SaulOrtegaVaz/ROMEO/Memoria/Bibliografia.docx

# Bibliografía

[1] Juan González Gómez. Robótica modular y locomoción: Aplicación a robots ápodos, 2008.

[2] Juan González Gómez. Diseño de robots ápodos, 2003.

[3] Mark Yim, Paul White, Michael Park, Jimmy Sastra, School of Engineering and Applied Science University of Pennsylvania. Modular Self-Reconfigurable Robots.

[4] Robo-wunderkind. The Story of Robo-Wunderkind. Disponible en línea en: http://robowunderkind.com/

[5] MIT Media Lab y Stanford University. LineFORM: Actuated Curve Interfaces for Display, Interaction, and Constraint, 2015. Disponible en línea en: http://tangible.media.mit.edu/papers/

[6] MIT Media Lab y Stanford University. ChainFORM: A Linear Integrated Modular Hardware System for Shape Changing Interfaces, 2015. Disponible en línea en: http://tangible.media.mit.edu/papers/

[7] Ivan Grokhotkov. ESP8266 Arduino Core Documentation, 2017. Disponible en línea en: https://arduino-esp8266.readthedocs.io/en/latest/index.html

[8] Espressif Systems. ESP8266EX datasheet, versión 5.8, 2018. Disponible en línea en: https://www.espressif.com/en

[9] Espressif Systems. ESP8266 Technical Reference, versión 1.3, 2017. Disponible en línea en: https://www.espressif.com/en

[10] Alberto Brunete, Avinash Ranganath, Sergio Segovia, Javier Perez de Frutos, Miguel Hernando and Ernesto Gambao, International Journal of Advanced Robotic Sistems. Current trends in reconfigurable modular robots design, 2017.

[11] Castano A, Shen WM and Will P. CONRO: towards deployable robots with inter-robots metamorphic capabilities. Auton Robot 2000; 8(3): 309–324.

[12] Castano A, Behar A and Will P. The Conro modules for reconfigurable robots. IEEE/ASME Trans Mech 2002; 7(4): 403–409.

[13] Yim M, Duff D and Roufas K. Polybot: a modular reconfigurable robot. In: Proceedings of the 2000 IEEE international conference on robotics and automation, 2000, pp. 514–520.

[14] Salemi B, Moll M and Shen WM. Superbot: a deployable, multi-functional, and modular self-reconfigurable robotic system. In: 2006 IEEE/RSJ international conference on intelligent robots and systems, 2006, pp. 3636–3641.

[15] Murata S, Yoshida E, Kamimura A, et al. M-tran: selfreconfigurable modular robotic system. IEEE/ASME Trans Mech 2002; 7(4): 431–441.

[16] Kurokawa H, Kamimura A, Yoshida E, et al. M-tran ii: metamorphosis from a four-legged walker to a caterpillar. In: Proceedings of the 2003 IEEE/RSJ international conference on intelligent robots and systems, Vol. 3, 2003, pp. 2454–2459.

[17] M. Yim. Locomotion with a unit-modular reconfigurable robot. PhD thesis, Stanfofd University, December 1995. Disponible en línea en:

http://www-db.stanford.edu/TR/CS-TR-95-1536.html

[18] Jørgensen M, Østergaard E, Lund H. Modular ATRON: modules for a self-reconfigurable robot. In: Proceedings of the 2004 IEEE/RSJ International Conference on Intelligent Robots and Systems (IROS), October 2004, pp 2068–2073.
