SaulOrtegaVaz/ROMEO/Alimentacion.FCStd

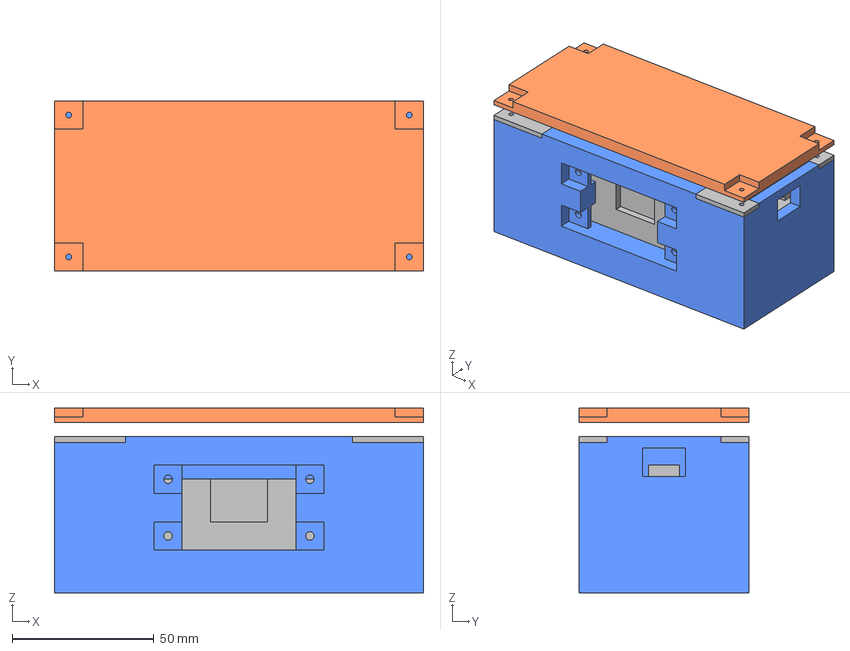
[picture p60: CAD file, 2018-03-30]
Alimentacion.FCStd
130.0 x 60.0 x 65.0 mm
Tapa
Carcasa_Alimentacion_final
Soporte
