SaulOrtegaVaz/ROMEO/Memoria/Planos/Alimentacion/Alimentacion_SeccionXZ.FCStd

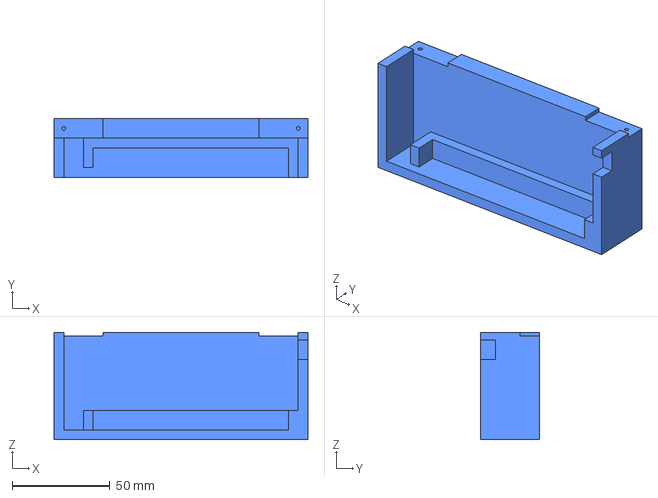
[picture p61: CAD file, 2019-01-21]
Memoria/Planos/Alimentacion/Alimentacion_SeccionXZ.FCStd
130.0 x 30.0 x 55.0 mm
