SaulOrtegaVaz/ROMEO/stl/ConectorMSup.stl

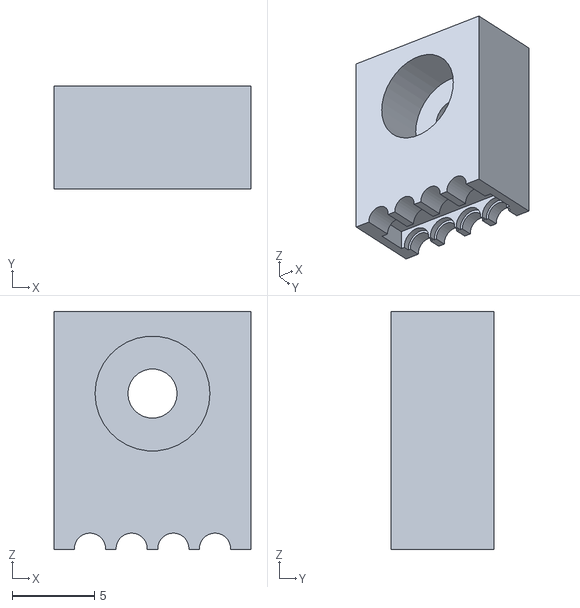
[picture p62: CAD file, 2018-06-27]
stl/ConectorMSup.stl
12.0 x 6.25 x 14.5
