SaulOrtegaVaz/ROMEO/Control.FCStd

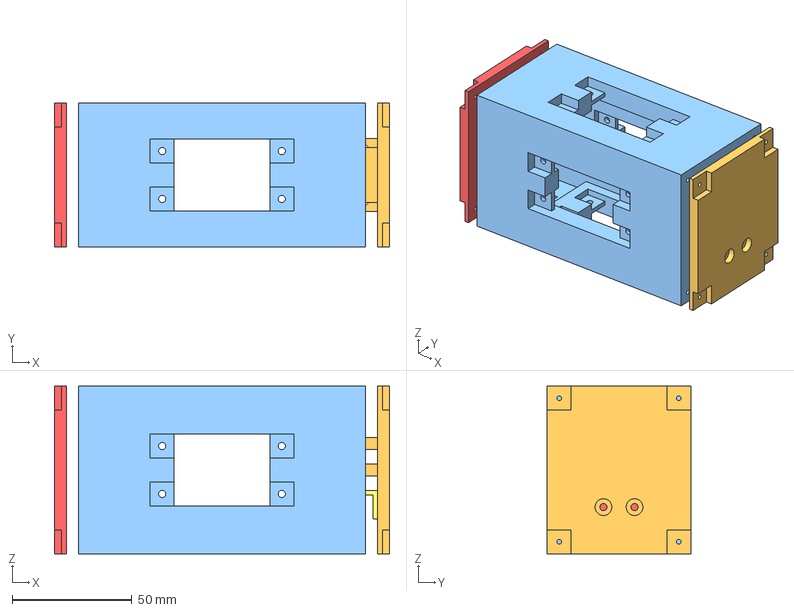
[picture p63: CAD file, 2018-03-30]
Control.FCStd
140.0 x 60.0 x 70.0 mm
TapaA
Carcasa_Control
SoporteMovil
TapaB
