SaulOrtegaVaz/ROMEO/Memoria/Planos/Alimentacion/Alimentacion_SeccionYZ.FCStd

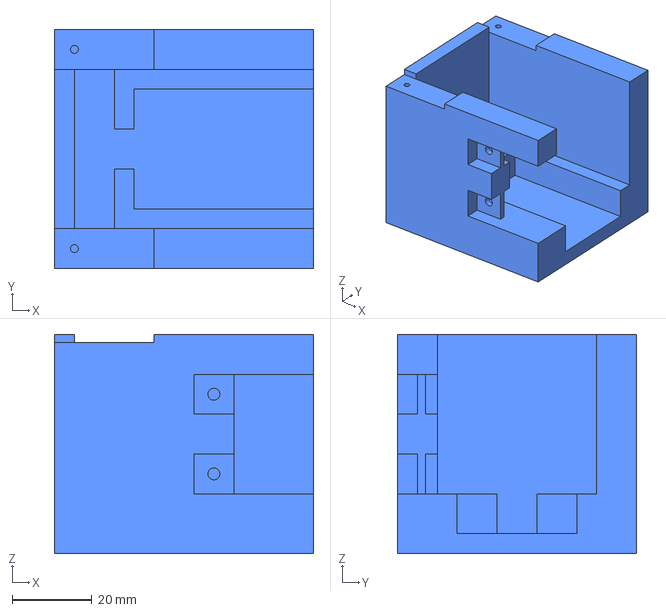
[picture p64: CAD file, 2019-01-21]
Memoria/Planos/Alimentacion/Alimentacion_SeccionYZ.FCStd
65.0 x 60.0 x 55.0 mm
