SaulOrtegaVaz/ROMEO/stl/ConectorSUP.stl

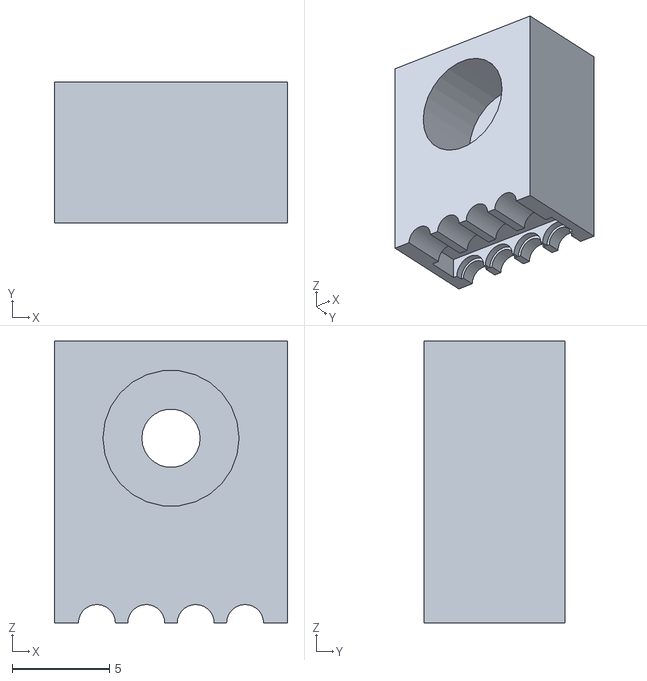
[picture p65: CAD file, 2018-06-27]
stl/ConectorSUP.stl
12.0 x 7.25 x 14.5
