SaulOrtegaVaz/ROMEO/Conector.FCStd

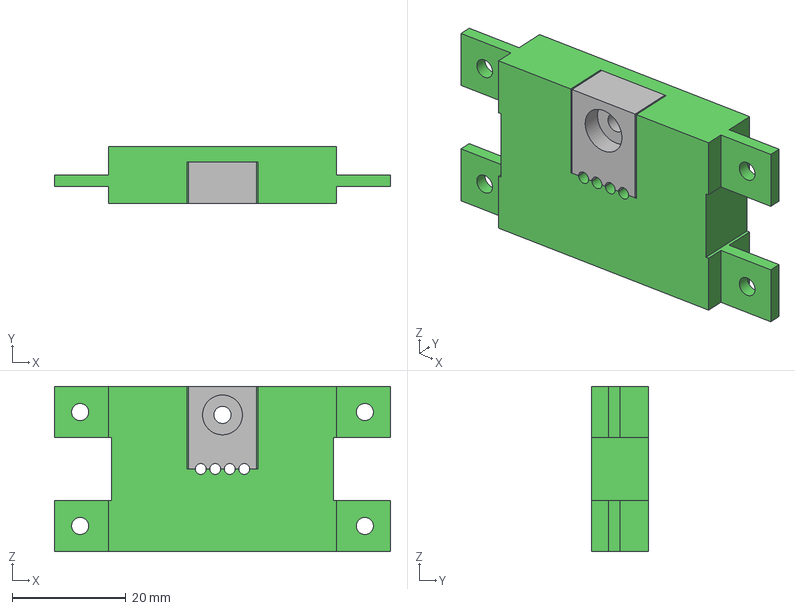
[picture p66: CAD file, 2018-03-09]
Conector.FCStd
59.0 x 10.0 x 29.0 mm
Imanes20x10x3
Conector_ParteSUP
Conector_ParteINF
