SaulOrtegaVaz/ROMEO/stl/ConectorMInf.stl

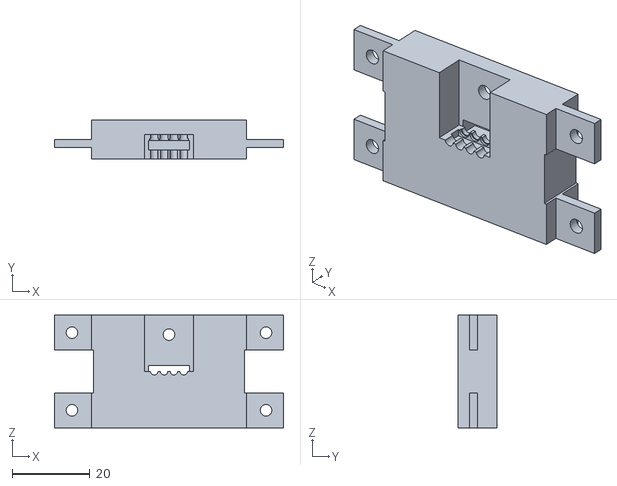
[picture p67: CAD file, 2018-06-04]
stl/ConectorMInf.stl
59.0 x 10.0 x 29.0
