SaulOrtegaVaz/ROMEO/Comunicacion.FCStd

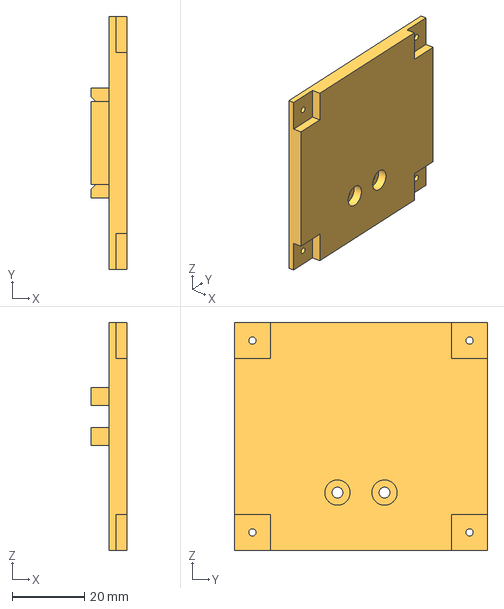
[picture p68: CAD file, 2018-03-09]
Comunicacion.FCStd
10.0 x 70.0 x 63.0 mm
