SaulOrtegaVaz/ROMEO/Locomocion.FCStd

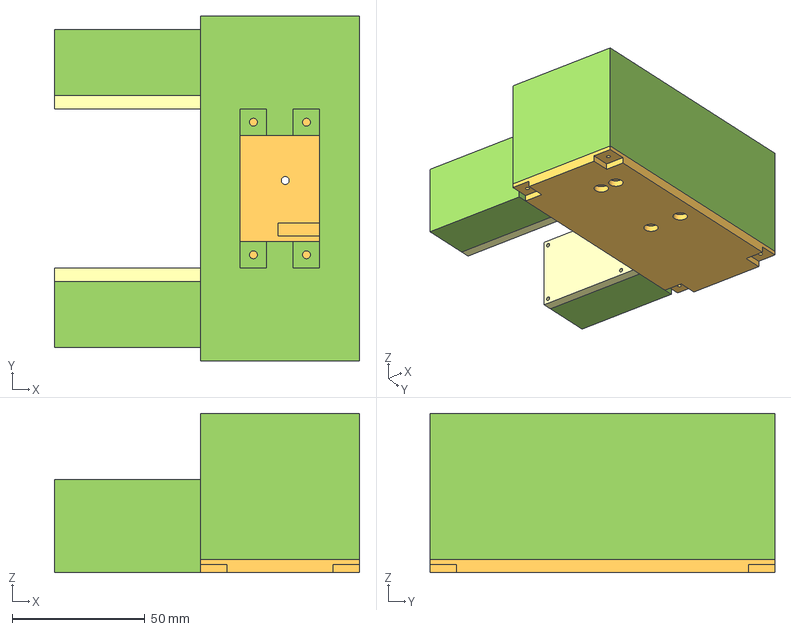
[picture p69: CAD file, 2018-03-09]
Locomocion.FCStd
115.0 x 130.0 x 60.0 mm
Carcasa_Locomocion
TapasMotor
Soporte5v_base_3
Tapa
