SaulOrtegaVaz/ROMEO/stl/Locomocion_TapaMotor.stl

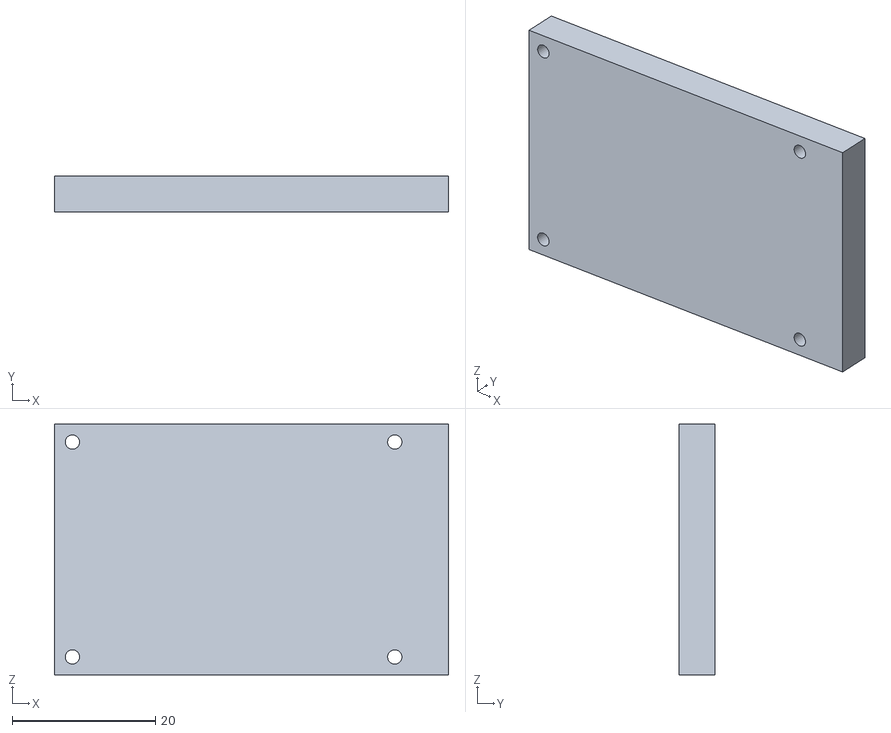
[picture p70: CAD file, 2018-04-26]
stl/Locomocion_TapaMotor.stl
55.0 x 5.00 x 35.0
