SaulOrtegaVaz/ROMEO/General.FCStd

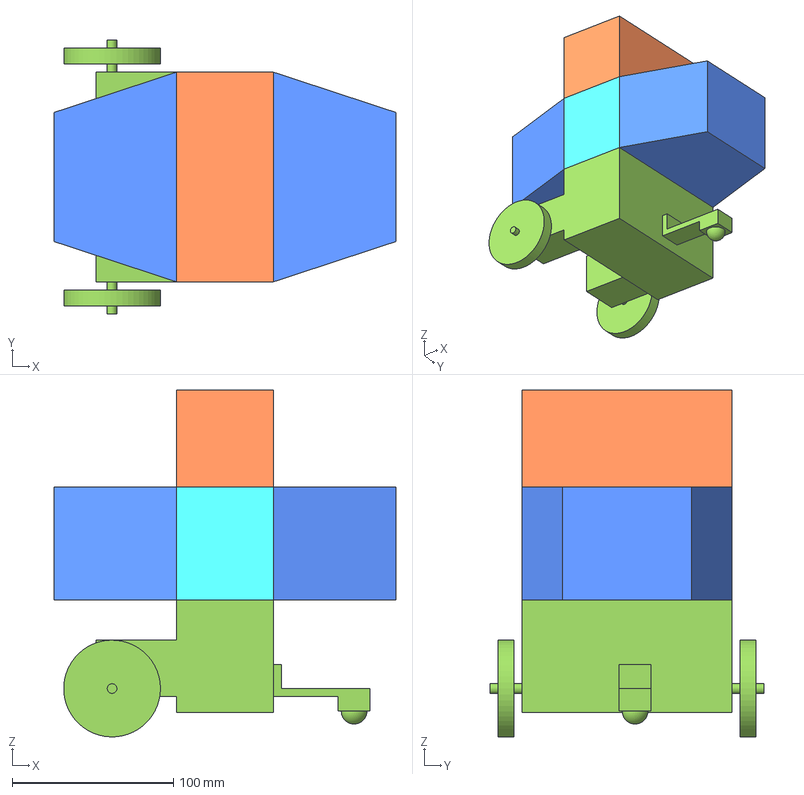
[picture p71: CAD file, 2018-01-18]
General.FCStd
212.0 x 170.0 x 215.0 mm
Control
Alimentacion
Comunicacion
Locomocion
