SaulOrtegaVaz/ROMEO/stl/Locomocion_Tapa.stl

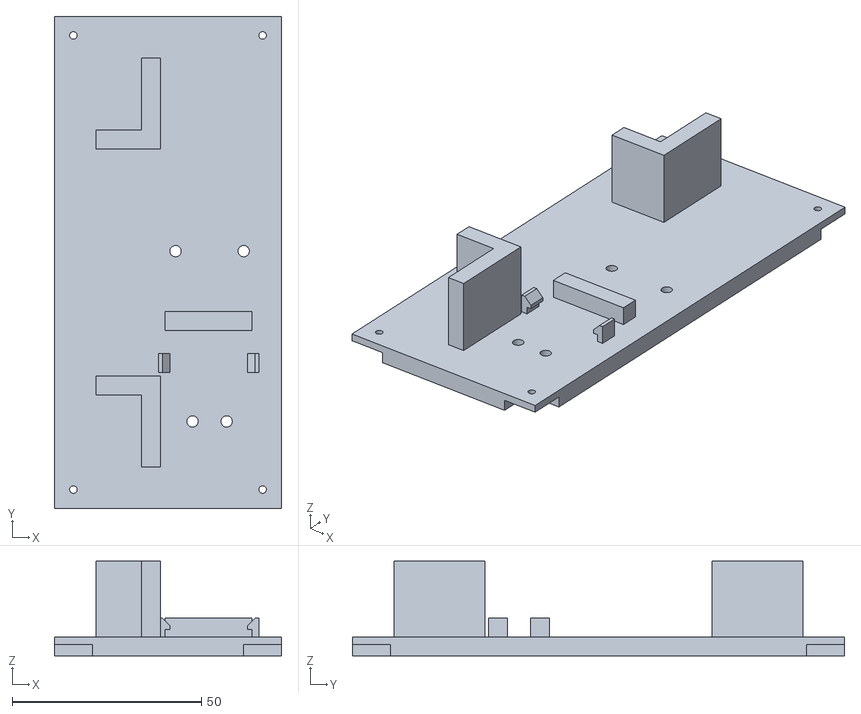
[picture p72: CAD file, 2018-04-26]
stl/Locomocion_Tapa.stl
60.0 x 130.0 x 25.0
