SaulOrtegaVaz/ROMEO/stl/Alimentacion_Tapa.stl

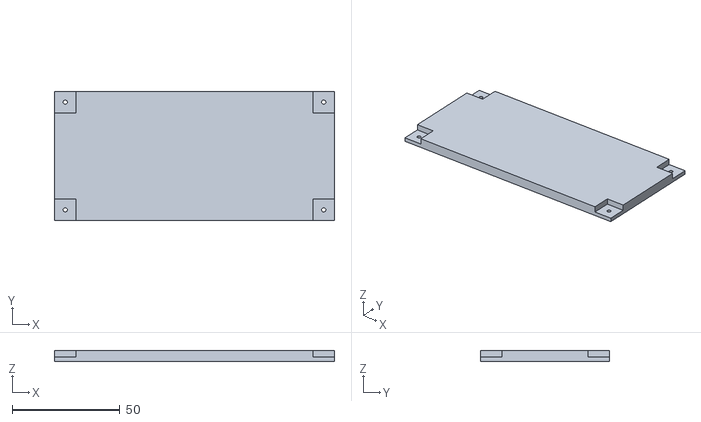
[picture p73: CAD file, 2018-04-25]
stl/Alimentacion_Tapa.stl
130.0 x 60.0 x 5.00
