SaulOrtegaVaz/ROMEO/stl/Alimentacion_Soporte.stl

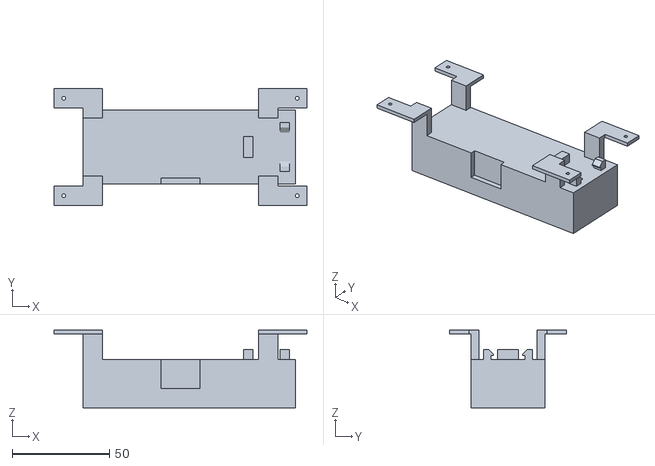
[picture p74: CAD file, 2018-04-25]
stl/Alimentacion_Soporte.stl
130.0 x 60.0 x 40.0
