SaulOrtegaVaz/ROMEO/stl/Control_TapaA.stl

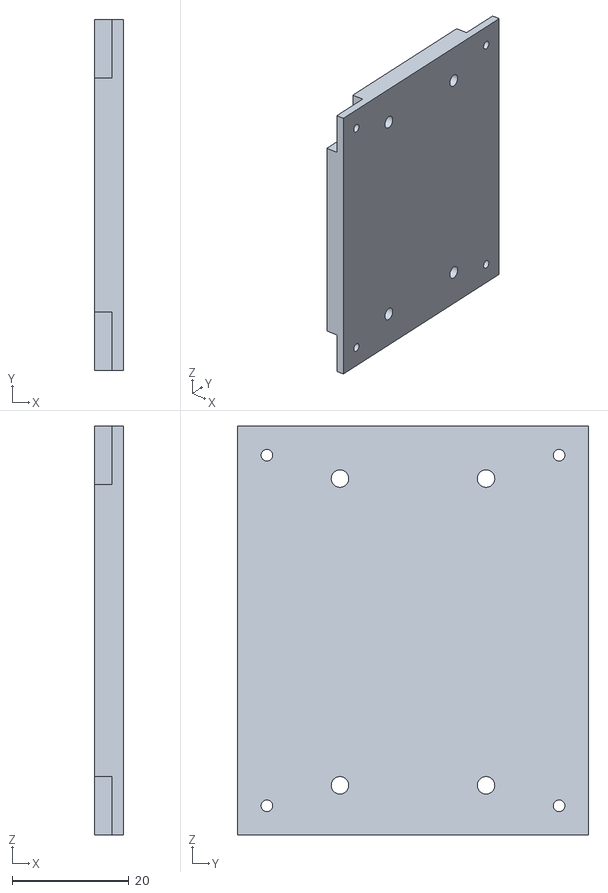
[picture p75: CAD file, 2018-04-25]
stl/Control_TapaA.stl
5.00 x 60.0 x 70.0
