SaulOrtegaVaz/ROMEO/stl/Comunicacion_Carcasa.stl

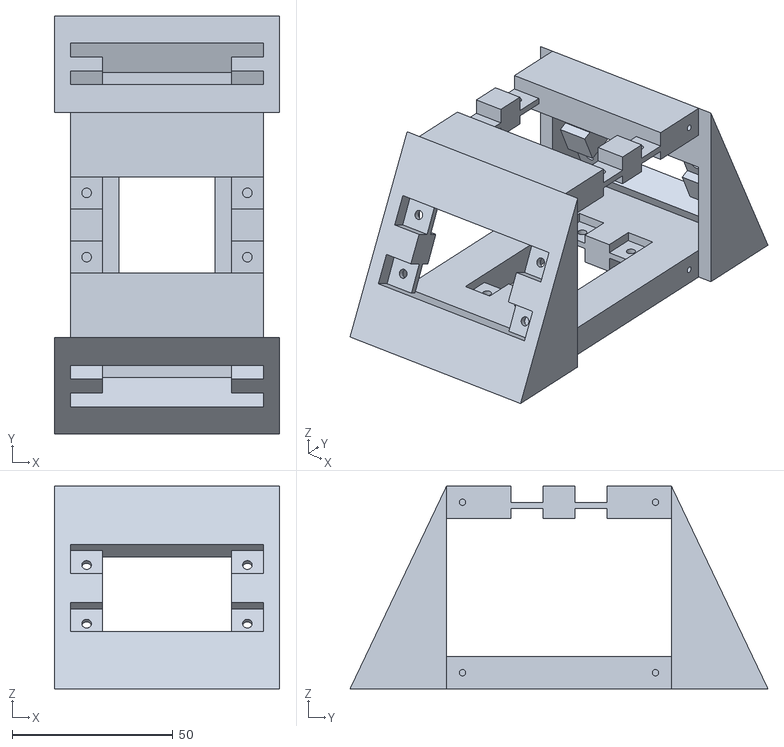
[picture p76: CAD file, 2018-04-25]
stl/Comunicacion_Carcasa.stl
70.0 x 130.0 x 63.0
