SaulOrtegaVaz/ROMEO/stl/Control_SoporteMovil.stl

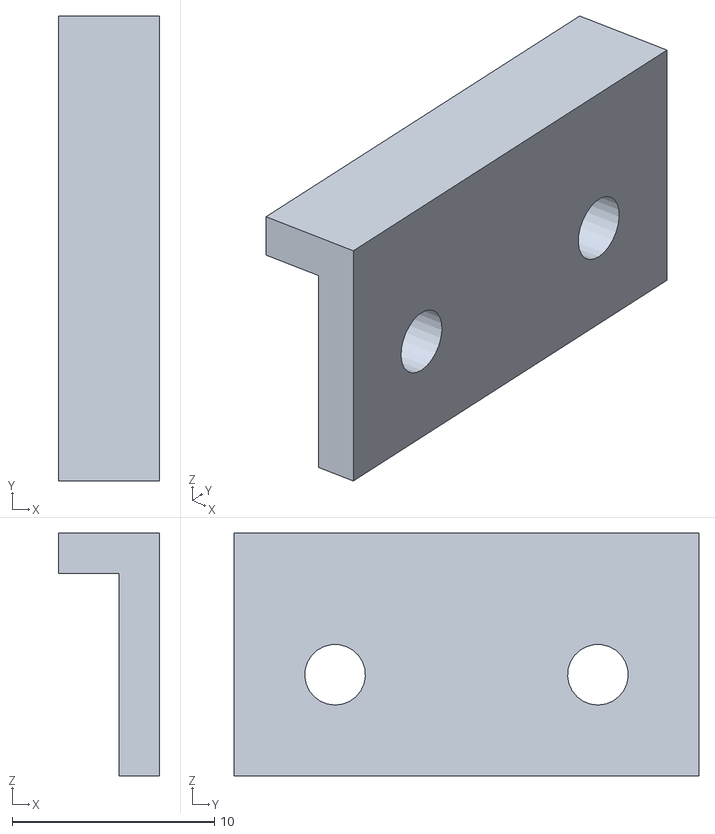
[picture p77: CAD file, 2018-04-25]
stl/Control_SoporteMovil.stl
5.00 x 23.0 x 12.0
