SaulOrtegaVaz/ROMEO/stl/Control_TapaB.stl

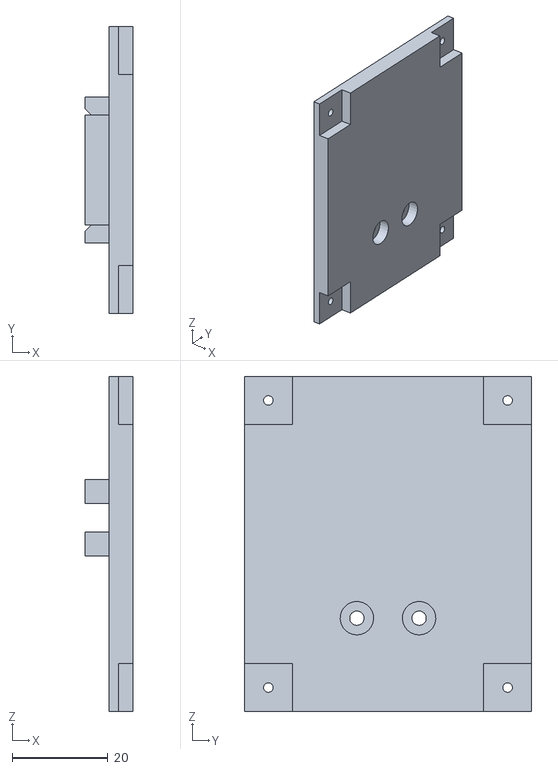
[picture p78: CAD file, 2018-04-25]
stl/Control_TapaB.stl
10.0 x 60.0 x 70.0
