SaulOrtegaVaz/ROMEO/stl/Locomocion_Soporte.stl

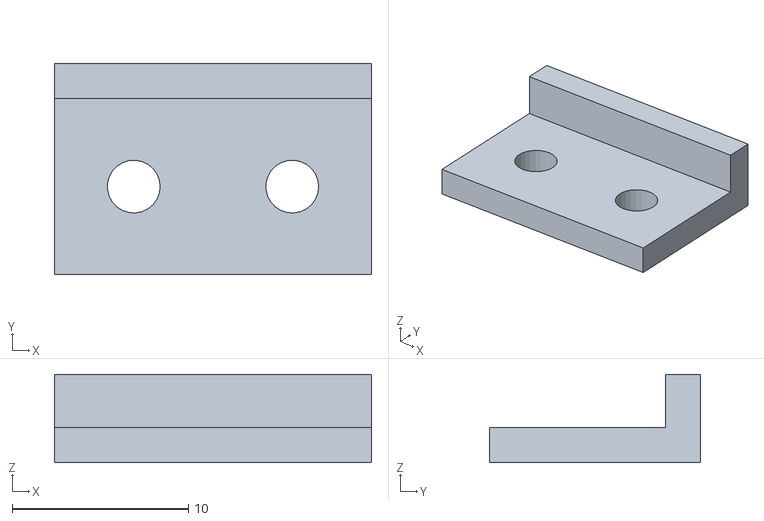
[picture p79: CAD file, 2018-04-25]
stl/Locomocion_Soporte.stl
18.0 x 12.0 x 5.00
