SaulOrtegaVaz/ROMEO/stl/Control_Carcasa.stl

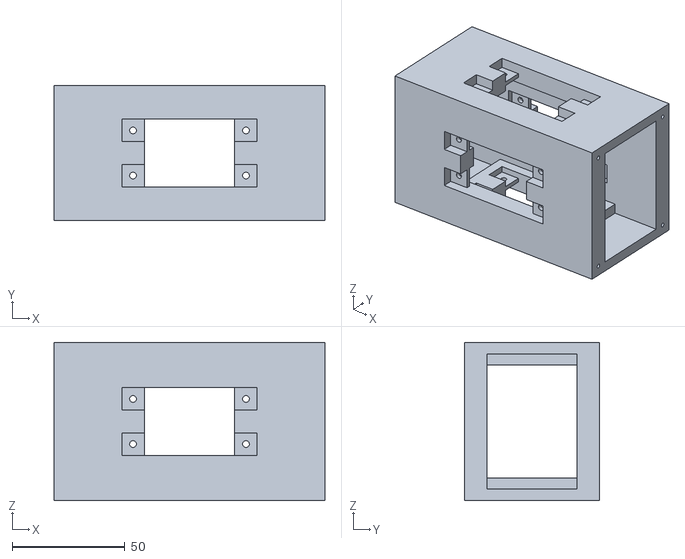
[picture p80: CAD file, 2018-04-25]
stl/Control_Carcasa.stl
120.0 x 60.0 x 70.0
