SaulOrtegaVaz/ROMEO/stl/Alimentacion_Carcasa.stl

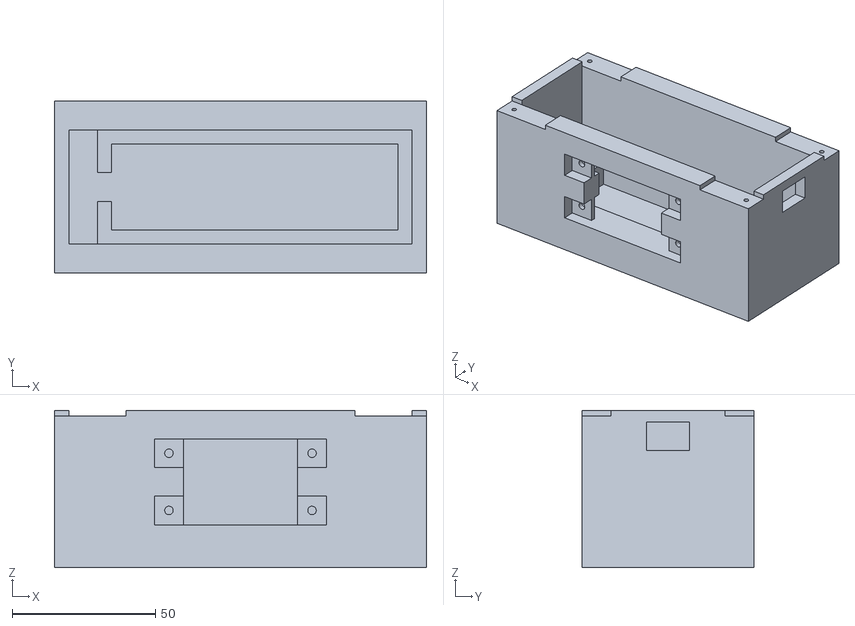
[picture p81: CAD file, 2018-04-25]
stl/Alimentacion_Carcasa.stl
130.0 x 60.0 x 55.0
