SaulOrtegaVaz/ROMEO/stl/Comunicacion_TapaA.stl

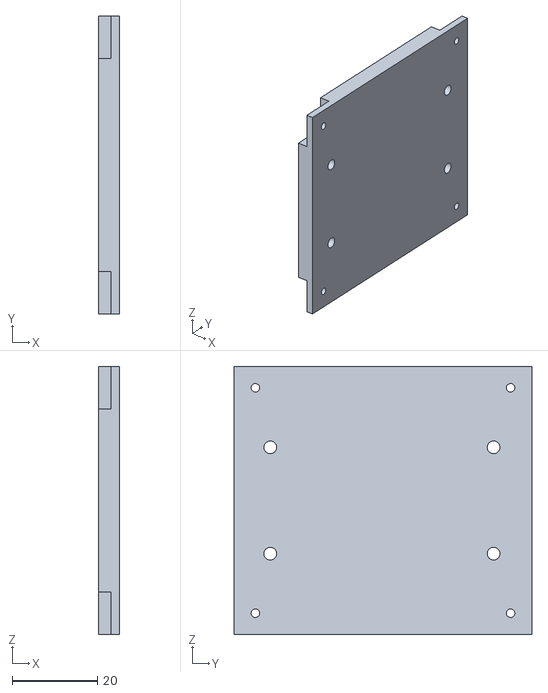
[picture p82: CAD file, 2018-04-25]
stl/Comunicacion_TapaA.stl
5.00 x 70.0 x 63.0
