SaulOrtegaVaz/ROMEO/stl/Locomocion_Carcasa.stl

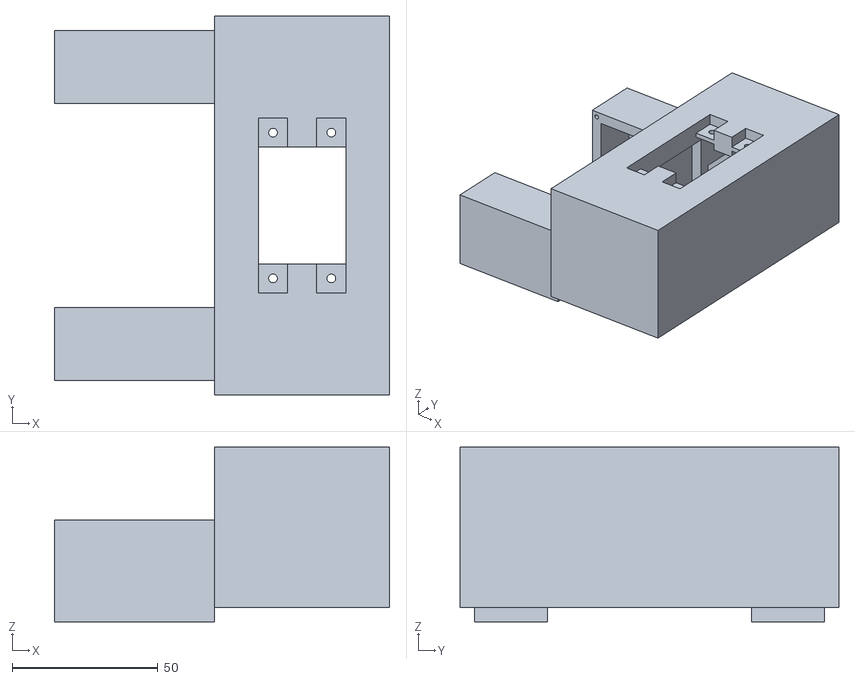
[picture p83: CAD file, 2018-04-25]
stl/Locomocion_Carcasa.stl
115.0 x 130.0 x 60.0
