SaulOrtegaVaz/ROMEO/(list of files, cad)

Other CAD files:
stl/ConectorINF.stl
stl/Comunicacion_TapaB.stl
stl/Comunicacion_SoporteB_Movil.stl
