SaulOrtegaVaz/ROMEO/Memoria/Planos/Alimentacion/AlimentacionSoporte_Alzado.pdf

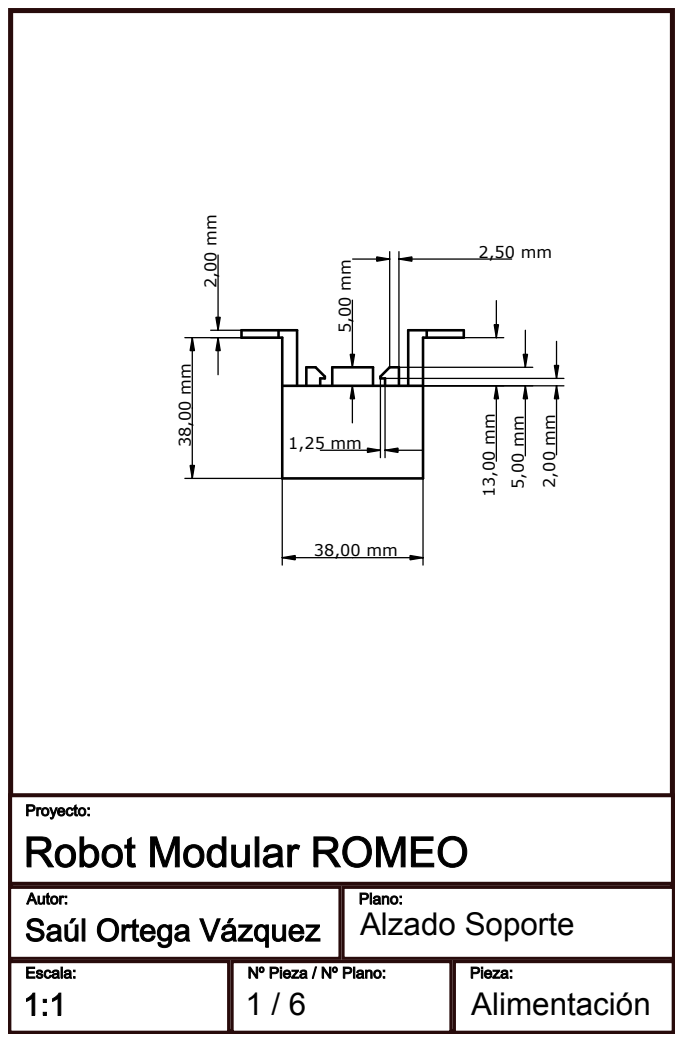
[picture p84: page 1]
1,25 mm⁵,00 mm; Alimentación; Alzado Soporte
