SaulOrtegaVaz/ROMEO/Memoria/Planos/Alimentacion/AlimentacionSoporte_Planta.pdf

# 5,00 mm11,00 mm 3,00 mm

# 15,00 mm ⁵,00 mm 10,00 mm

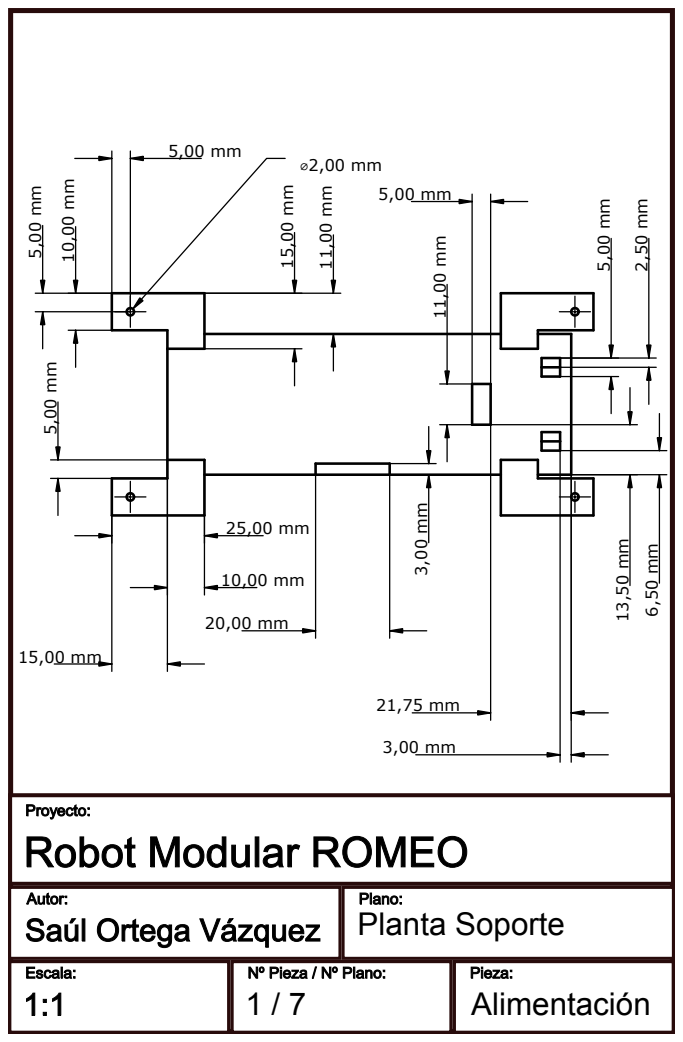
[picture p85: page 1]
Alimentación; Planta Soporte
