SaulOrtegaVaz/ROMEO/Memoria/Planos/Comunicacion/Comunicacion_AlzadoPostTapaB.pdf

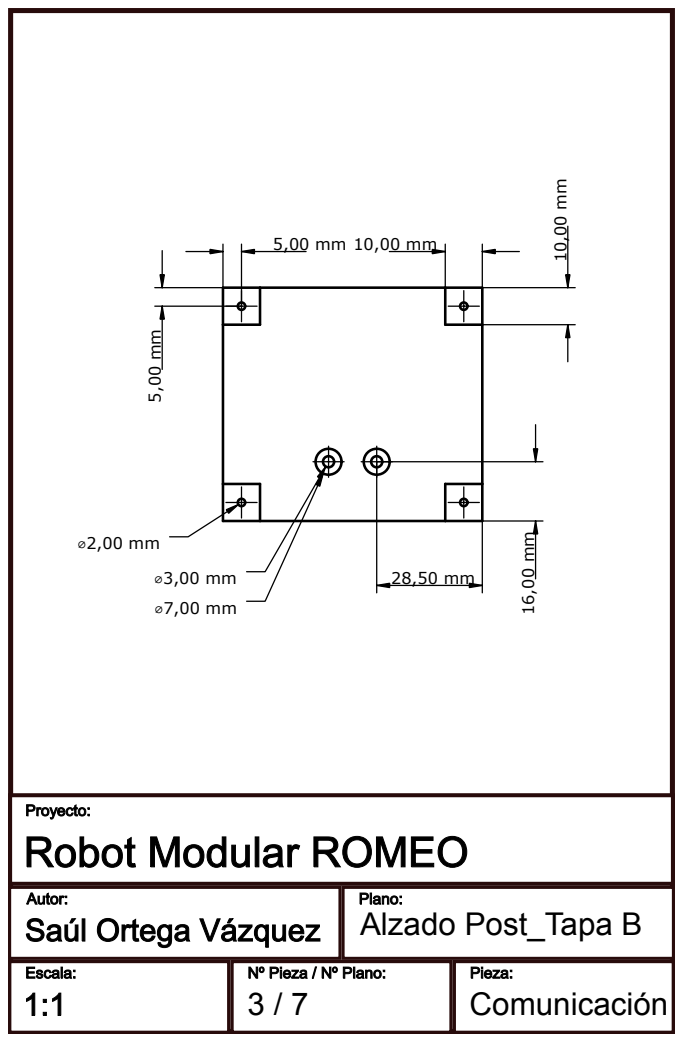
[picture p86: page 1]
⌀2,00 mm⁵,00 mm; Comunicación; Alzado Post_Tapa B
