SaulOrtegaVaz/ROMEO/Memoria/Planos/ConectorM/M_PerfilIzq_inf.pdf

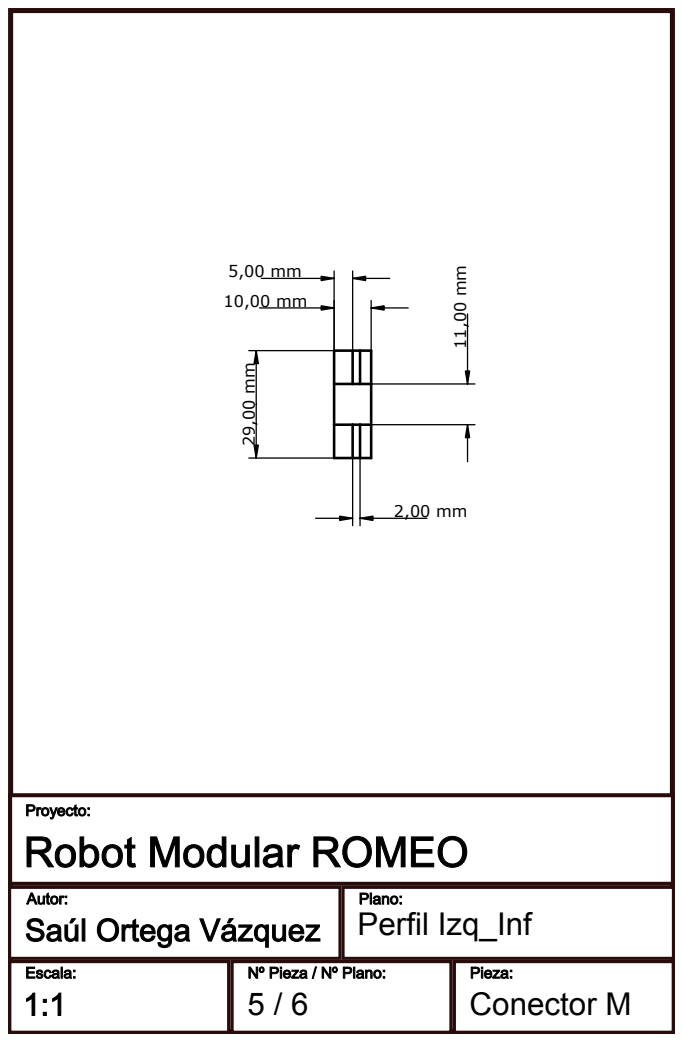
[picture p87: page 1]
2,00 mm¹¹,00 mm; Conector M; Perfil Izq_Inf
