SaulOrtegaVaz/ROMEO/Memoria/Planos/Control/Control_AlzadoTapaA.pdf

# ⌀2,00 mm¹⁰,00 mm

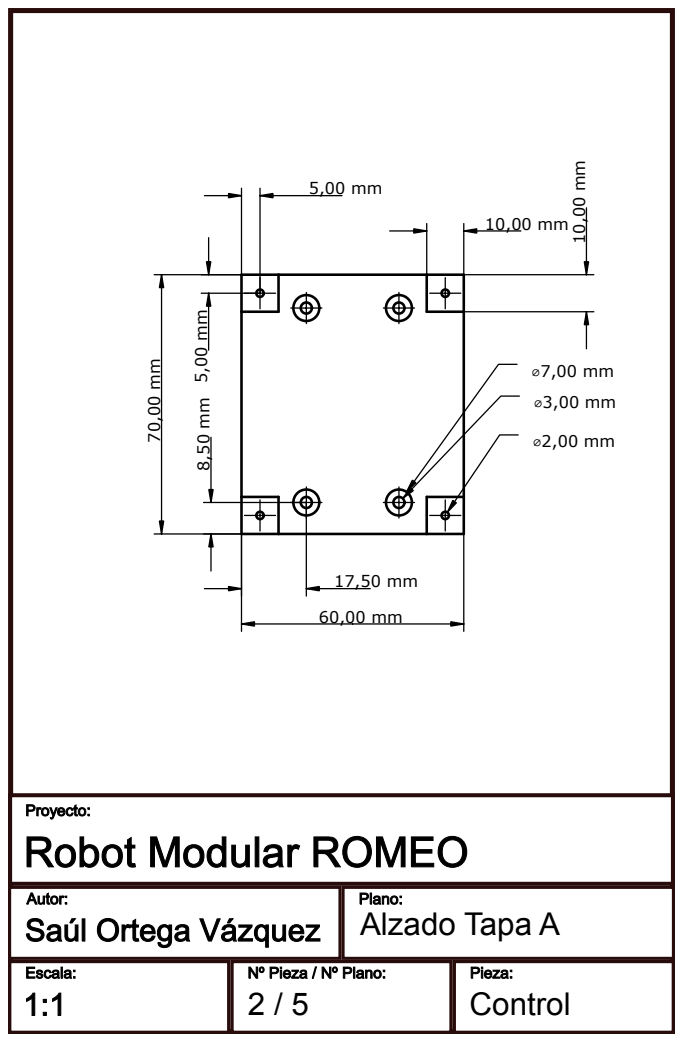
[picture p88: page 1]
Control; Alzado Tapa A
