SaulOrtegaVaz/ROMEO/Memoria/Planos/Locomocion/Axonometrico_TapaMotor.pdf

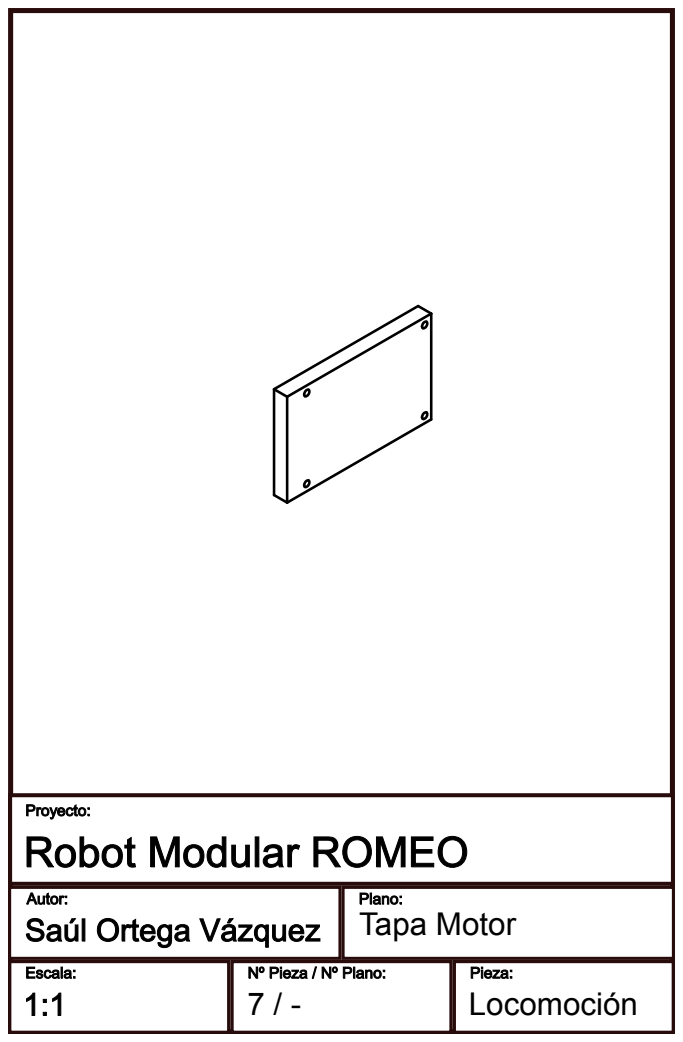
[picture p89: page 1]
Tapa Motor; Locomoción
