SaulOrtegaVaz/ROMEO/Memoria/Planos/Locomocion/Locomocion_Planta.pdf

# 15,00 mm35,00 mm 60,00 mm

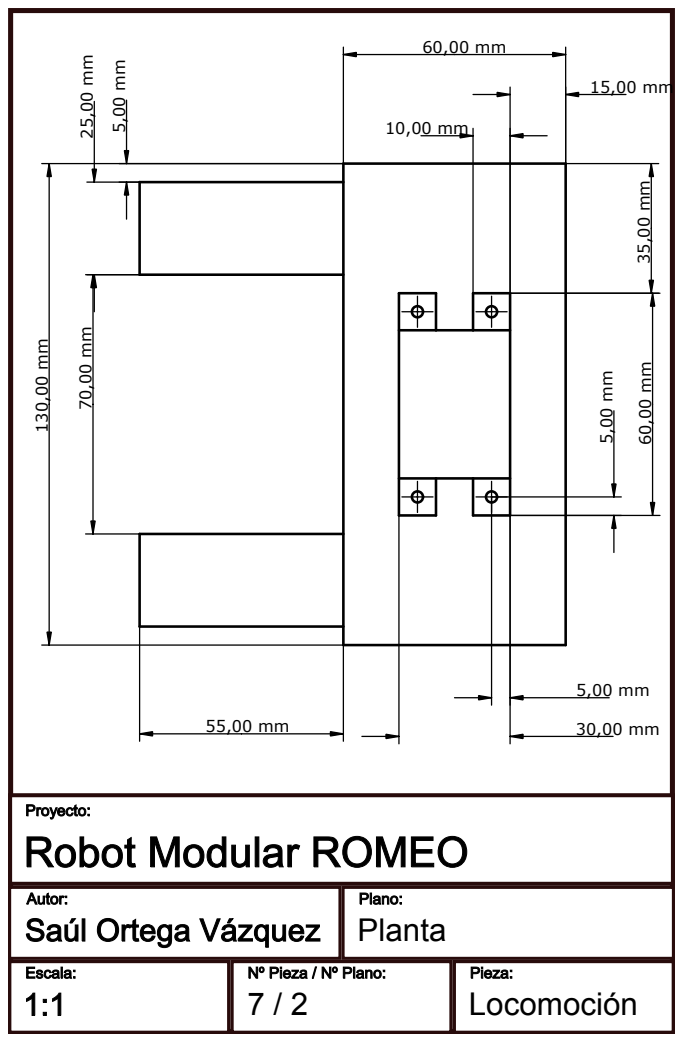
[picture p90: page 1]
Planta; Locomoción
