SaulOrtegaVaz/ROMEO/Memoria/Planos/Locomocion/Locomocion_Soporte.pdf

# 4,50 mm 7,00 mm

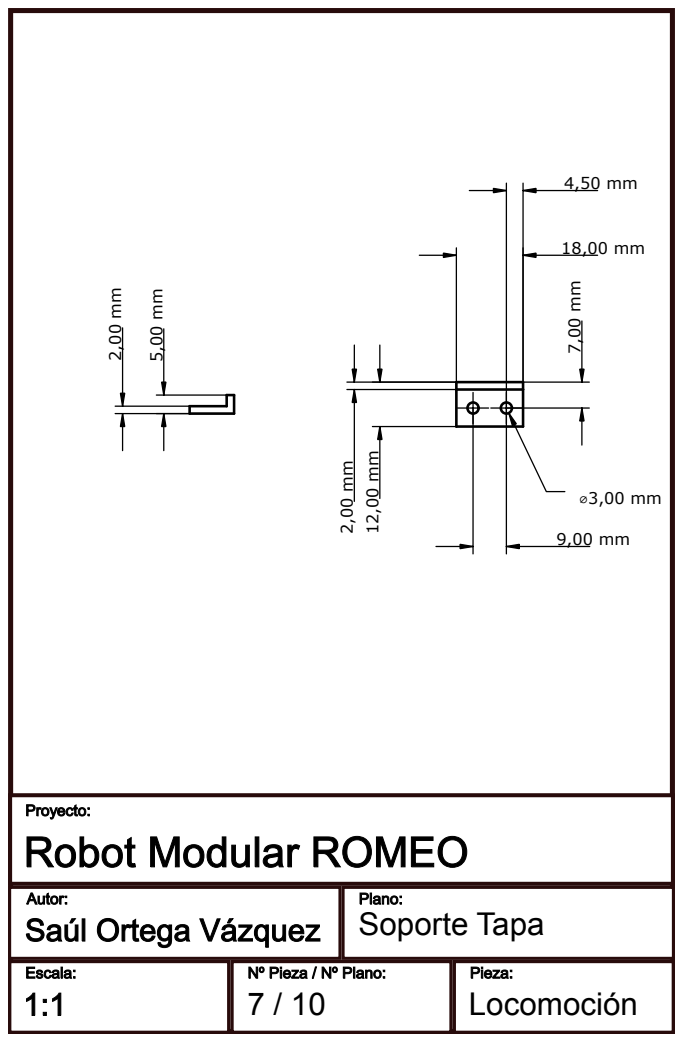
[picture p91: page 1]
Locomoción; Soporte Tapa
