SaulOrtegaVaz/ROMEO/Memoria/Planos/Sensor/Sensor_Axonometrico.pdf

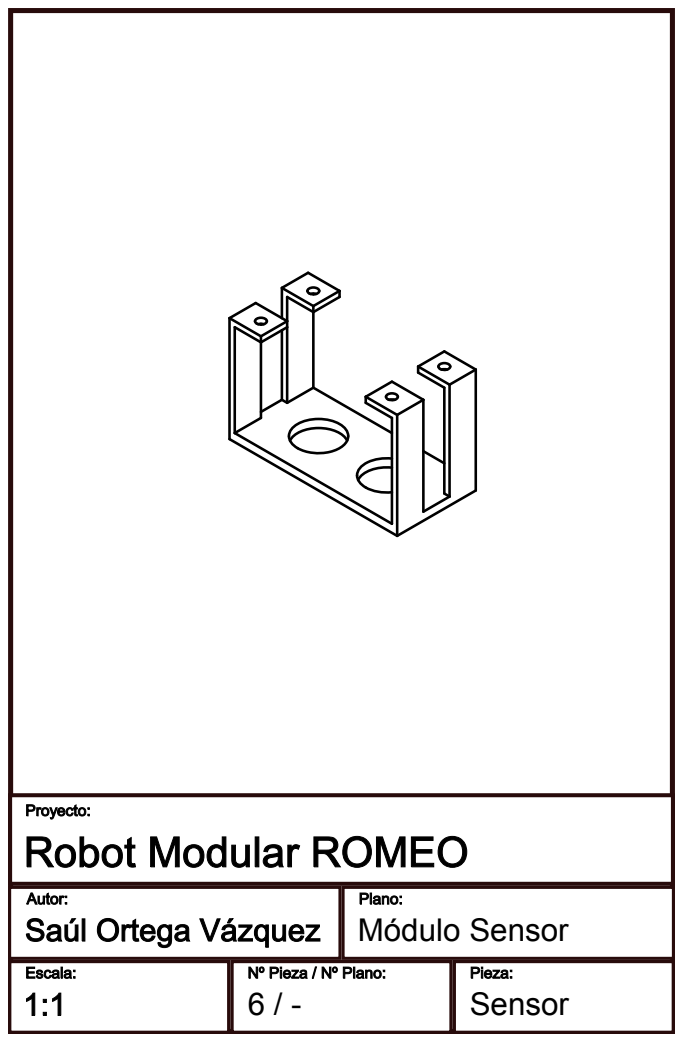
[picture p92: page 1]
Sensor; Módulo Sensor
