SaulOrtegaVaz/ROMEO/Memoria/Planos/Sensor/Sensor_PerfilIzq.pdf

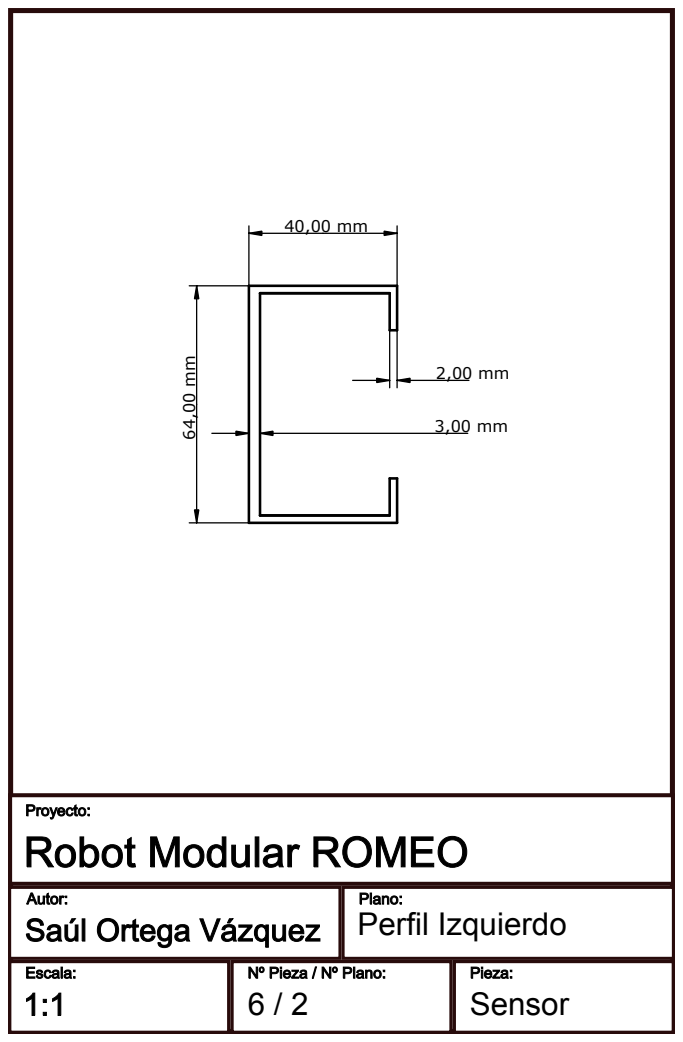
[picture p93: page 1]
Perfil Izquierdo; Sensor
