SaulOrtegaVaz/ROMEO/Memoria/Planos/Sensor/Sensor_Planta.pdf

# 10,00 mm 12,00 mm

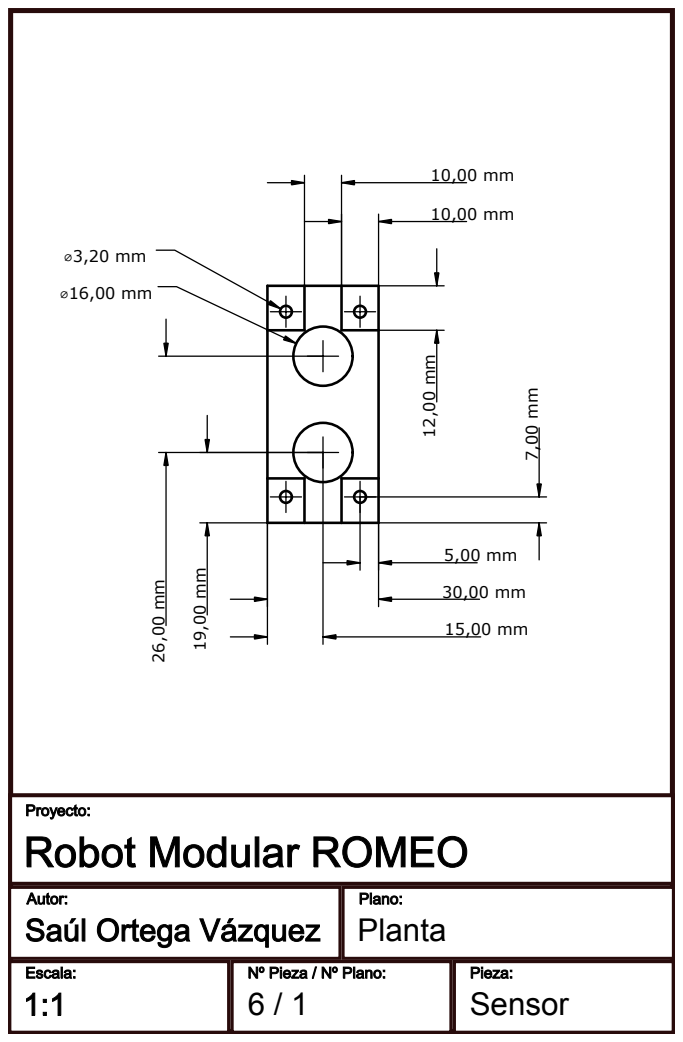
[picture p94: page 1]
Sensor; Planta
