SaulOrtegaVaz/ROMEO/Memoria/Planos/Alimentacion/Alimentacion_Alzado.pdf

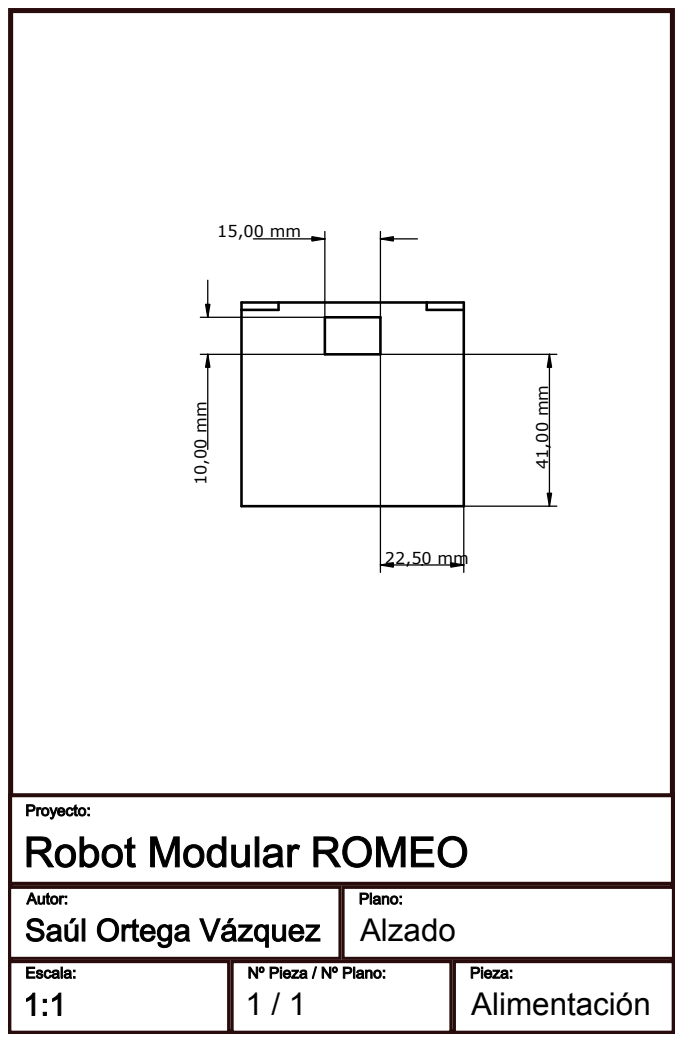
[picture p95: page 1]
Alzado; Alimentación
