SaulOrtegaVaz/ROMEO/Memoria/Planos/Alimentacion/Alimentacion_PerfilIzq.pdf

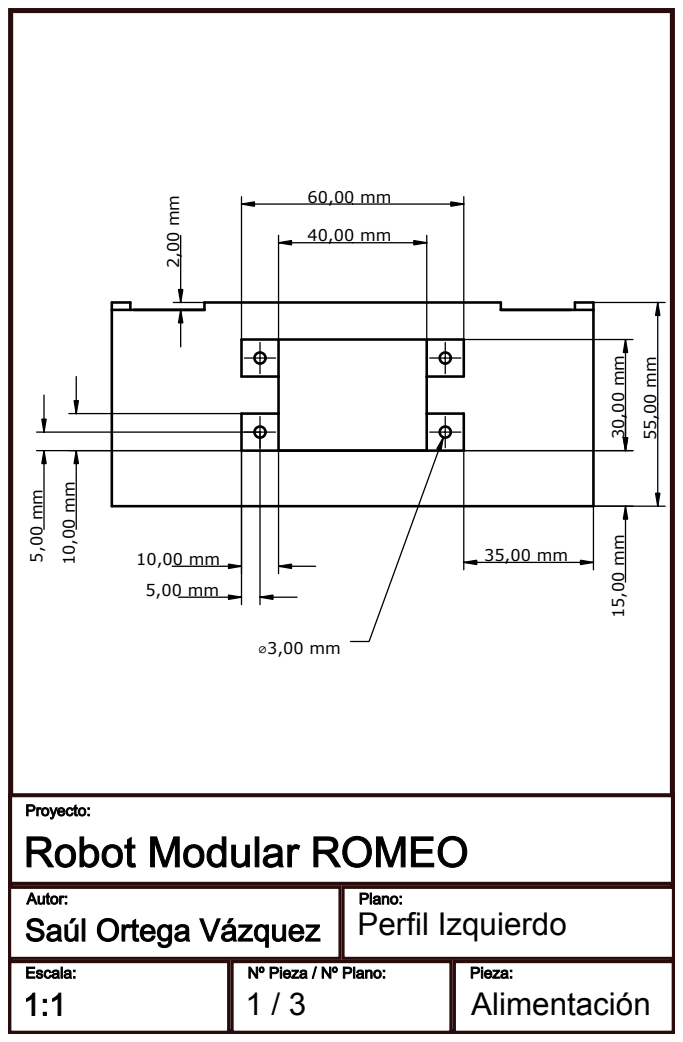
[picture p96: page 1]
Alimentación; Perfil Izquierdo
