SaulOrtegaVaz/ROMEO/Memoria/Planos/Alimentacion/Alimentacion_Planta.pdf

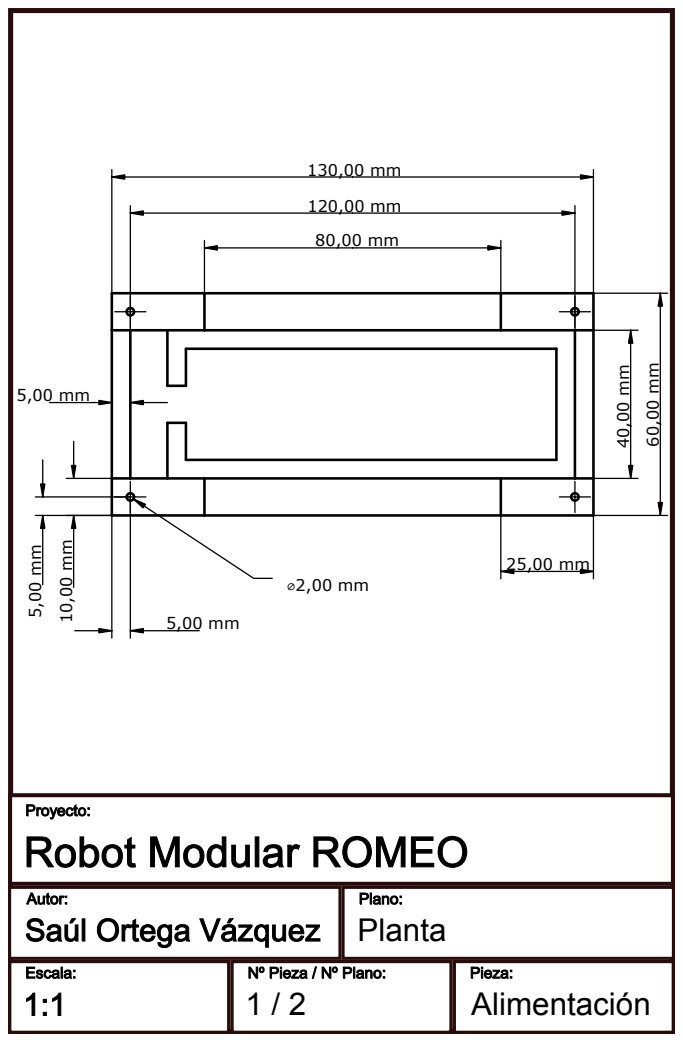
[picture p97: page 1]
Alimentación; Planta
