SaulOrtegaVaz/ROMEO/Memoria/Planos/Alimentacion/Alimentacion_SeccionXZ.pdf

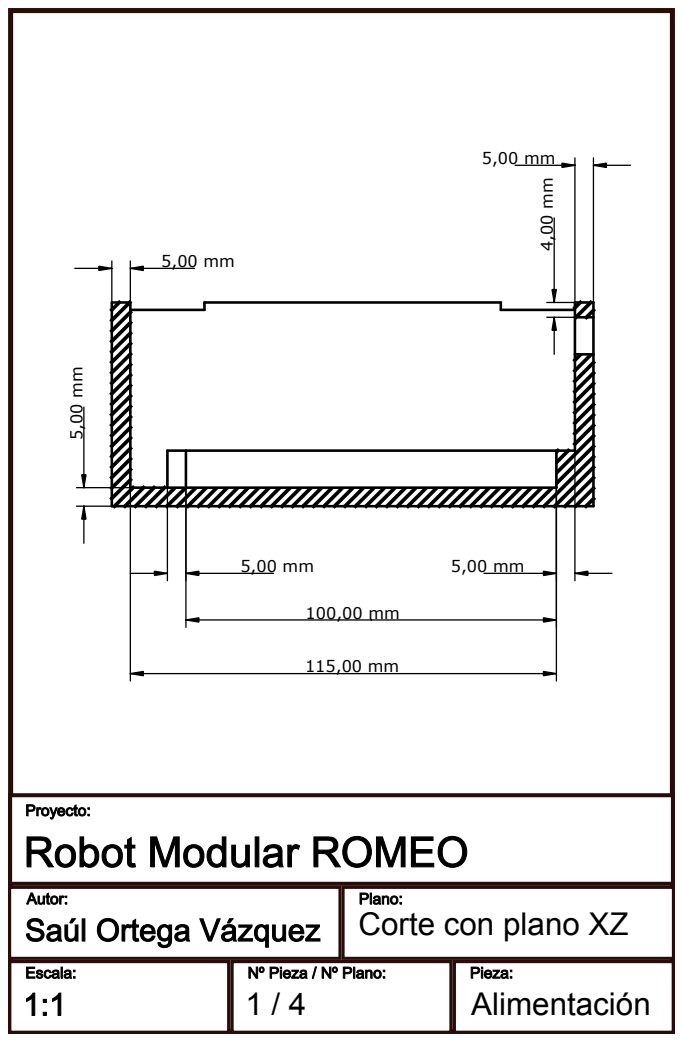
[picture p98: page 1]
Alimentación

Corte con plano XZ
