SaulOrtegaVaz/ROMEO/Memoria/Planos/Alimentacion/Alimentacion_SeccionYZ.pdf

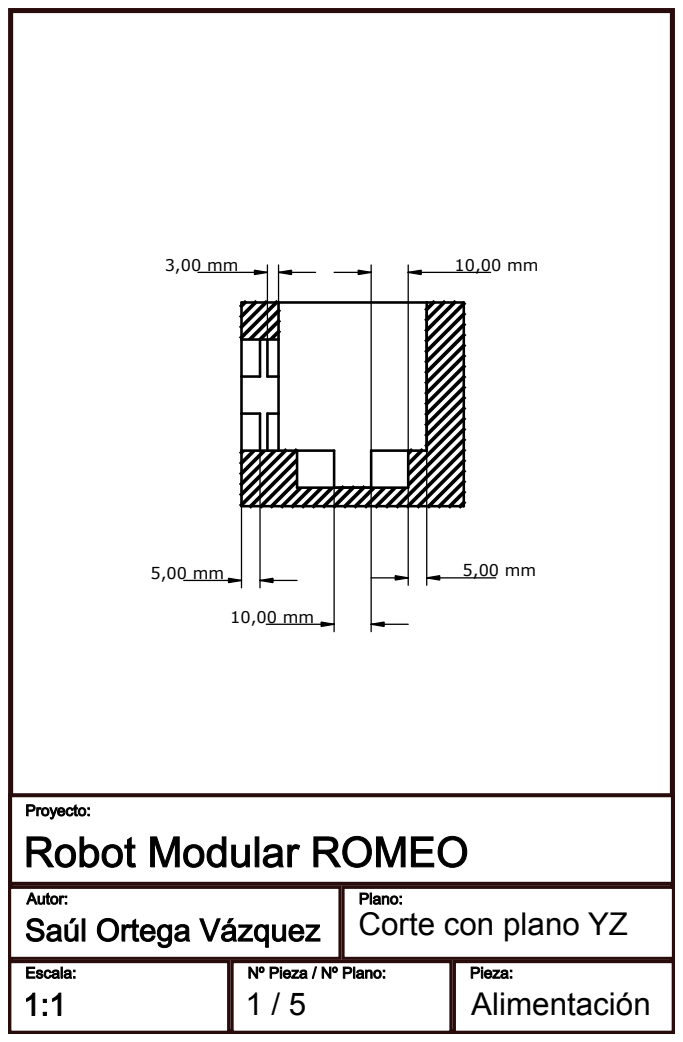
[picture p99: page 1]
Alimentación

Corte con plano YZ
