SaulOrtegaVaz/ROMEO/Memoria/Planos/Alimentacion/AlimentacionSoporte_PerfilIzq.pdf

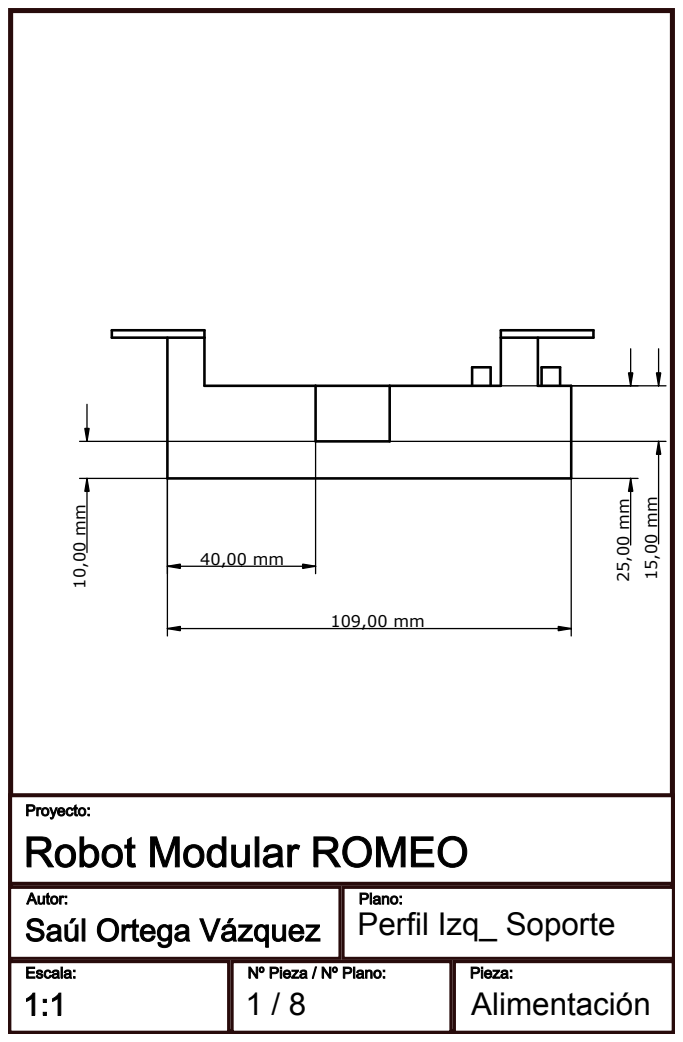
[picture p100: page 1]
Perfil Izq_ Soporte; Alimentación
