SaulOrtegaVaz/ROMEO/Memoria/Planos/Alimentacion/AlimentacionSoporte_SeccionXZ.pdf

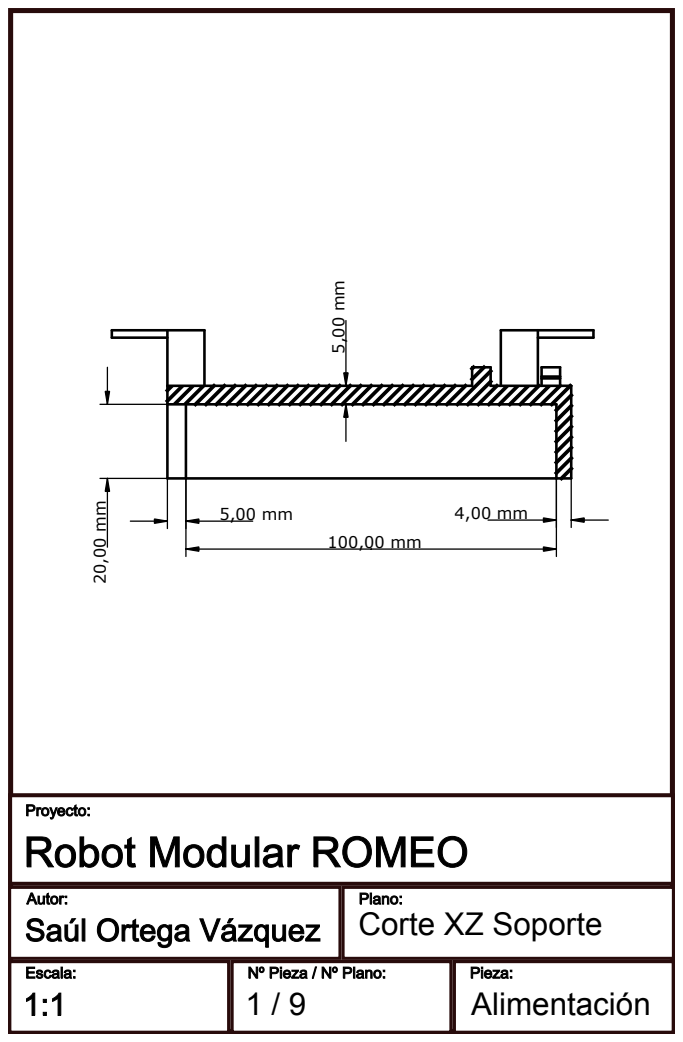
[picture p101: page 1]
Alimentación

Corte XZ Soporte
