SaulOrtegaVaz/ROMEO/Memoria/Planos/Alimentacion/AlimentacionTapa_Alzado.pdf

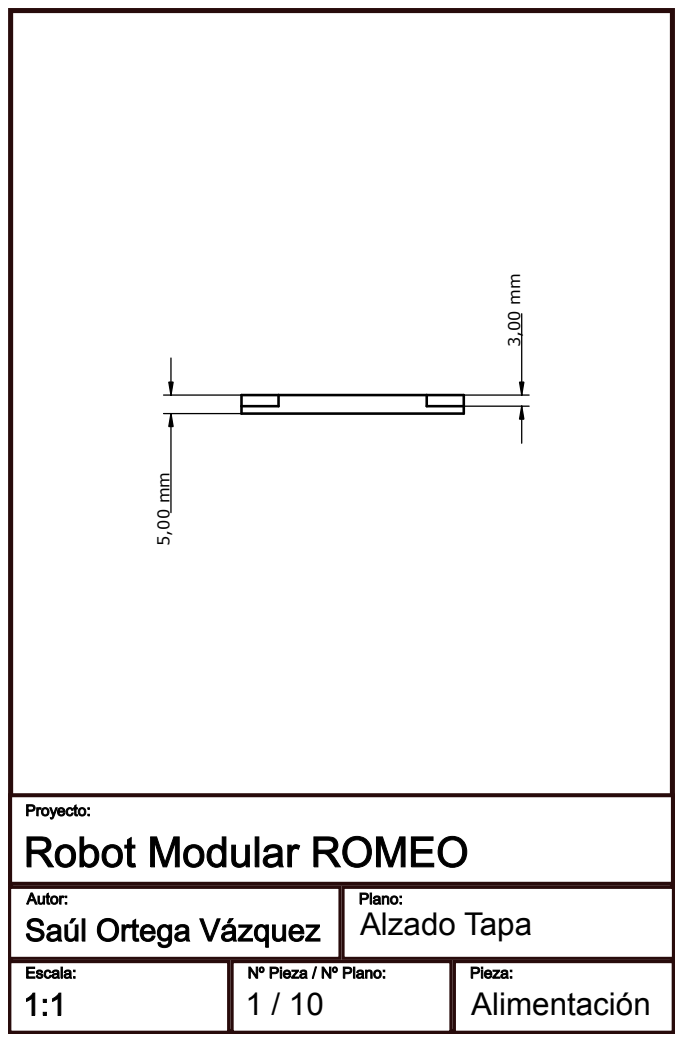
[picture p102: page 1]
Alimentación; Alzado Tapa
