SaulOrtegaVaz/ROMEO/Memoria/Planos/Alimentacion/AlimentacionTapa_Planta.pdf

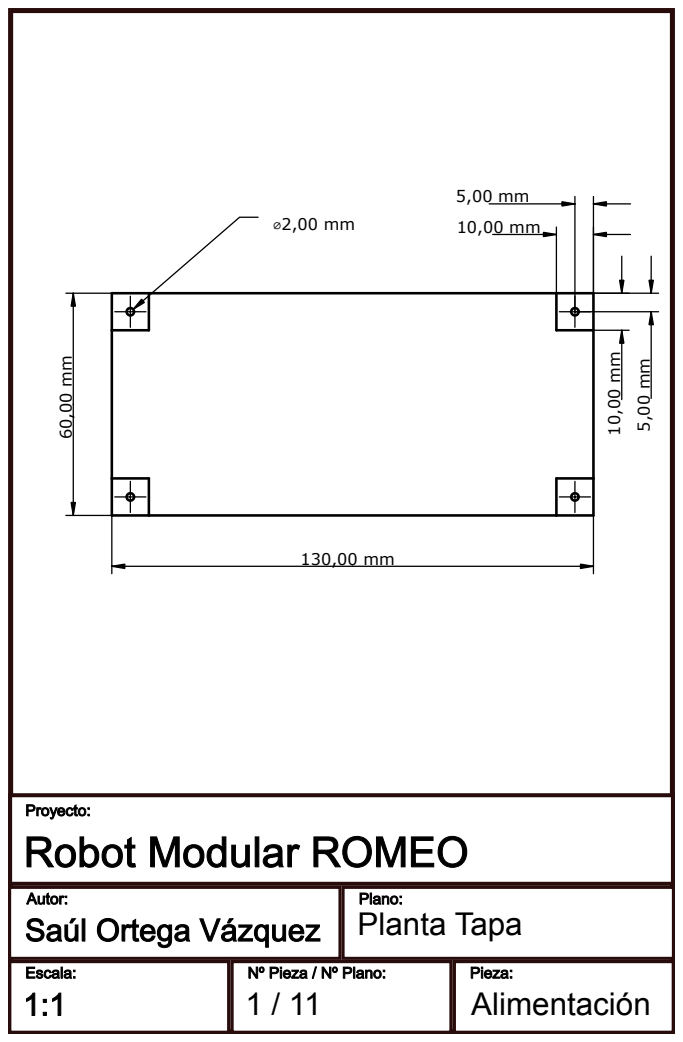
[picture p103: page 1]
Alimentación; Planta Tapa
