SaulOrtegaVaz/ROMEO/Memoria/Planos/Alimentacion/Axonometrico_Carcasa.pdf

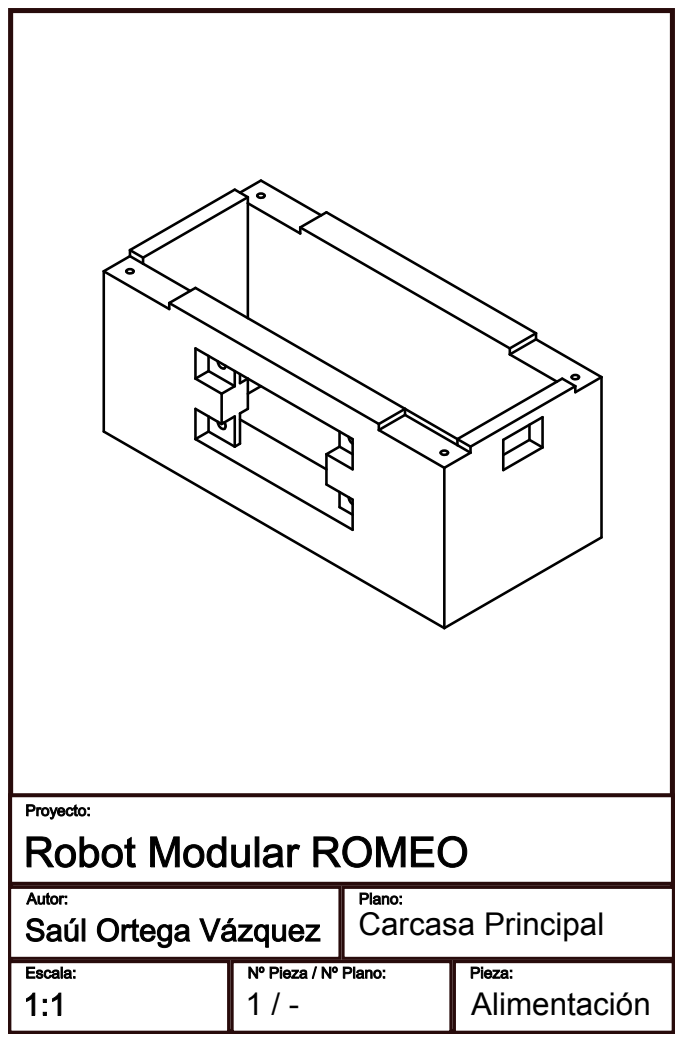
[picture p104: page 1]
Alimentación; Carcasa Principal
