SaulOrtegaVaz/ROMEO/Memoria/Planos/Alimentacion/Axonometrico_Soporte.pdf

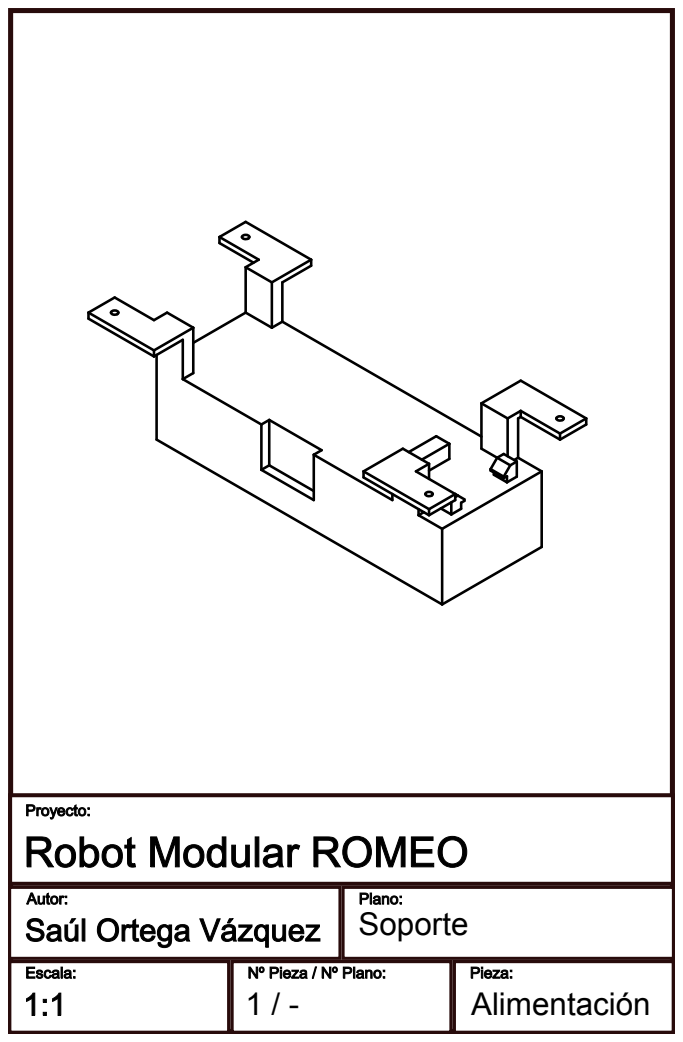
[picture p105: page 1]
Alimentación; Soporte
