SaulOrtegaVaz/ROMEO/Memoria/Planos/Alimentacion/Axonometrico_Tapa.pdf

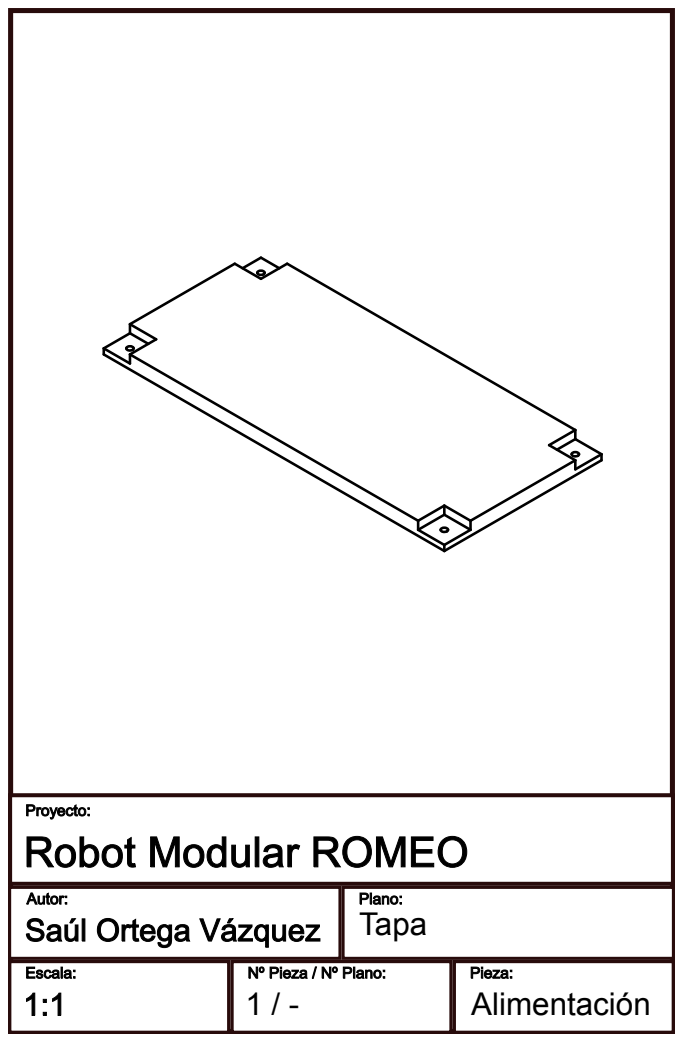
[picture p106: page 1]
Alimentación; Tapa
