SaulOrtegaVaz/ROMEO/Memoria/Planos/Comunicacion/Axonometrico_Carcasa.pdf

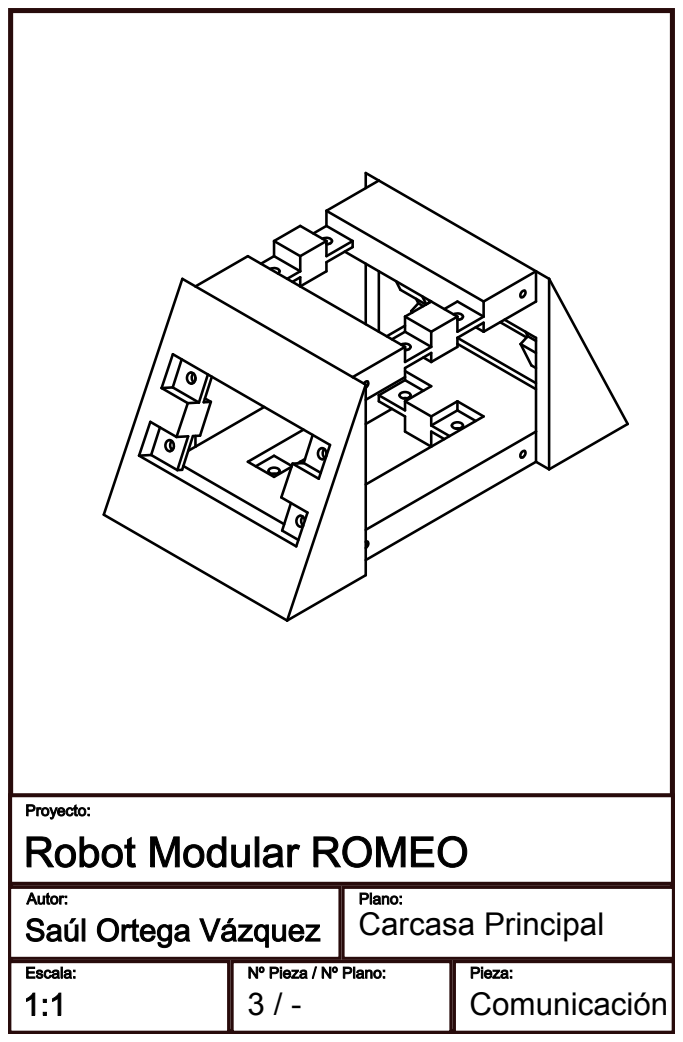
[picture p107: page 1]
Comunicación; Carcasa Principal
