SaulOrtegaVaz/ROMEO/Memoria/Planos/Comunicacion/Axonometrico_Soporte.pdf

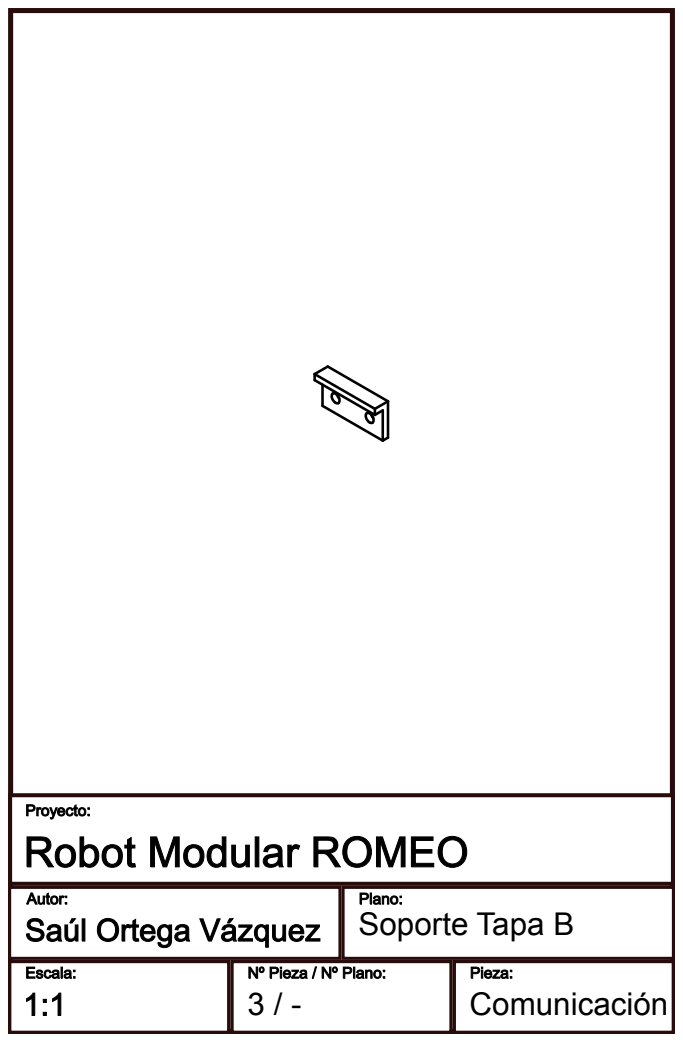
[picture p108: page 1]
Comunicación; Soporte Tapa B
