SaulOrtegaVaz/ROMEO/Memoria/Planos/Comunicacion/Axonometrico_TapaA.pdf

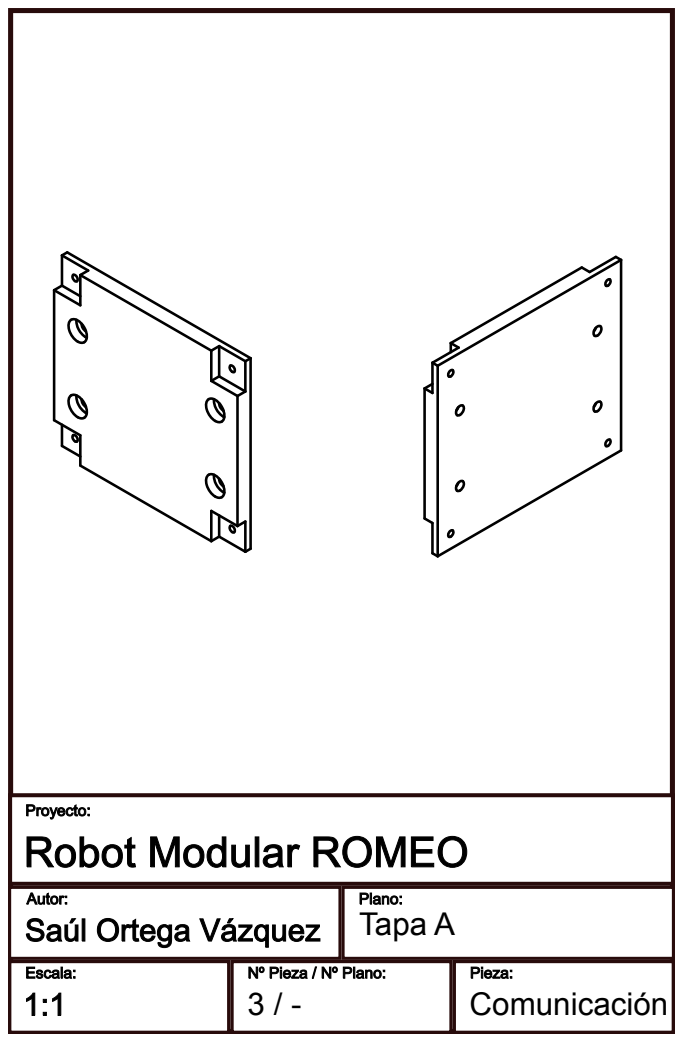
[picture p109: page 1]
Comunicación; Tapa A
