SaulOrtegaVaz/ROMEO/Memoria/Planos/Comunicacion/Axonometrico_TapaB.pdf

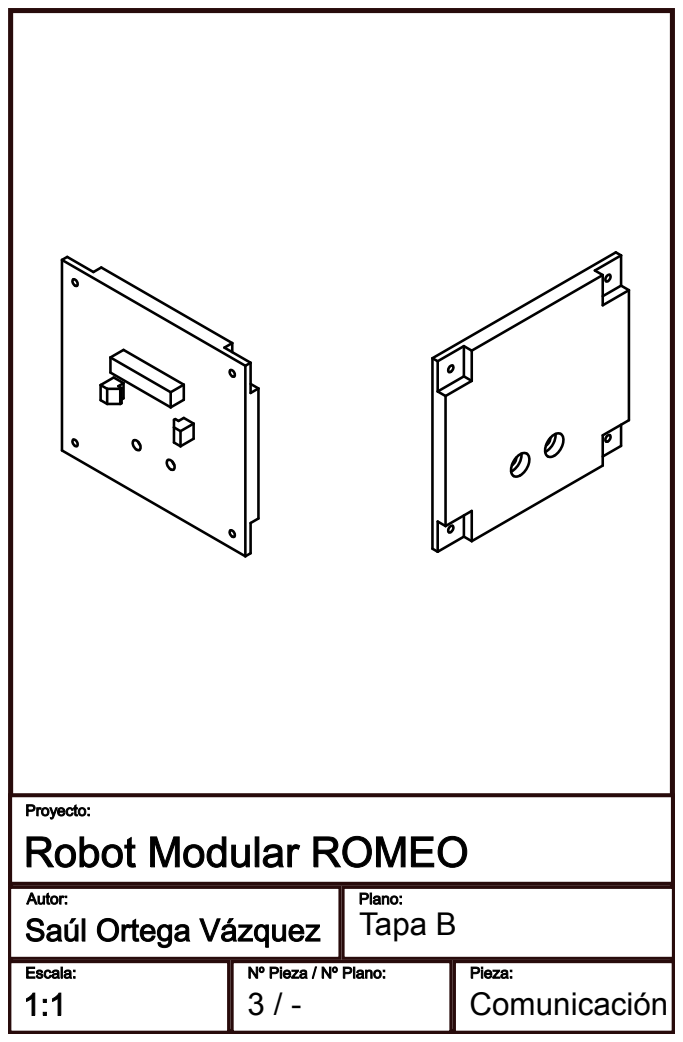
[picture p110: page 1]
Comunicación; Tapa B
