SaulOrtegaVaz/ROMEO/Memoria/Planos/Comunicacion/Comunicacion_Alzado.pdf

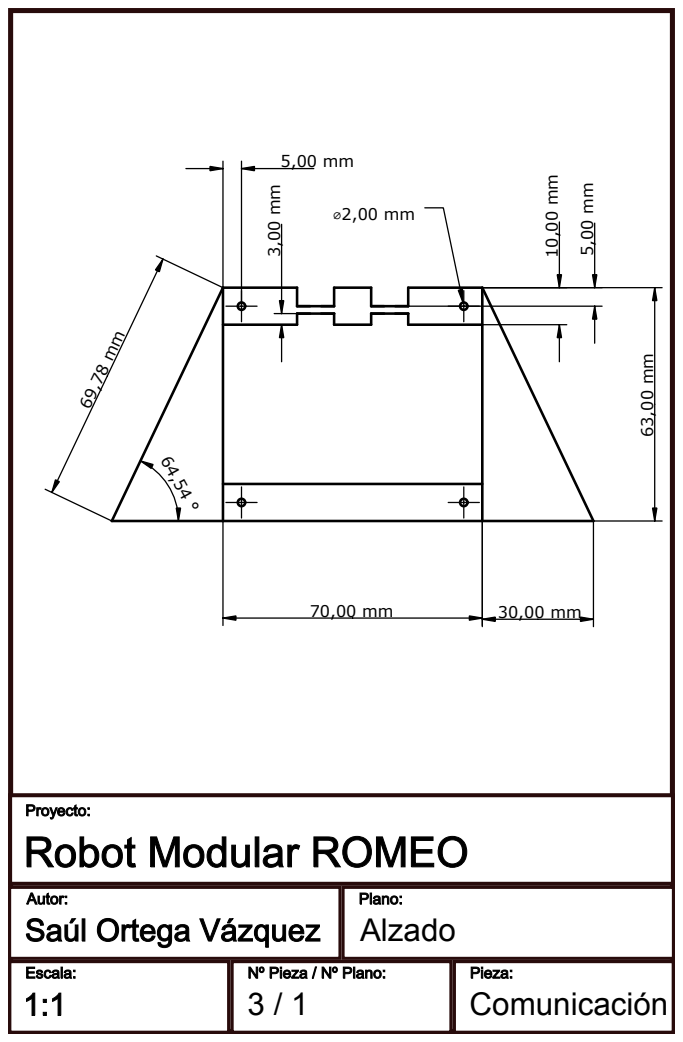
[picture p111: page 1]
Comunicación; Alzado
