SaulOrtegaVaz/ROMEO/Memoria/Planos/Comunicacion/Comunicacion_AlzadoTapaA.pdf

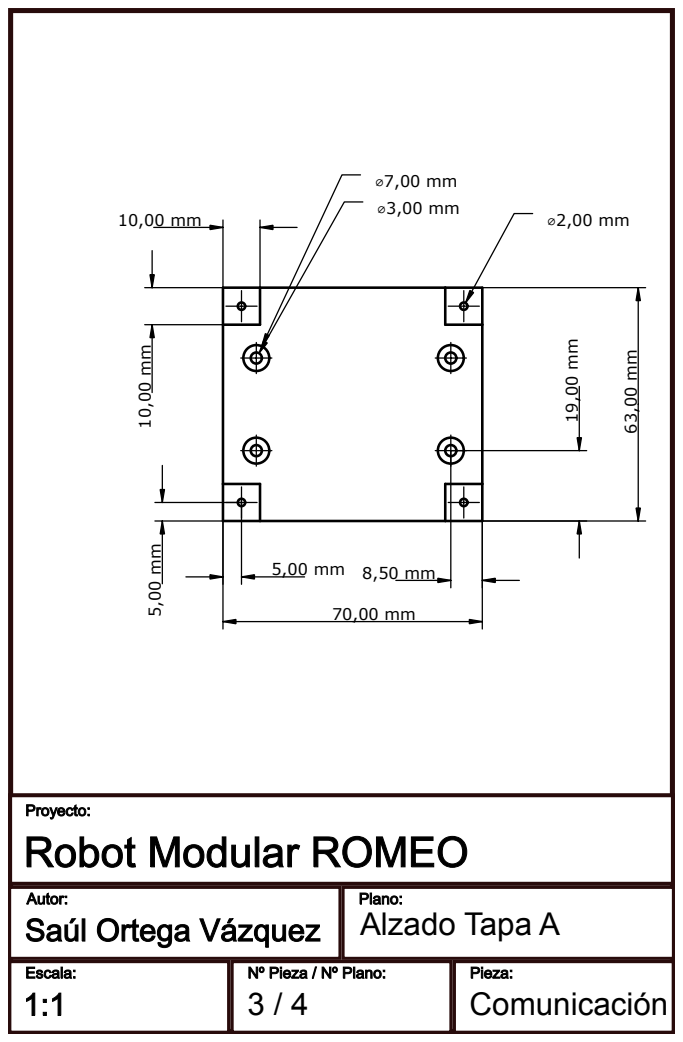
[picture p112: page 1]
Comunicación; Alzado Tapa A
