SaulOrtegaVaz/ROMEO/Memoria/Planos/Comunicacion/Comunicacion_AlzadoTapaB.pdf

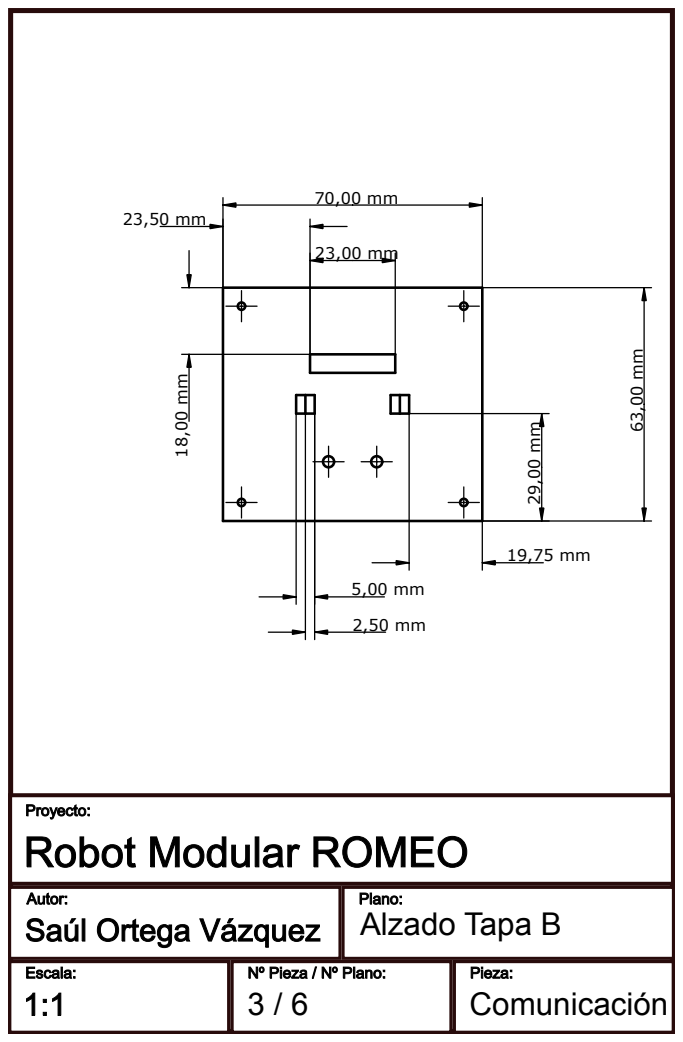
[picture p113: page 1]
Comunicación; Alzado Tapa B
