SaulOrtegaVaz/ROMEO/Memoria/Planos/Comunicacion/Comunicacion_PerfilIzqTapaA.pdf

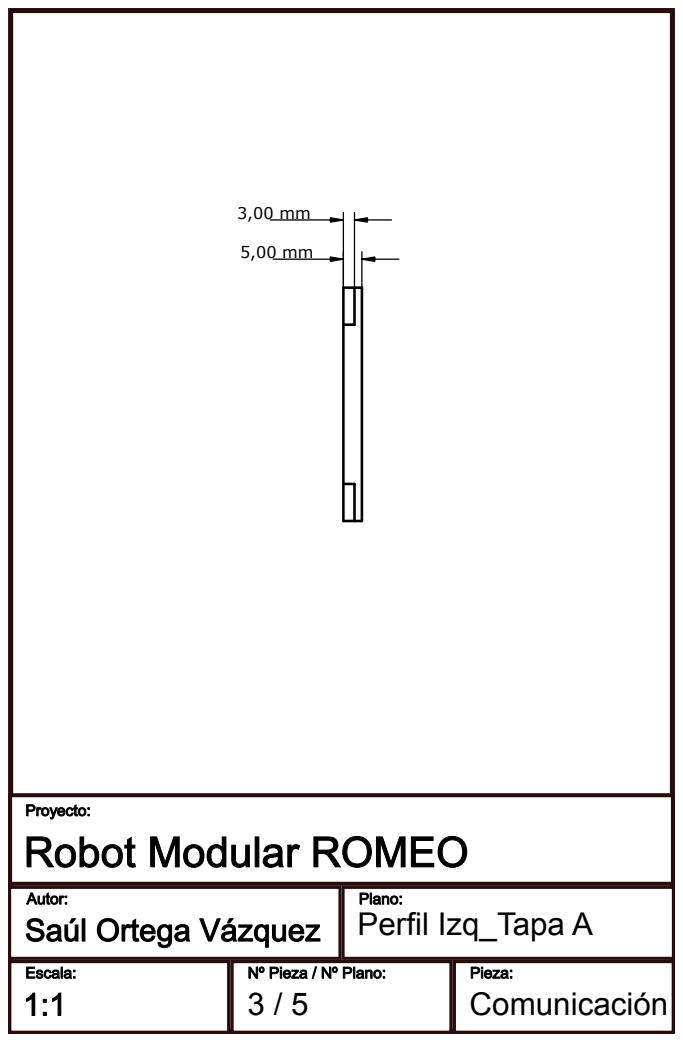
[picture p114: page 1]
Comunicación; Perfil Izq_Tapa A
