SaulOrtegaVaz/ROMEO/Memoria/Planos/Comunicacion/Comunicacion_PerfilIzqTapaB.pdf

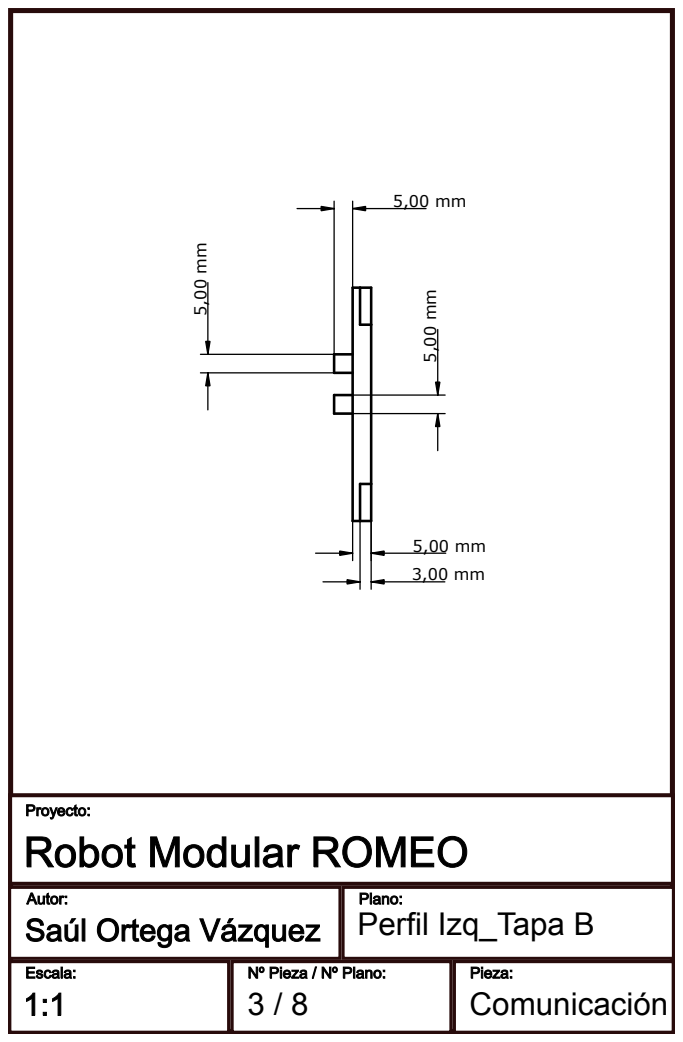
[picture p115: page 1]
Comunicación; Perfil Izq_Tapa B
