SaulOrtegaVaz/ROMEO/Memoria/Planos/Comunicacion/Comunicacion_Planta.pdf

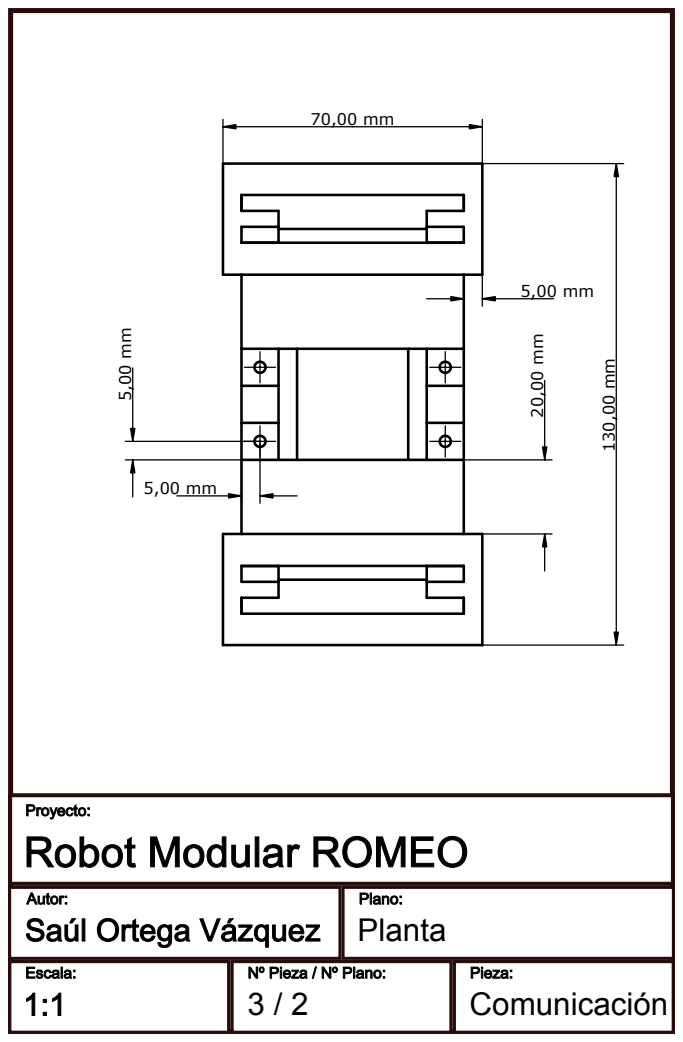
[picture p116: page 1]
Comunicación; Planta
