SaulOrtegaVaz/ROMEO/Memoria/Planos/Comunicacion/Comunicacion_PlantaPost.pdf

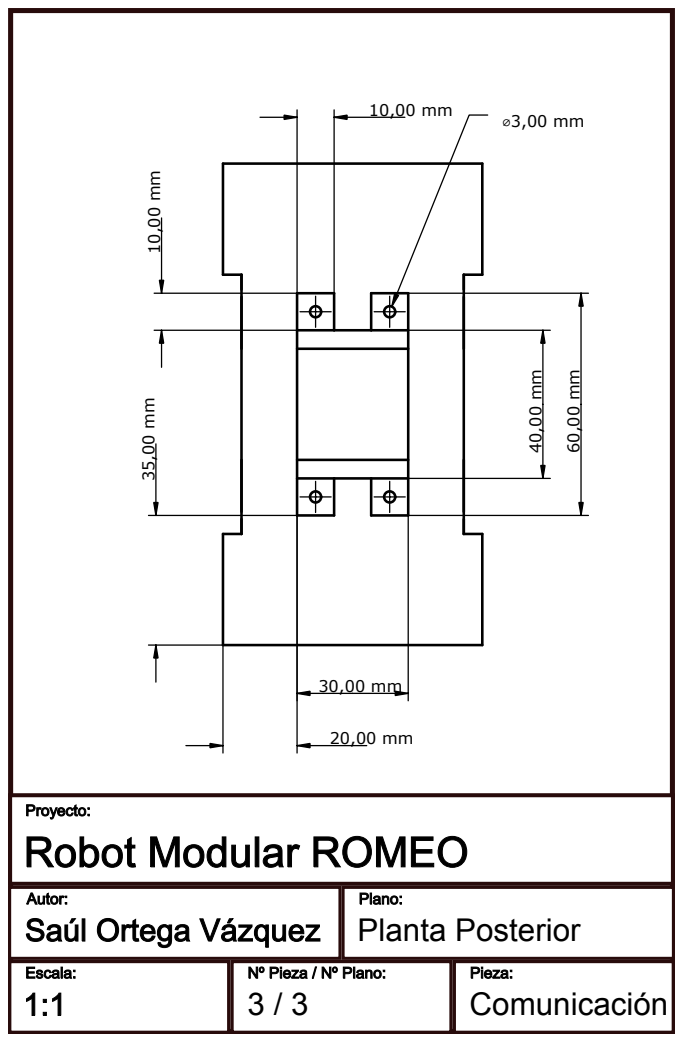
[picture p117: page 1]
Comunicación; Planta Posterior
