SaulOrtegaVaz/ROMEO/Memoria/Planos/Comunicacion/Comunicacion_Soporte.pdf

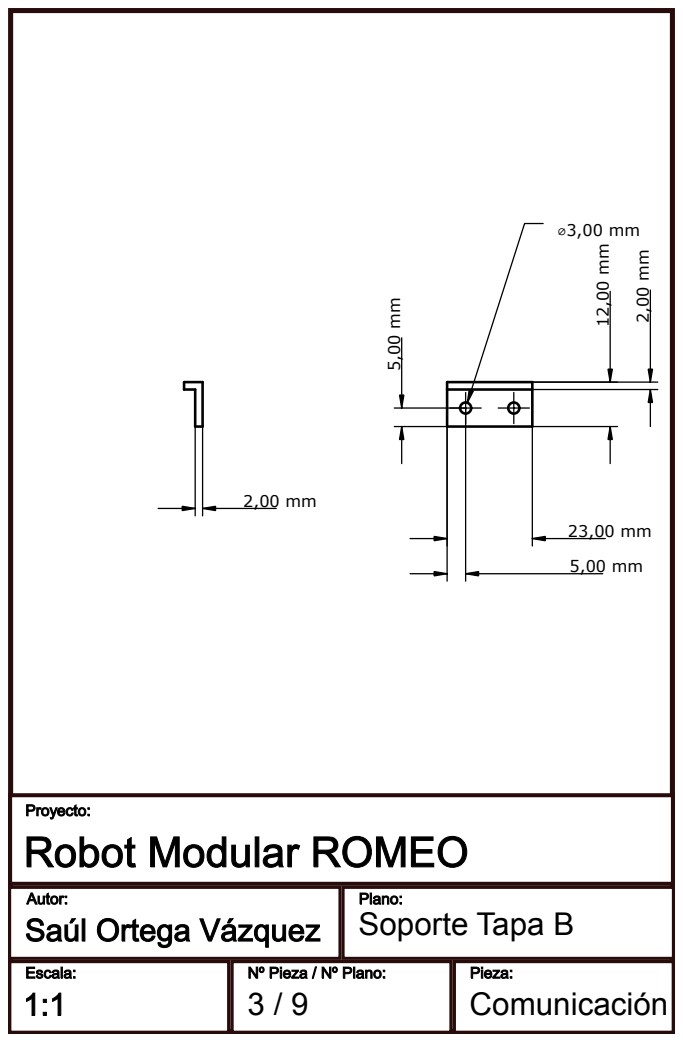
[picture p118: page 1]
Comunicación; Soporte Tapa B
