SaulOrtegaVaz/ROMEO/Memoria/Planos/ConectorH/H_Alzado_inf.pdf

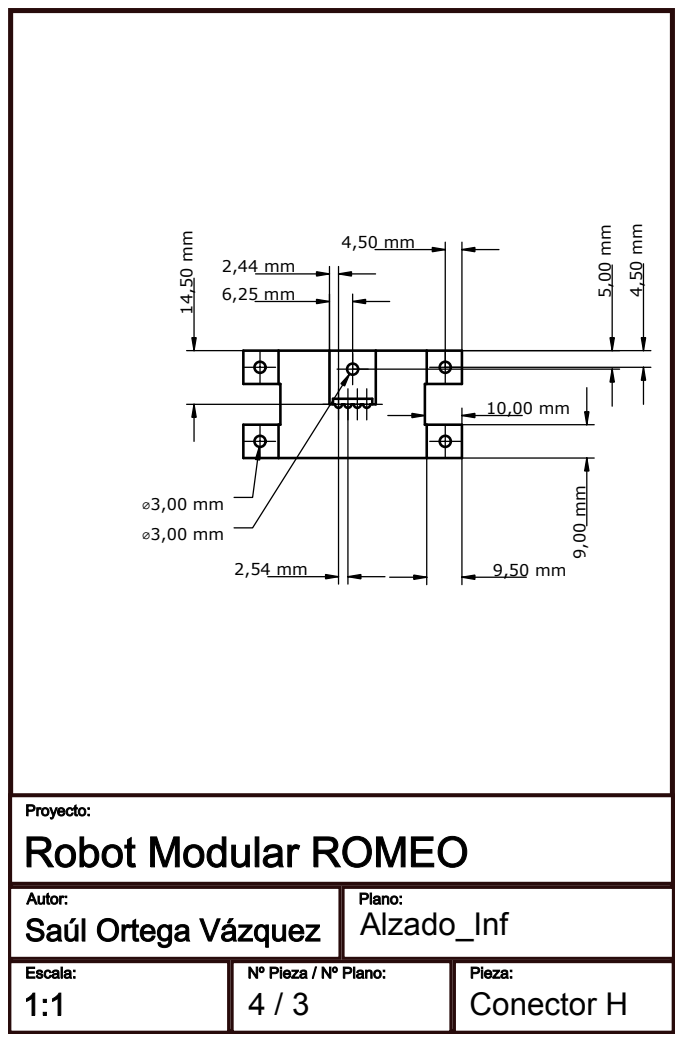
[picture p119: page 1]
Alzado_Inf; Conector H
