SaulOrtegaVaz/ROMEO/Memoria/Planos/ConectorH/H_Alzado_sup.pdf

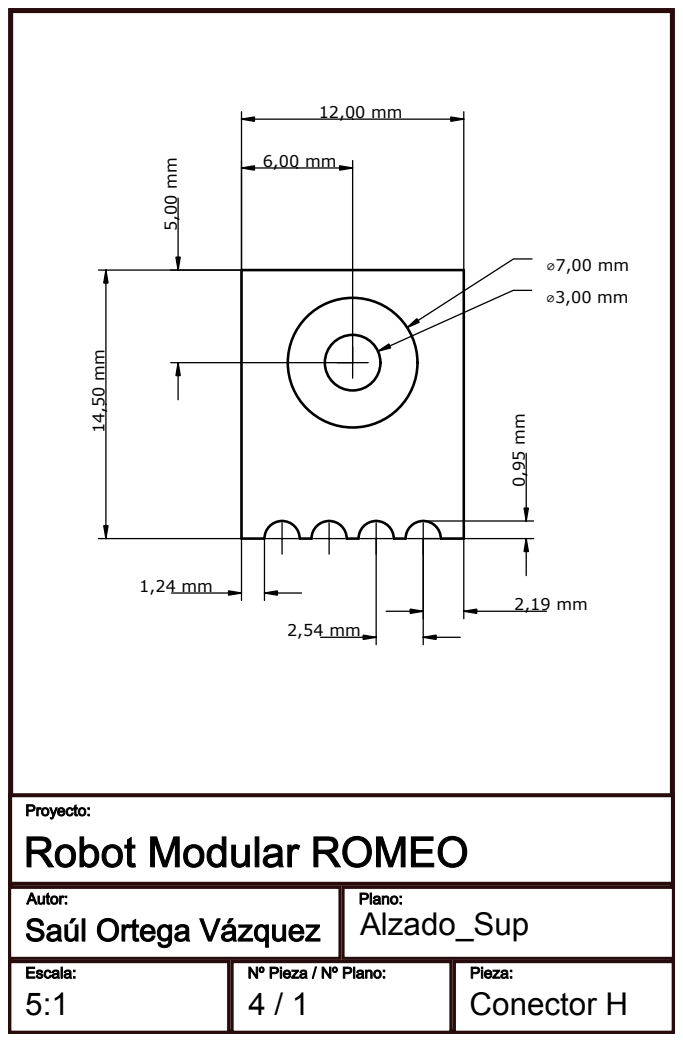
[picture p120: page 1]
Conector H; Alzado_Sup
