SaulOrtegaVaz/ROMEO/Memoria/Planos/ConectorH/H_AlzadoPost_inf.pdf

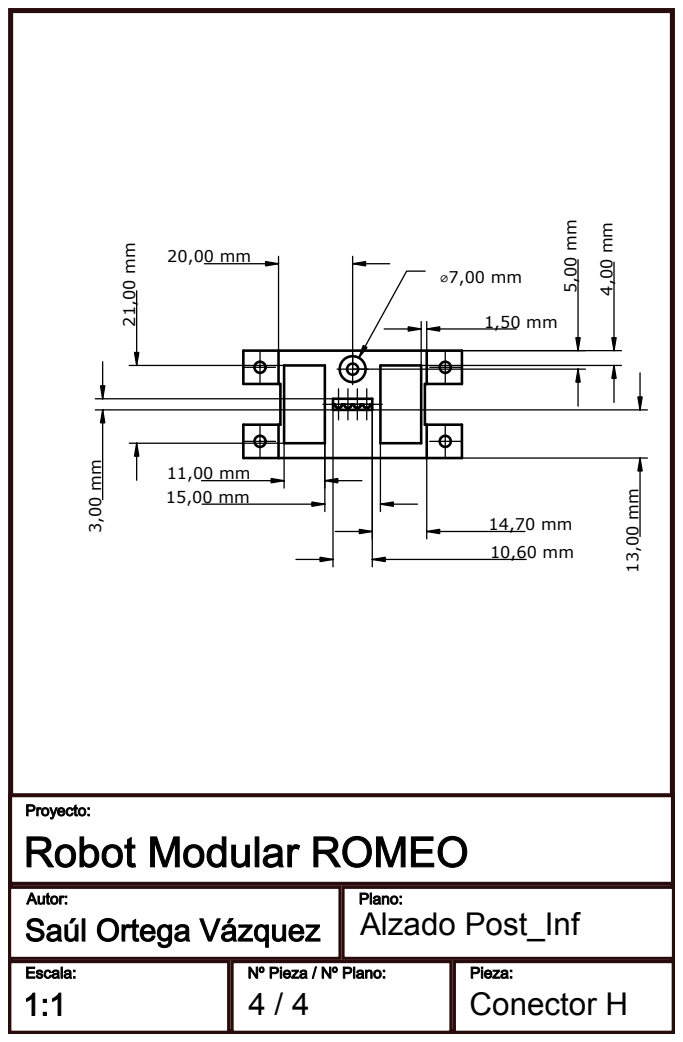
[picture p121: page 1]
Alzado Post_Inf; Conector H
