SaulOrtegaVaz/ROMEO/Memoria/Planos/ConectorH/H_Axonometrico_inf.pdf

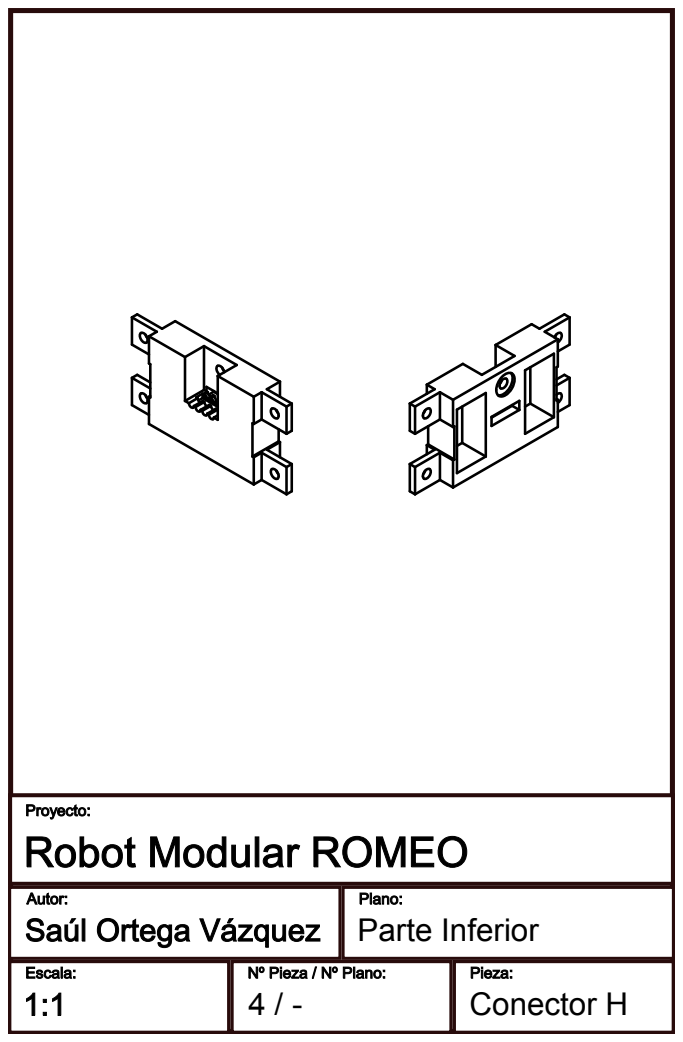
[picture p122: page 1]
Parte Inferior; Conector H
