SaulOrtegaVaz/ROMEO/Memoria/Planos/ConectorH/H_Axonometrico_sup.pdf

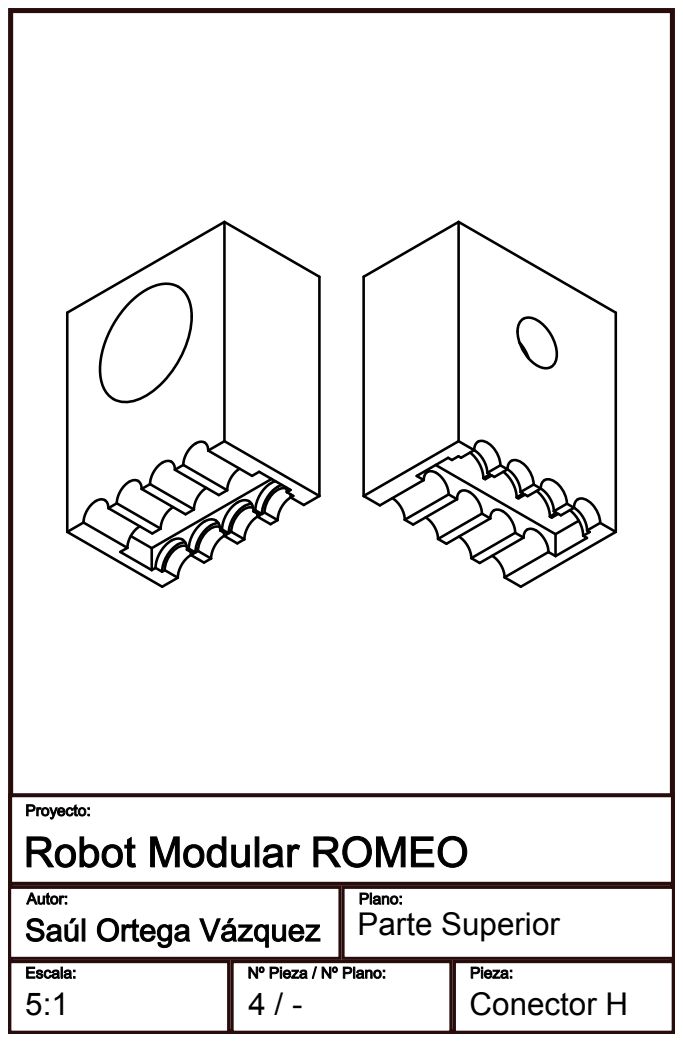
[picture p123: page 1]
Conector H; Parte Superior
