SaulOrtegaVaz/ROMEO/Memoria/Planos/ConectorH/H_PerfilIzq_inf.pdf

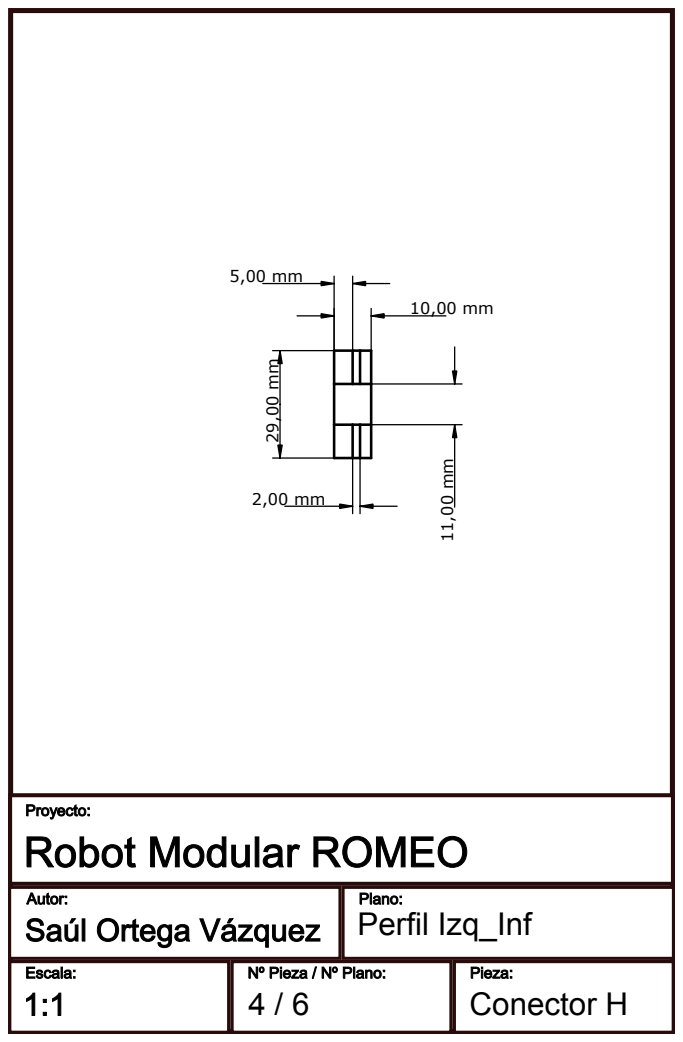
[picture p124: page 1]
Conector H; Perfil Izq_Inf
