SaulOrtegaVaz/ROMEO/Memoria/Planos/ConectorH/H_Planta_inf.pdf

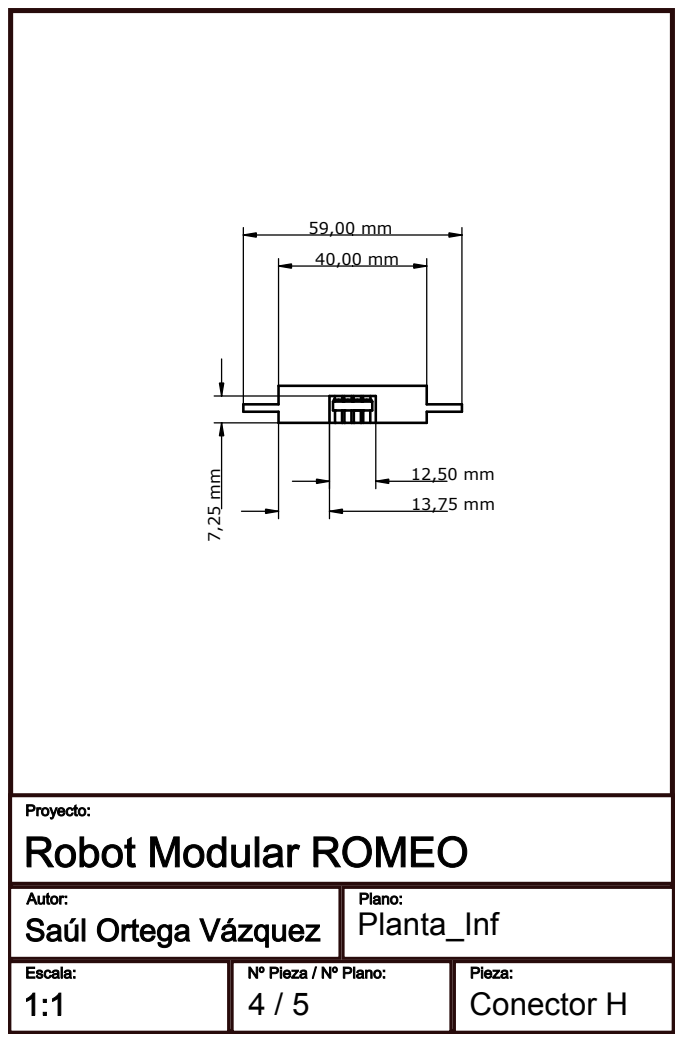
[picture p125: page 1]
Conector H; Planta_Inf
