SaulOrtegaVaz/ROMEO/Memoria/Planos/ConectorH/H_PlantaPost_sup.pdf

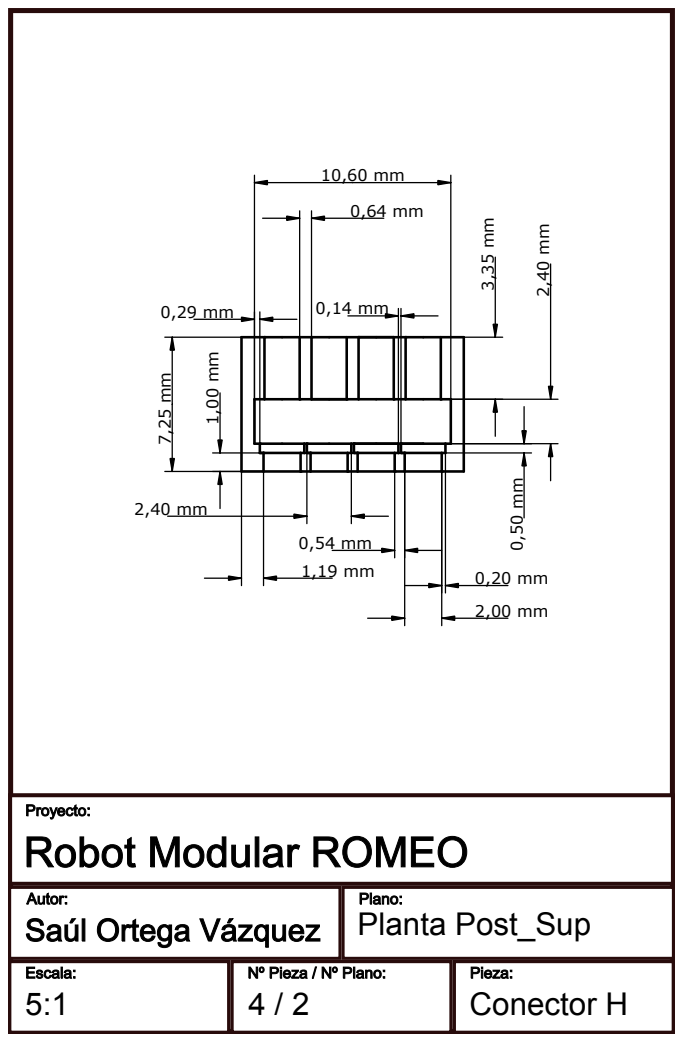
[picture p126: page 1]
Planta Post_Sup; Conector H
