SaulOrtegaVaz/ROMEO/Memoria/Planos/ConectorM/M_Alzado_inf.pdf

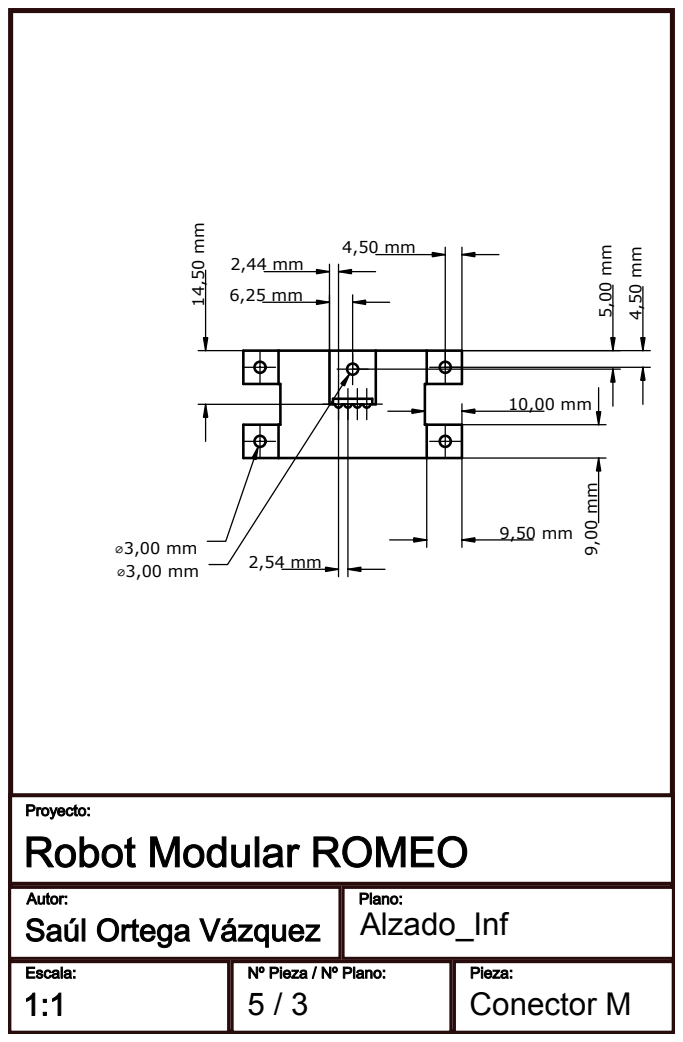
[picture p127: page 1]
Conector M; Alzado_Inf
