SaulOrtegaVaz/ROMEO/Memoria/Planos/ConectorM/M_Alzado_sup.pdf

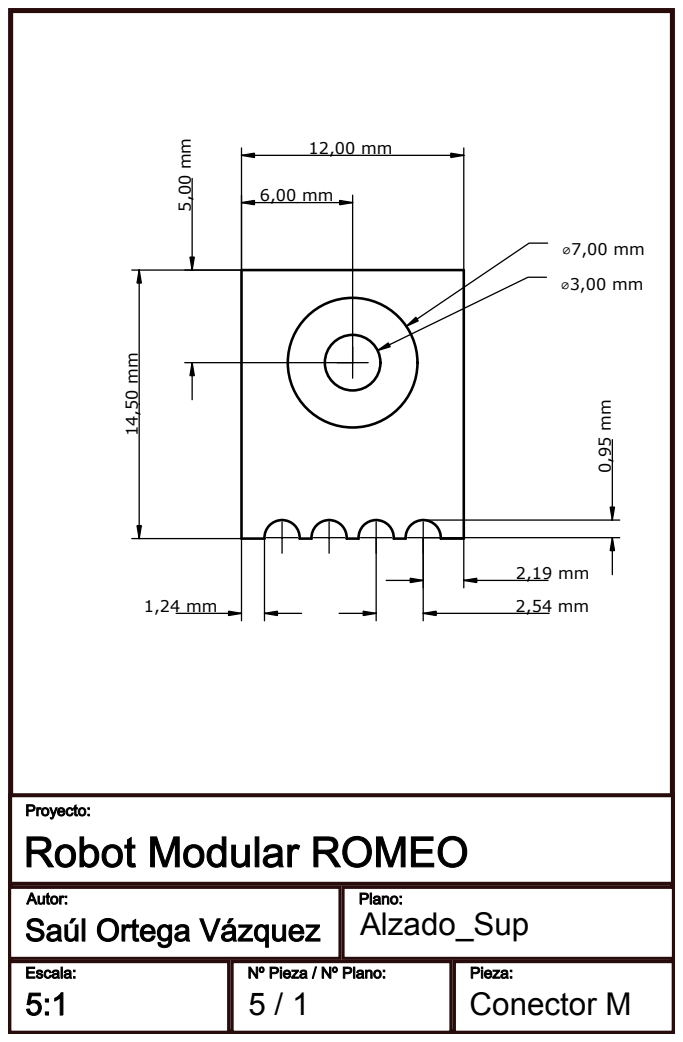
[picture p128: page 1]
Conector M; Alzado_Sup
