SaulOrtegaVaz/ROMEO/Memoria/Planos/ConectorM/M_AlzadoPost_inf.pdf

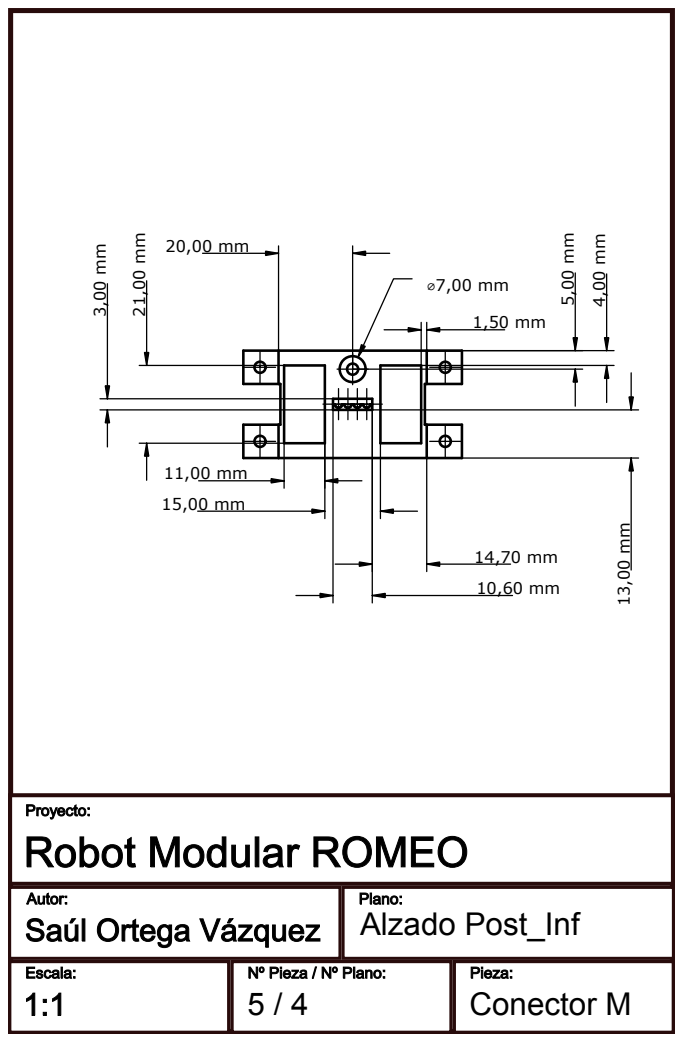
[picture p129: page 1]
Conector M; Alzado Post_Inf
