SaulOrtegaVaz/ROMEO/Memoria/Planos/ConectorM/M_Axonometrico_inf.pdf

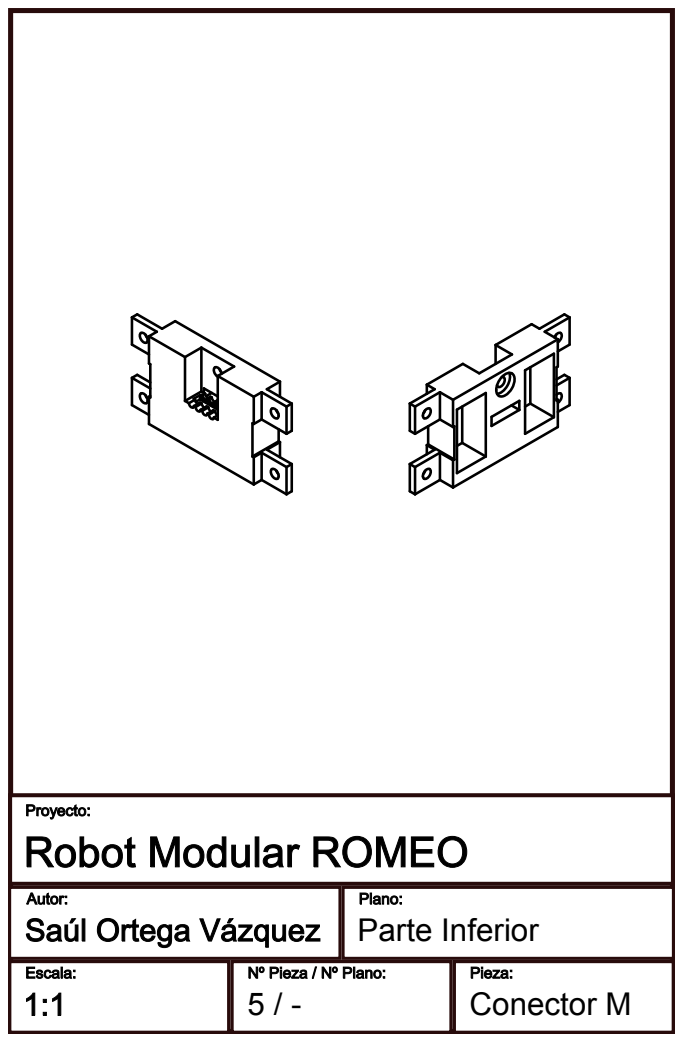
[picture p130: page 1]
Conector M; Parte Inferior
