SaulOrtegaVaz/ROMEO/Memoria/Planos/ConectorM/M_Axonometrico_sup.pdf

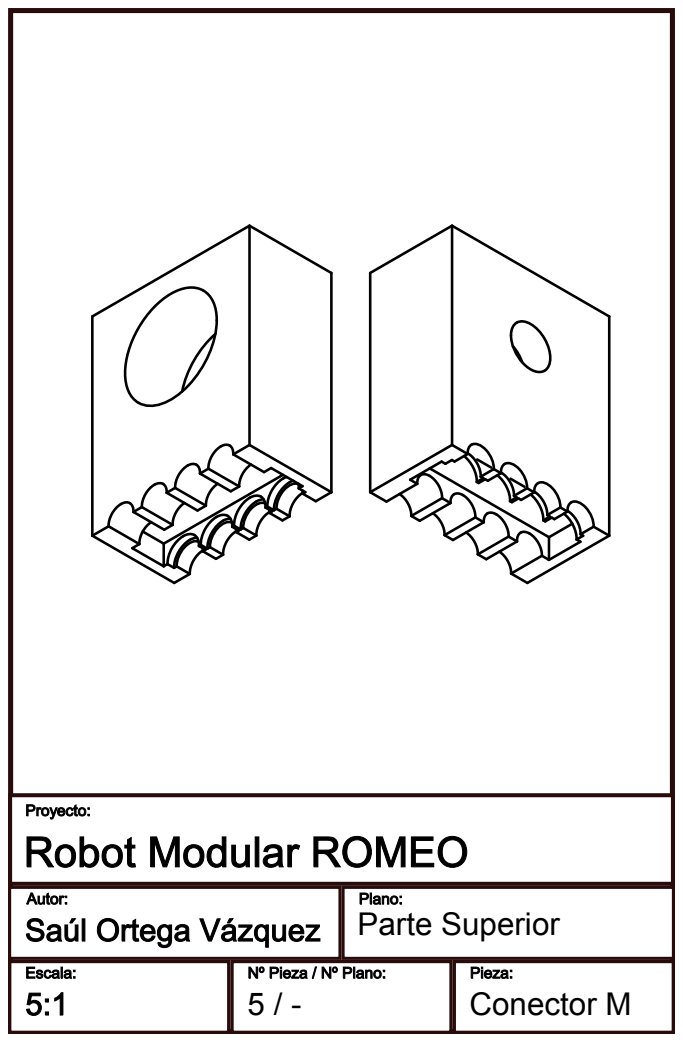
[picture p131: page 1]
Conector M; Parte Superior
