SaulOrtegaVaz/ROMEO/Memoria/Planos/ConectorM/M_Planta_inf.pdf

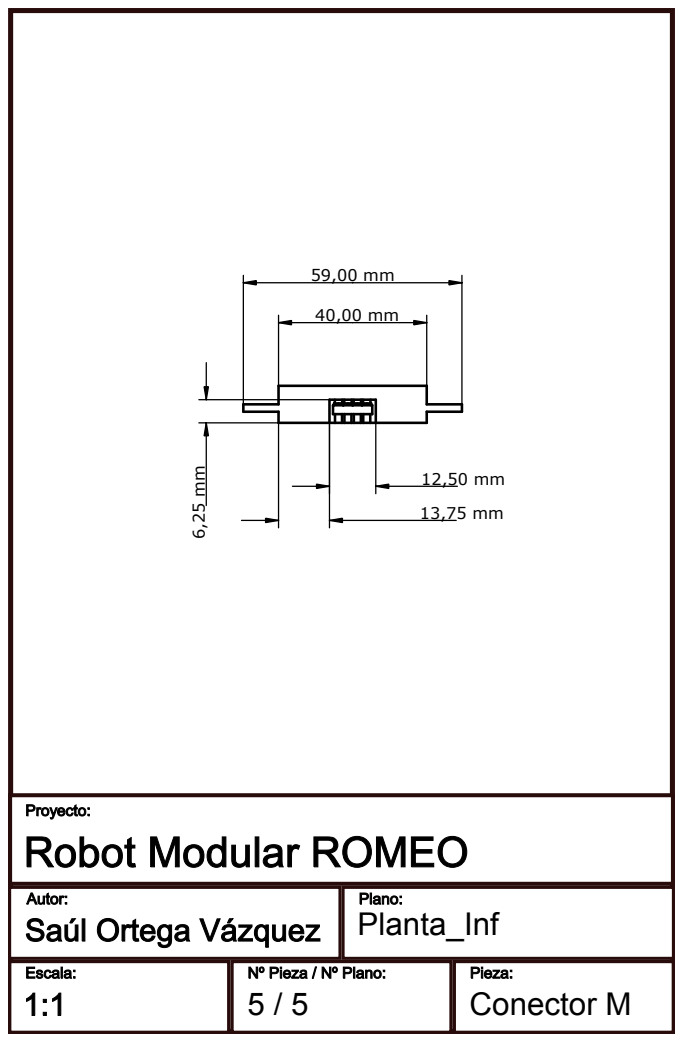
[picture p132: page 1]
Conector M; Planta_Inf
