SaulOrtegaVaz/ROMEO/Memoria/Planos/ConectorM/M_PlantaPost_sup.pdf

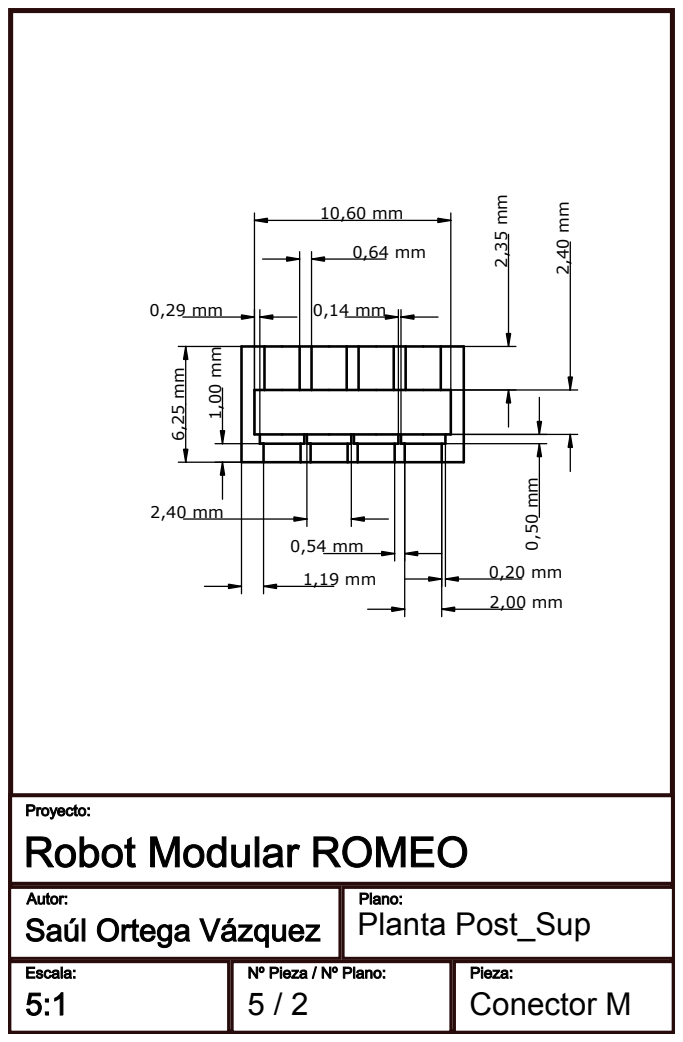
[picture p133: page 1]
Conector M; Planta Post_Sup
