SaulOrtegaVaz/ROMEO/Memoria/Planos/Control/Axonometrico_Carcasa.pdf

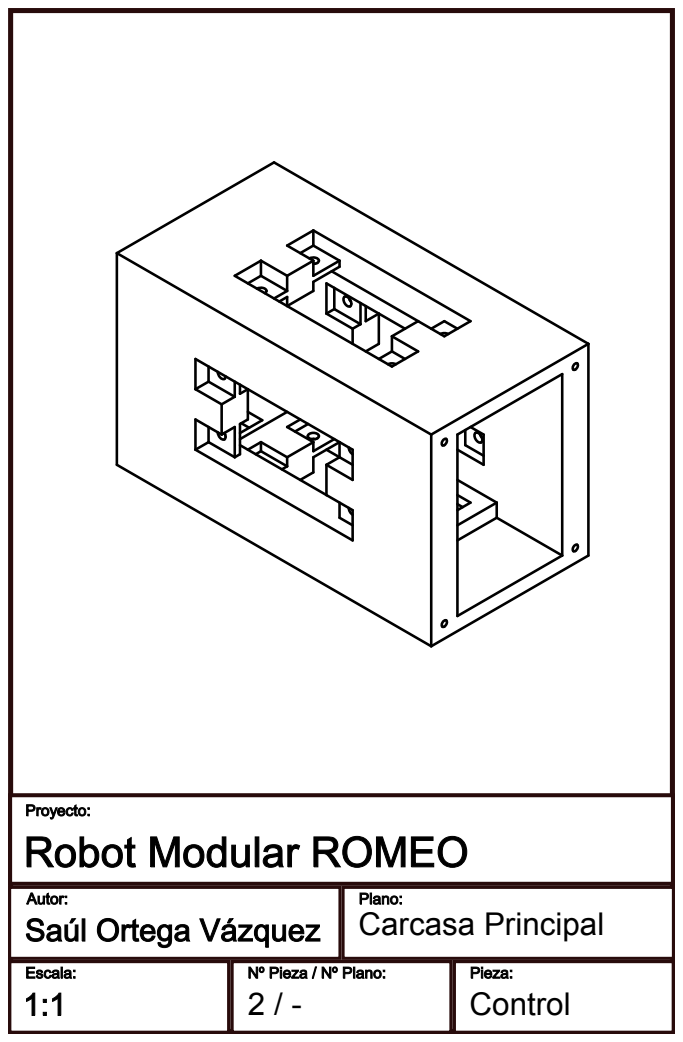
[picture p134: page 1]
Control; Carcasa Principal
