SaulOrtegaVaz/ROMEO/Memoria/Planos/Control/Axonometrico_Soporte.pdf

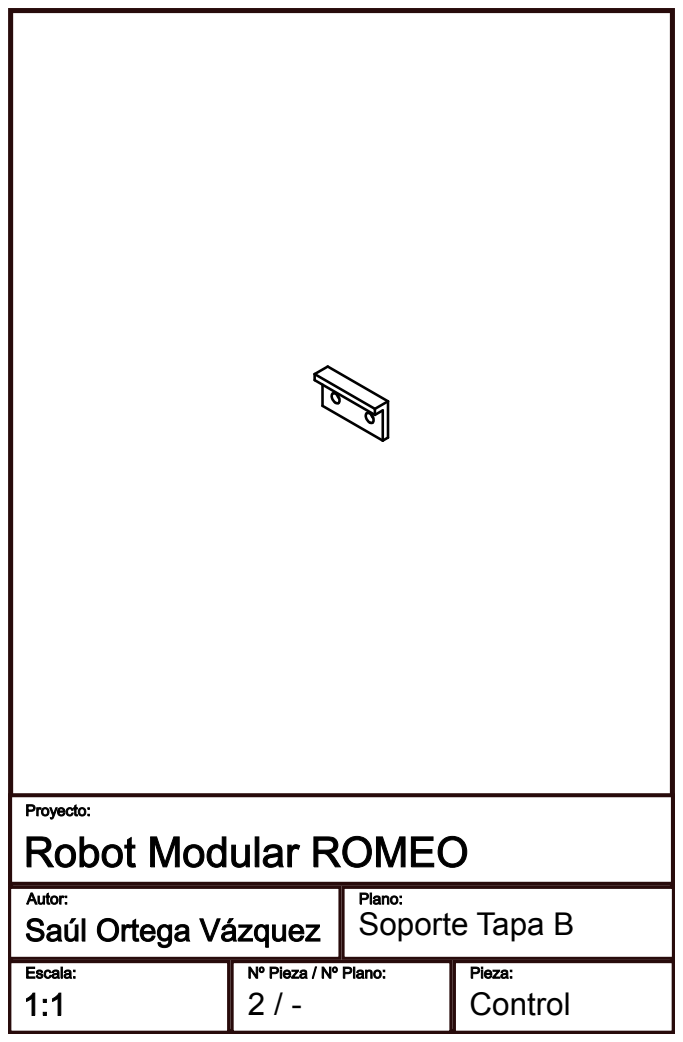
[picture p135: page 1]
Control; Soporte Tapa B
