SaulOrtegaVaz/ROMEO/Memoria/Planos/Control/Axonometrico_TapaA.pdf

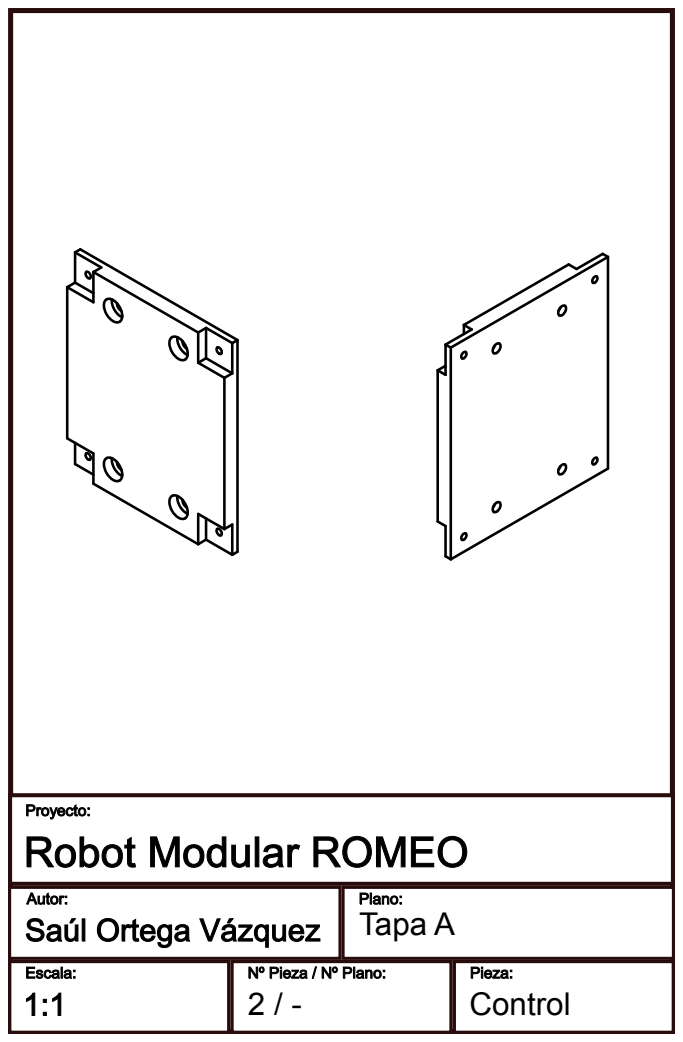
[picture p136: page 1]
Control; Tapa A
