SaulOrtegaVaz/ROMEO/Memoria/Planos/Control/Axonometrico_TapaB.pdf

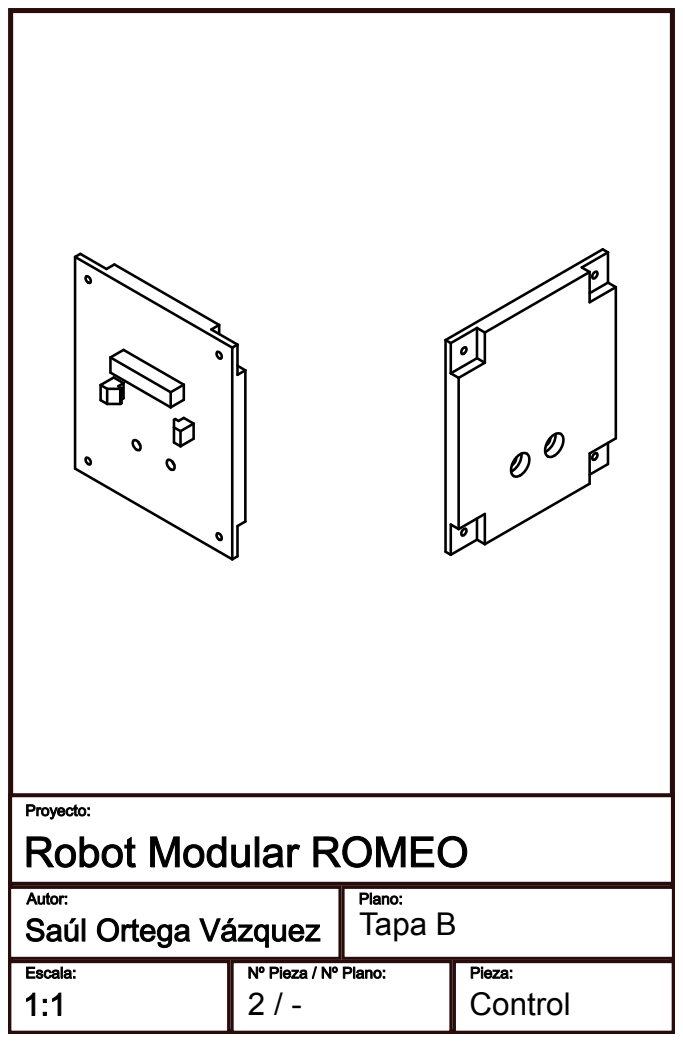
[picture p137: page 1]
Control; Tapa B
