SaulOrtegaVaz/ROMEO/Memoria/Planos/Control/Control_Alzado.pdf

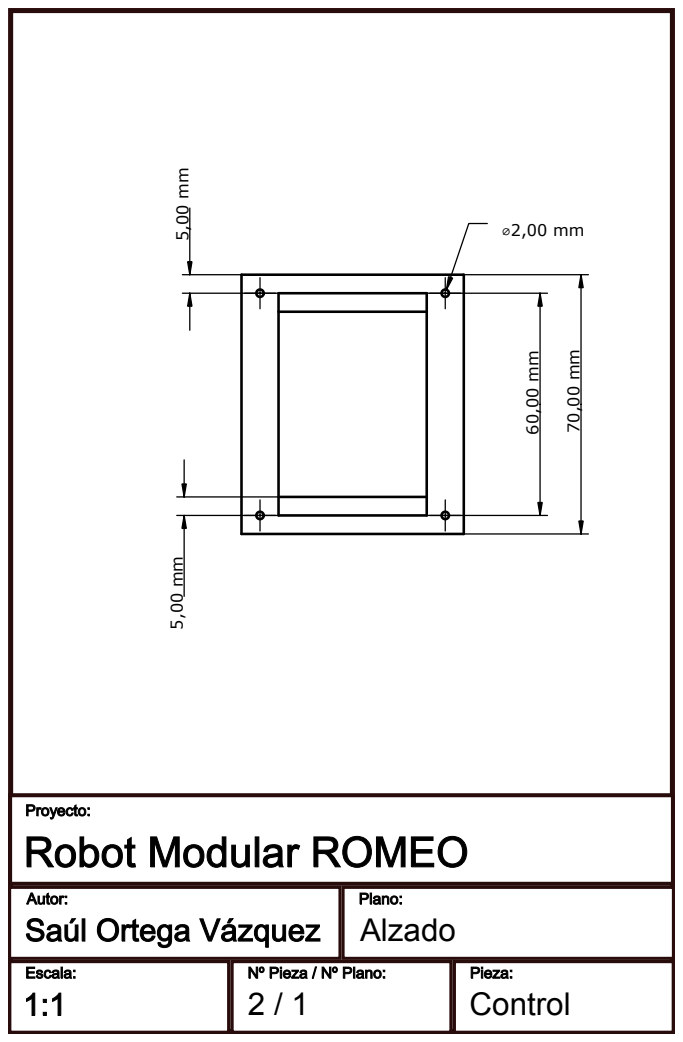
[picture p138: page 1]
Control; Alzado
