SaulOrtegaVaz/ROMEO/Memoria/Planos/Control/Control_AlzadoTapaB.pdf

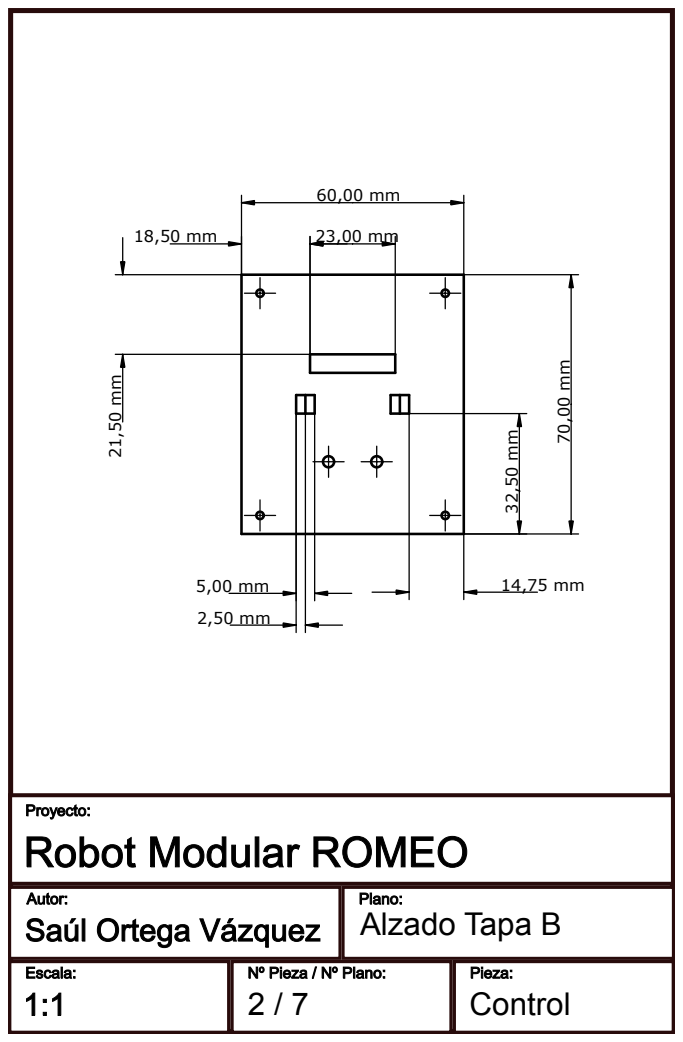
[picture p139: page 1]
Control; Alzado Tapa B
