SaulOrtegaVaz/ROMEO/Memoria/Planos/Control/Control_AlzadoTapaBPost.pdf

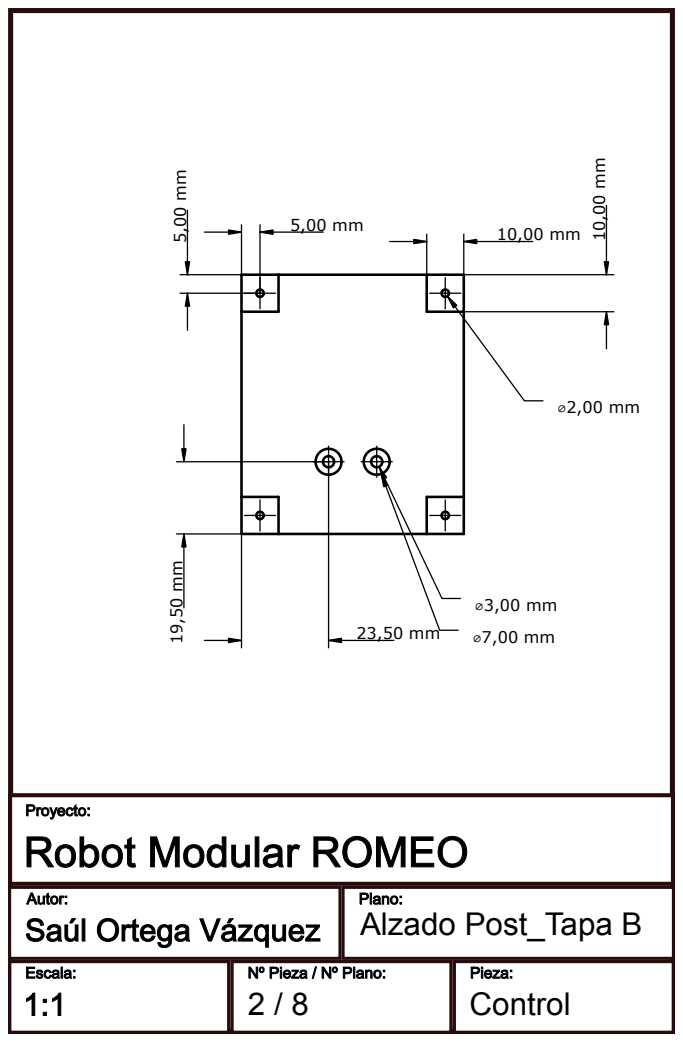
[picture p140: page 1]
Control; Alzado Post_Tapa B
