SaulOrtegaVaz/ROMEO/Memoria/Planos/Control/Control_PerfilIzq.pdf

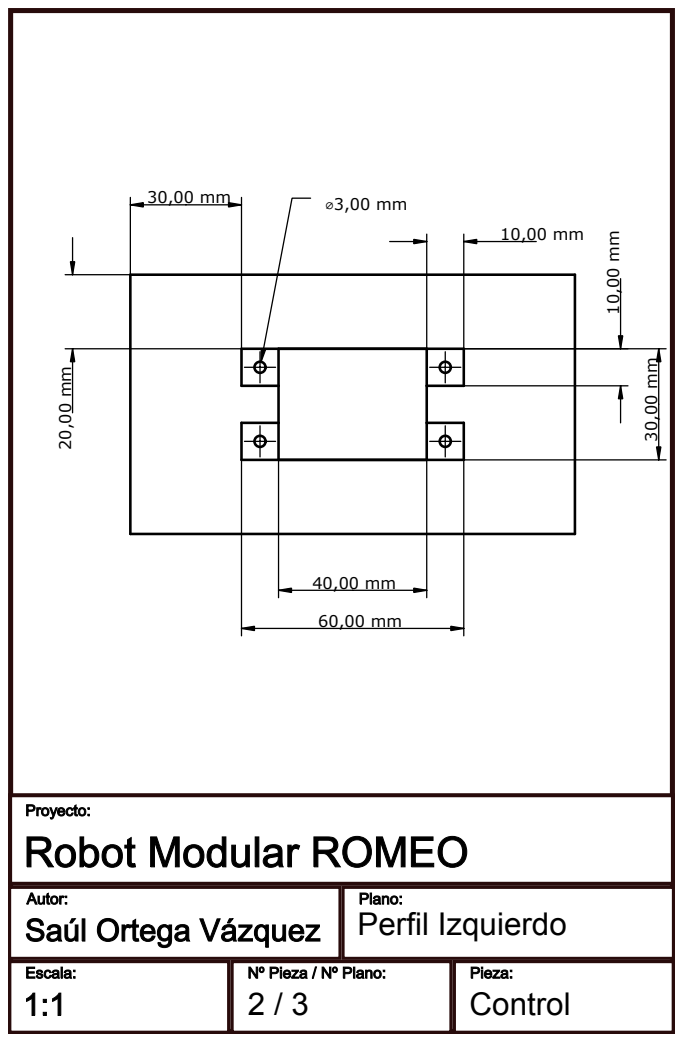
[picture p141: page 1]
Control; Perfil Izquierdo
