SaulOrtegaVaz/ROMEO/Memoria/Planos/Control/Control_PerfilIzqTapaA.pdf

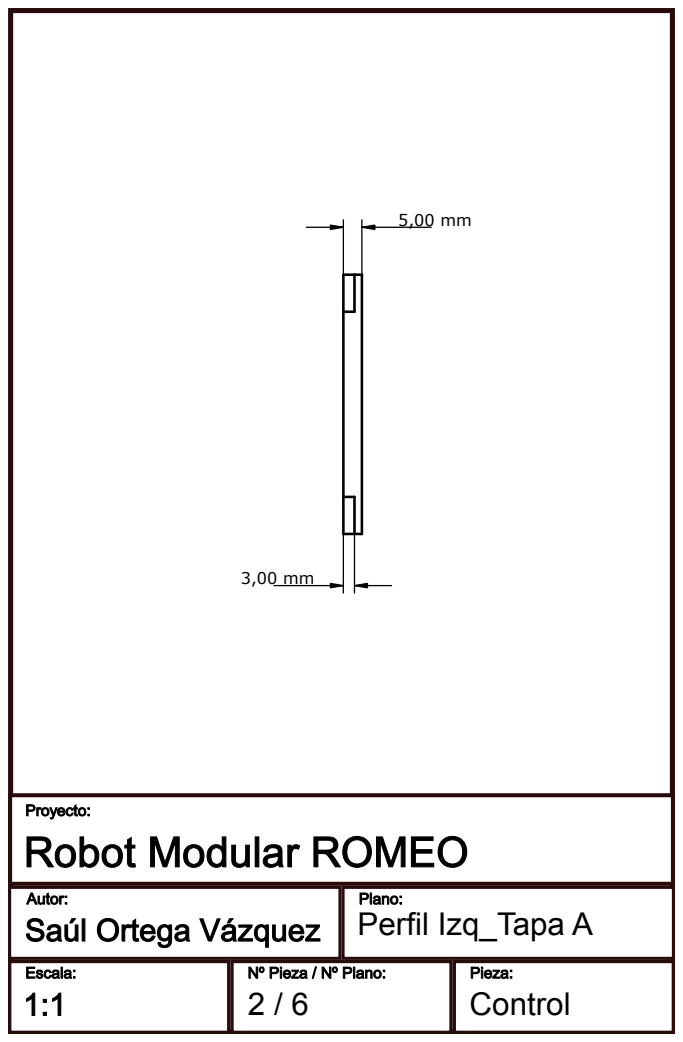
[picture p142: page 1]
Control; Perfil Izq_Tapa A
