SaulOrtegaVaz/ROMEO/Memoria/Planos/Control/Control_PerfilIzqTapaB.pdf

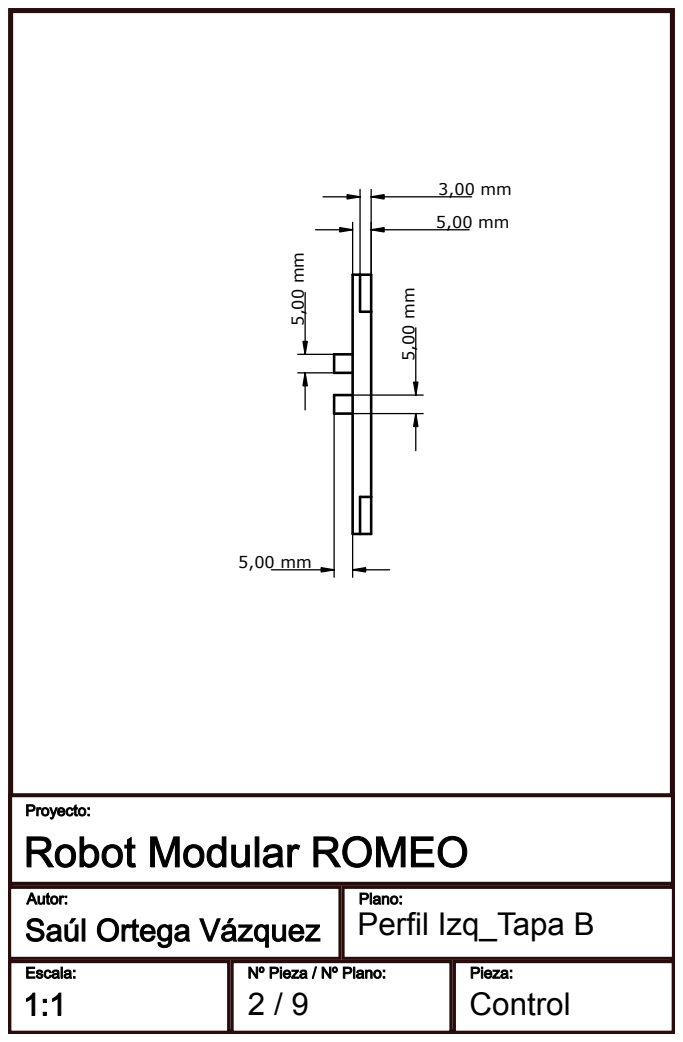
[picture p143: page 1]
Control; Perfil Izq_Tapa B
