SaulOrtegaVaz/ROMEO/Memoria/Planos/Control/Control_Planta.pdf

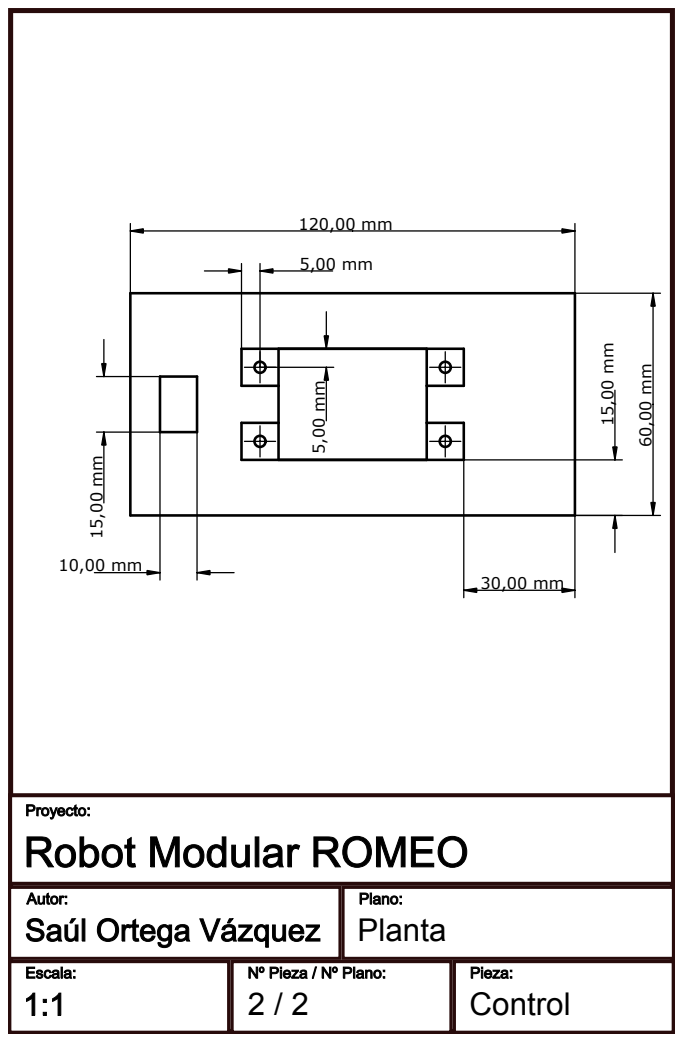
[picture p144: page 1]
Control; Planta
