SaulOrtegaVaz/ROMEO/Memoria/Planos/Control/Control_SeccionXY.pdf

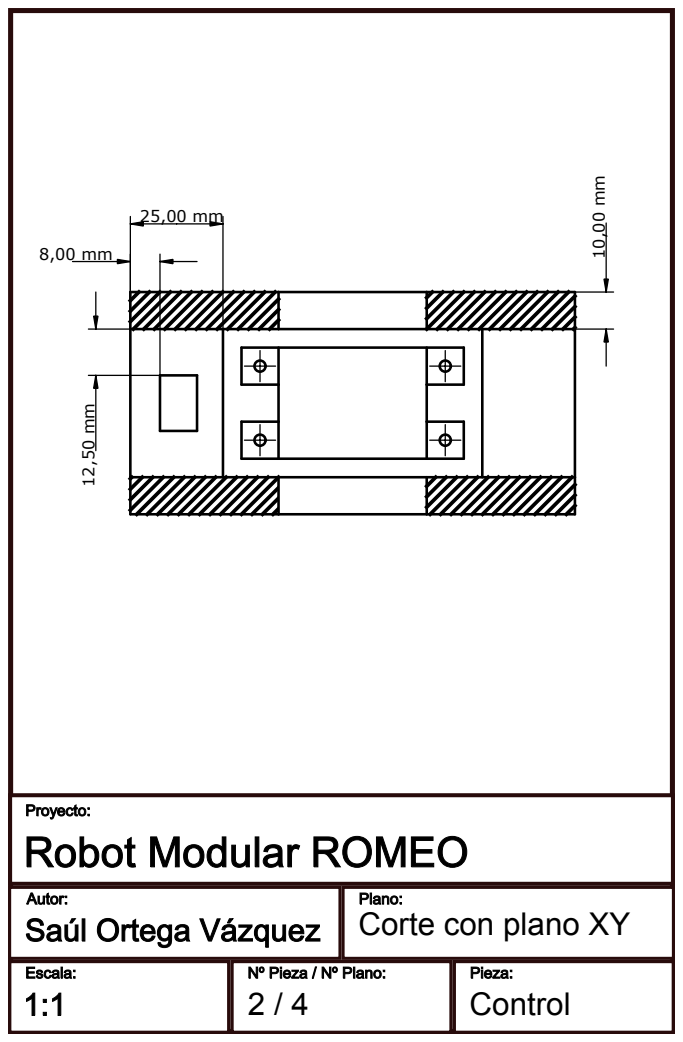
[picture p145: page 1]
Control

Corte con plano XY
