SaulOrtegaVaz/ROMEO/Memoria/Planos/Control/Control_Soporte.pdf

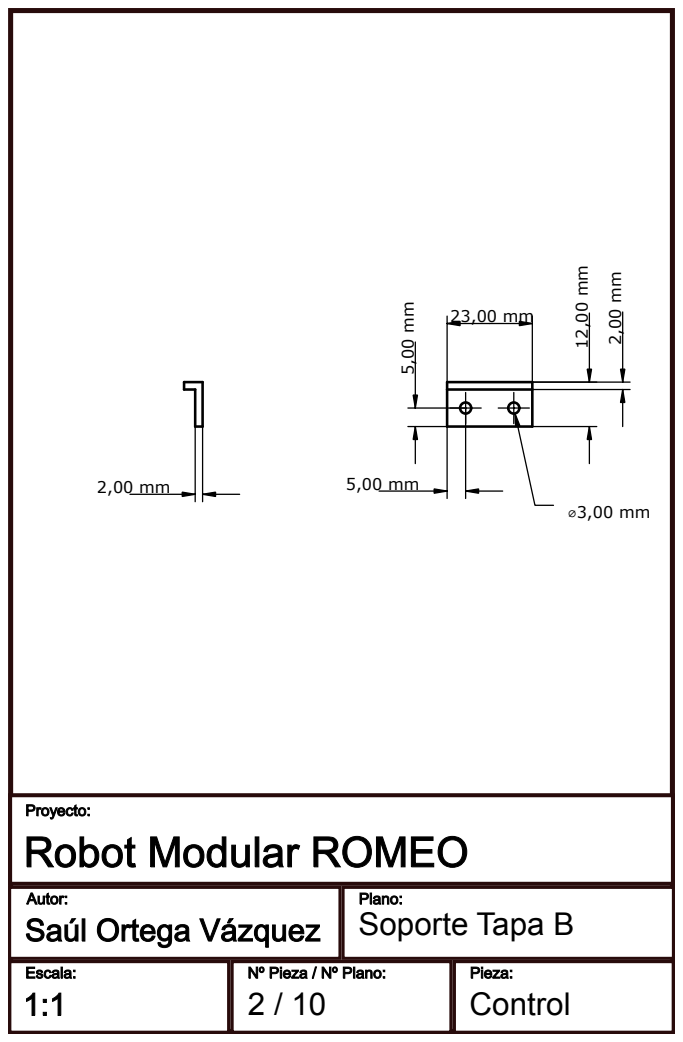
[picture p146: page 1]
Control; Soporte Tapa B
