SaulOrtegaVaz/ROMEO/Memoria/Planos/Locomocion/Axonometrico_Carcasa.pdf

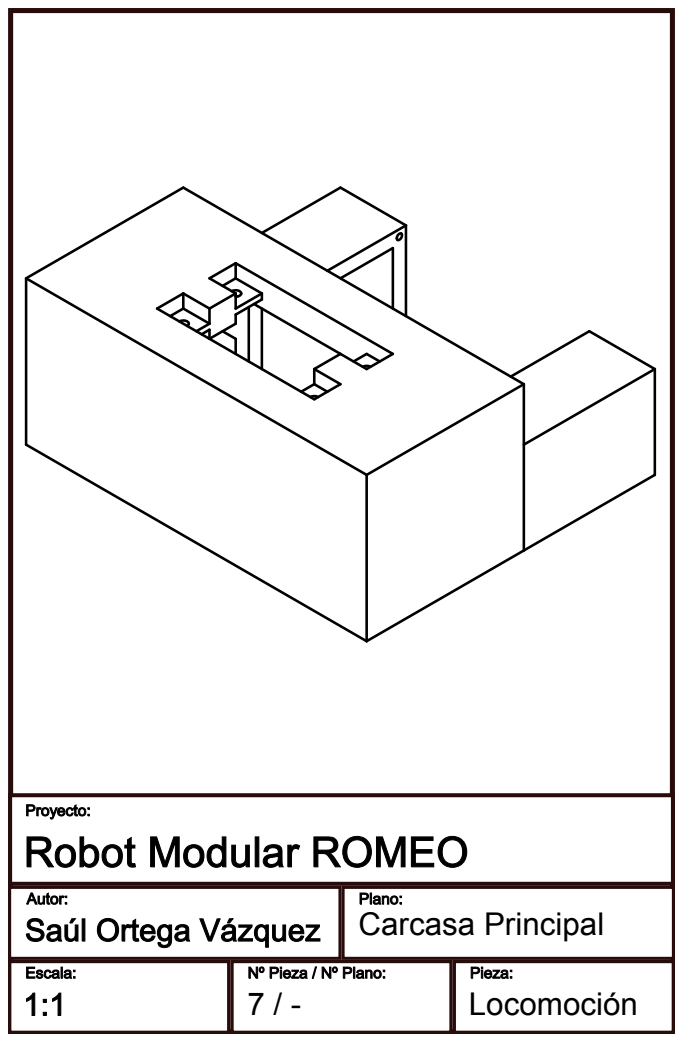
[picture p147: page 1]
Carcasa Principal; Locomoción
