SaulOrtegaVaz/ROMEO/Memoria/Planos/Locomocion/Axonometrico_Soporte.pdf

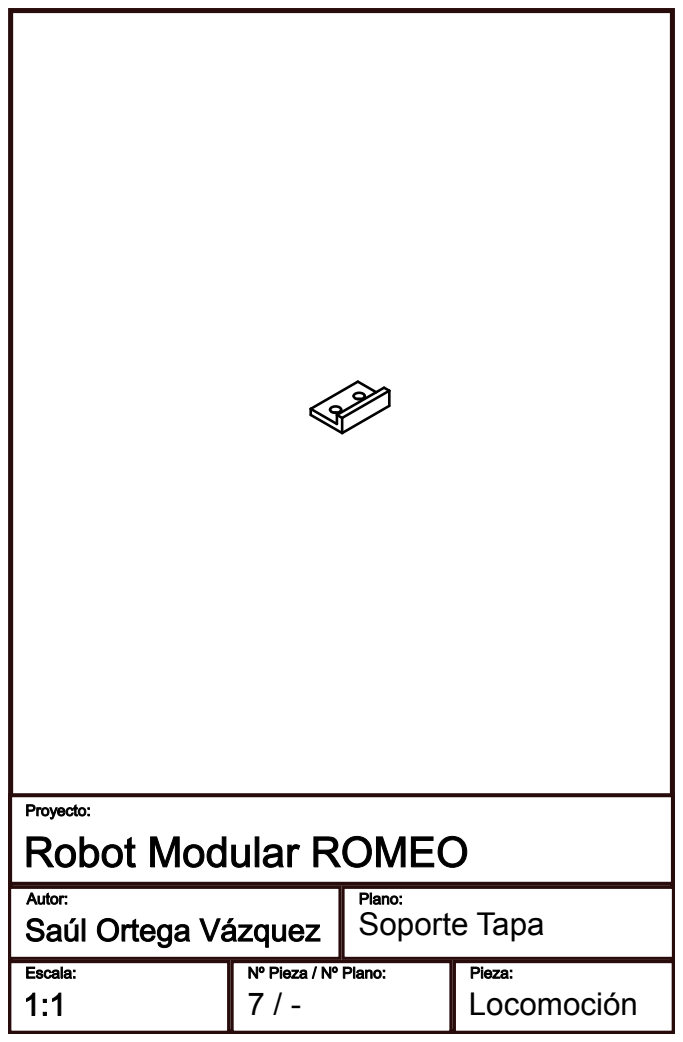
[picture p148: page 1]
Locomoción; Soporte Tapa
