SaulOrtegaVaz/ROMEO/Memoria/Planos/Locomocion/Axonometrico_Tapa.pdf

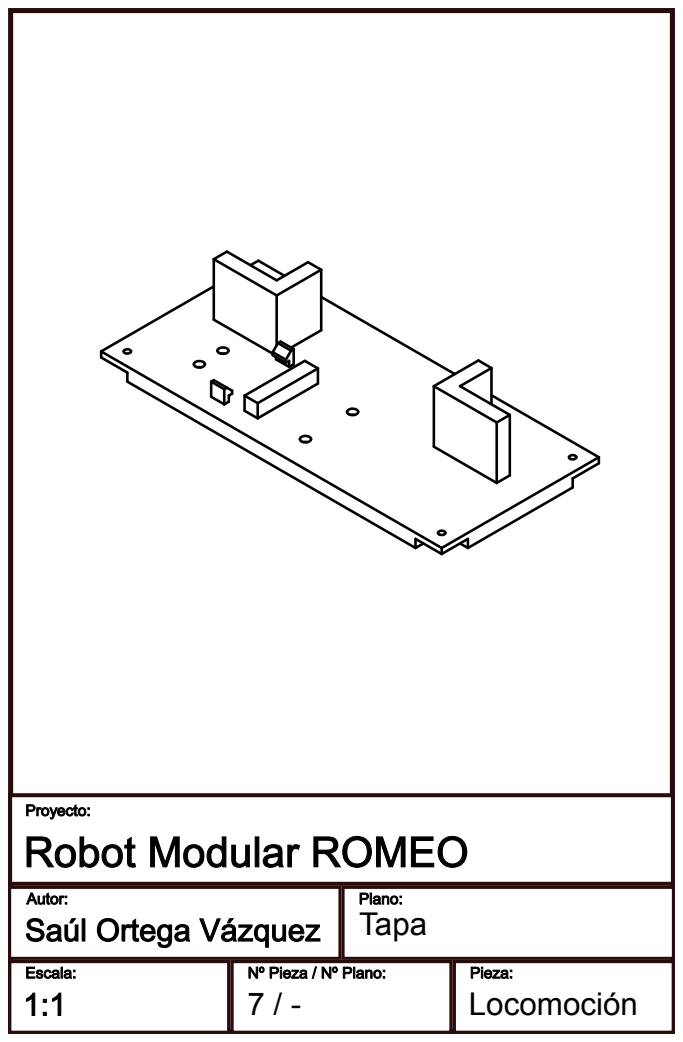
[picture p149: page 1]
Tapa; Locomoción
