SaulOrtegaVaz/ROMEO/Memoria/Planos/Locomocion/Locomocion_Alzado.pdf

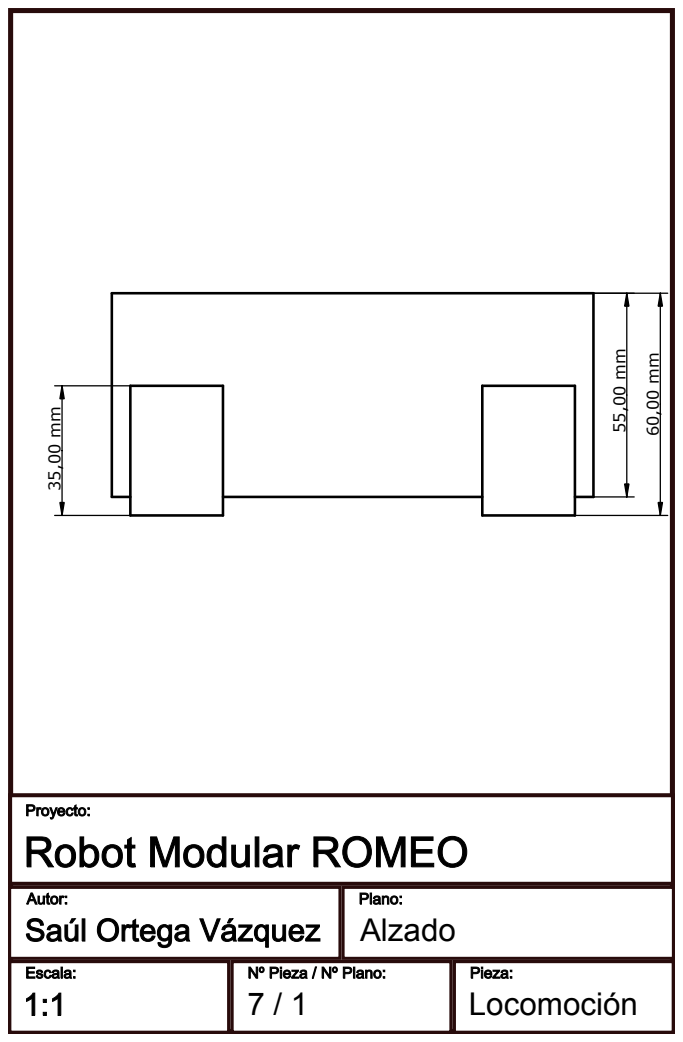
[picture p150: page 1]
Alzado; Locomoción
