SaulOrtegaVaz/ROMEO/Memoria/Planos/Locomocion/Locomocion_AlzadoTapa.pdf

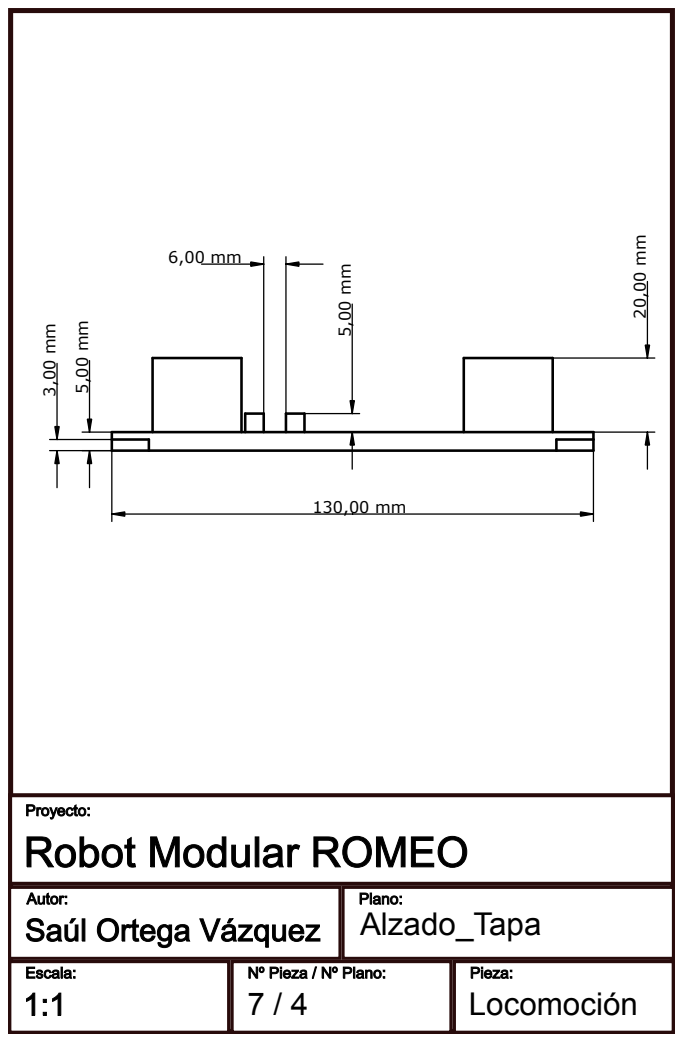
[picture p151: page 1]
Alzado_Tapa; Locomoción
