SaulOrtegaVaz/ROMEO/Memoria/Planos/Locomocion/Locomocion_AlzadoTapaMotor.pdf

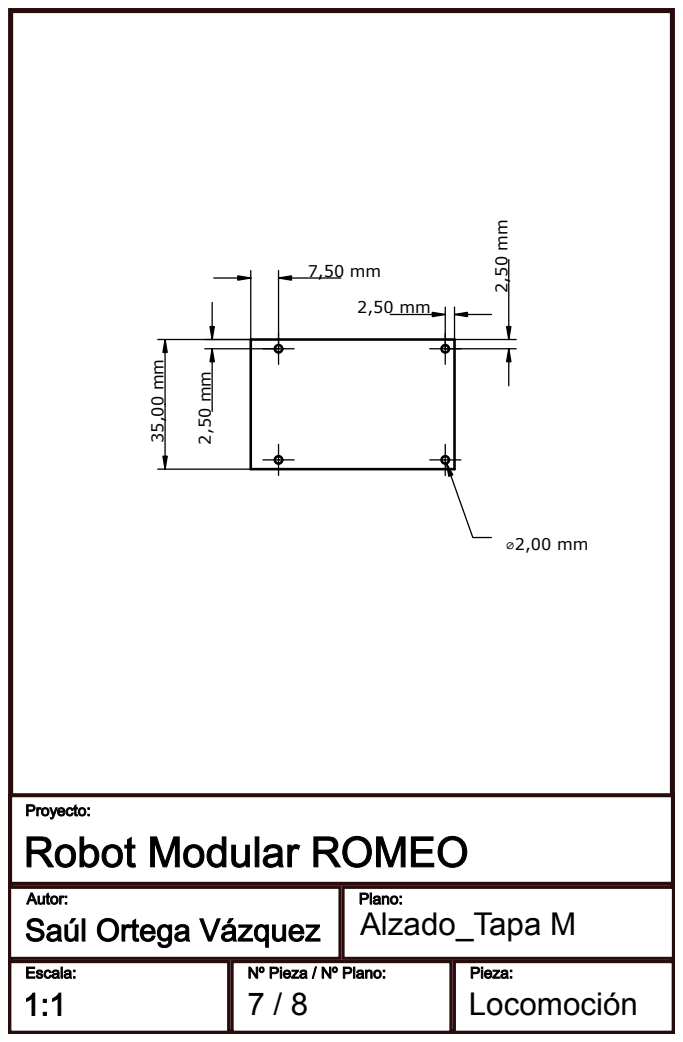
[picture p152: page 1]
Alzado_Tapa M; Locomoción
