SaulOrtegaVaz/ROMEO/Memoria/Planos/Locomocion/Locomocion_PerfilIzqTapa.pdf

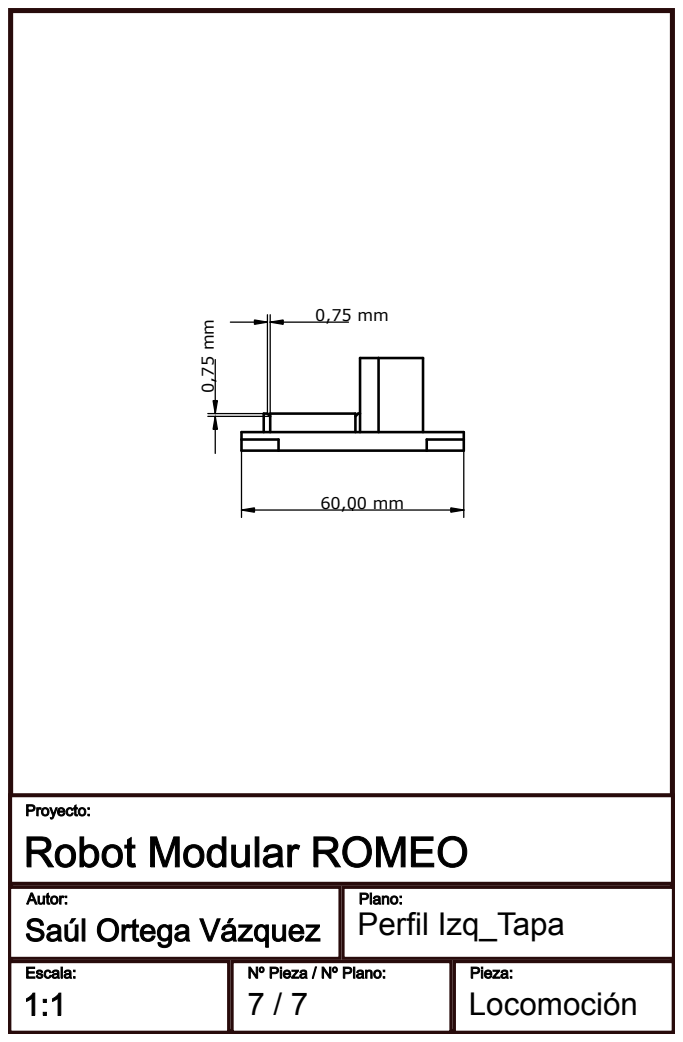
[picture p153: page 1]
Perfil Izq_Tapa; Locomoción
