SaulOrtegaVaz/ROMEO/Memoria/Planos/Locomocion/Locomocion_PlantaPost.pdf

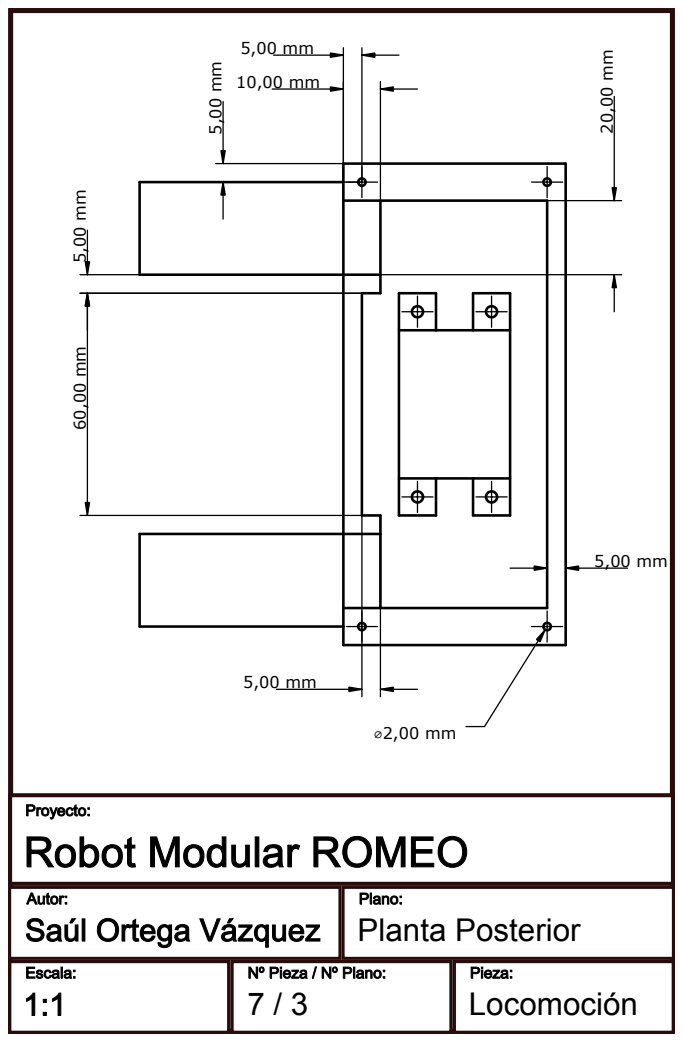
[picture p154: page 1]
Locomoción; Planta Posterior
