SaulOrtegaVaz/ROMEO/Memoria/Planos/Locomocion/Locomocion_PlantaPostTapa.pdf

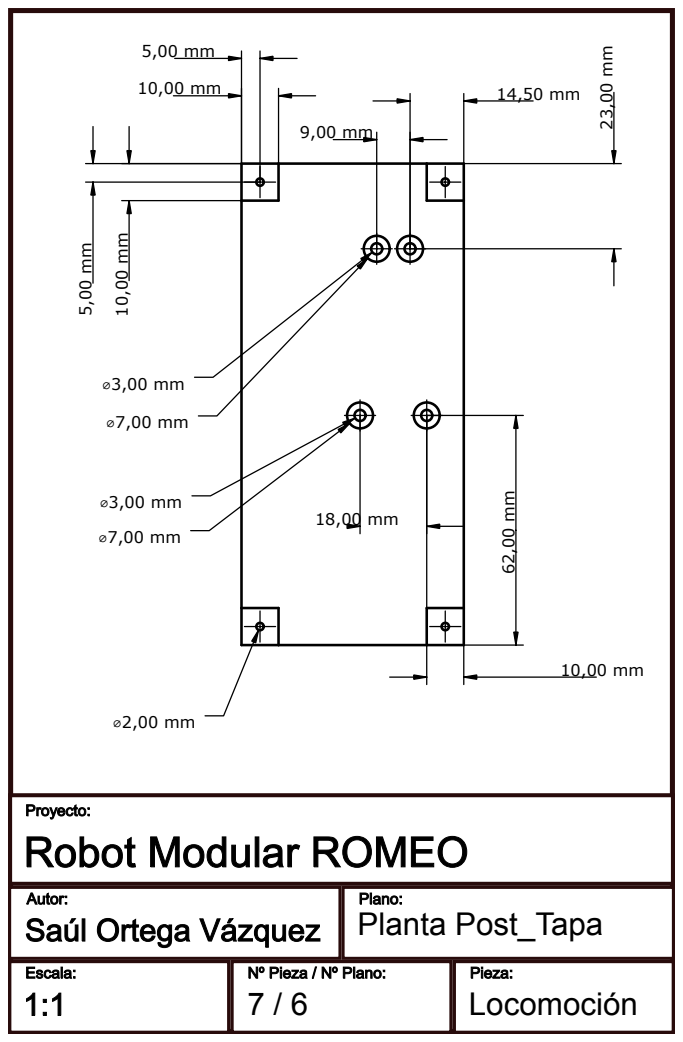
[picture p155: page 1]
Locomoción; Planta Post_Tapa
