SaulOrtegaVaz/ROMEO/Memoria/Planos/Locomocion/Locomocion_PlantaTapa.pdf

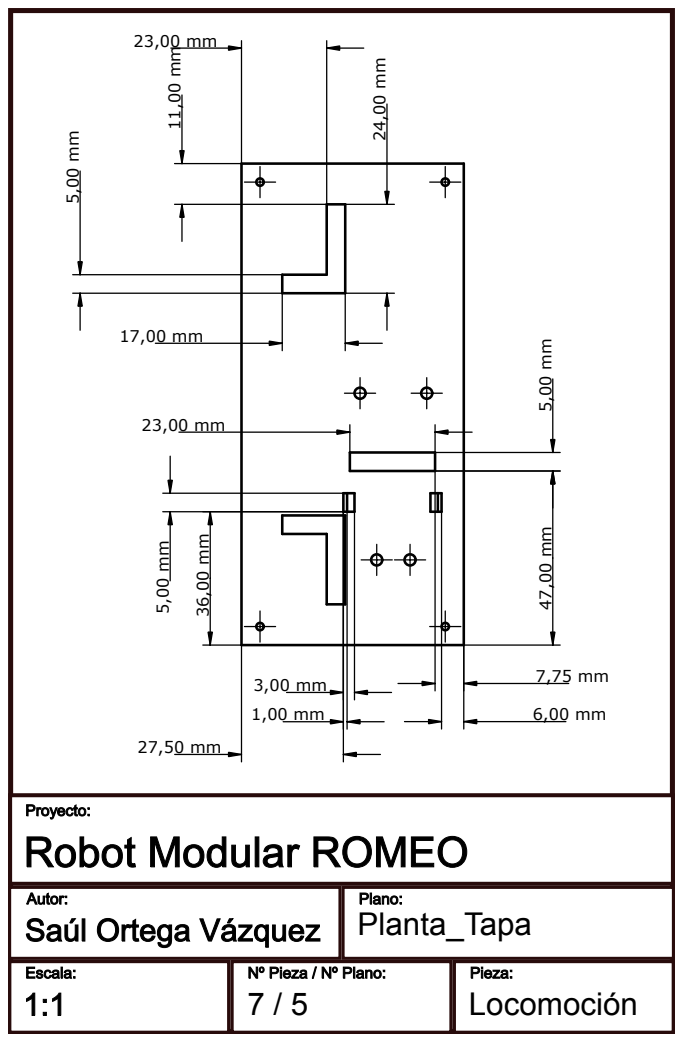
[picture p156: page 1]
Locomoción; Planta_Tapa
