SaulOrtegaVaz/ROMEO/Memoria/Planos/Locomocion/Locomocion_PlantaTapaMotor.pdf

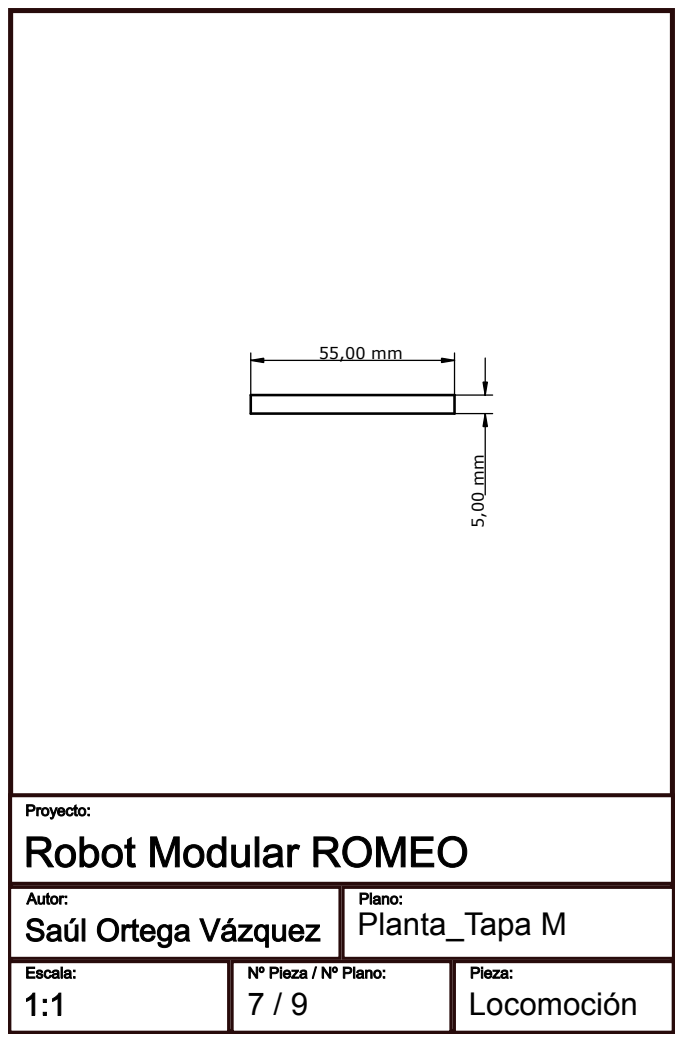
[picture p157: page 1]
Planta_Tapa M; Locomoción
