SaulOrtegaVaz/ROMEO/(commit log)

2018-01-18 Proyectos de FreeCAD
    Proyectos de FreeCad de los modulos de control y alimentación, de un modelo de conector y de un aspecto general del robot
    [Alimentacion.FCStd, Conector.FCStd, Control.FCStd, General.FCStd]
2018-01-18 Lista de Materiales
    Lista de materiales y componentes de los diferentes modulos
2018-01-23 Proyectos de FreeCAD
    Proyecto de modulo Comunicacion
    [Comunicacion.FCStd]
2018-01-25 Proyectos de FreeCAD
    Proyecto de modulo de Locomocion
    [Locomocion.FCStd]
2018-01-30 Added banggood neodymium magnets
2018-03-09 Modulo Alimentacion
    Adaptacion de las medidas a los componentes.
    [Alimentacion.FCStd]
2018-03-09 Proyectos FreeCAD
    Adaptaptacion de las medidas a los componentes.
    [Comunicacion.FCStd, Conector.FCStd, Control.FCStd, Locomocion.FCStd]
2018-03-09 Correccion de archivos
    [Alimentacion.FCStd, Comunicacion.FCStd, Conector.FCStd, Control.FCStd, Locomocion.FCStd]
2018-03-09 Proyecto FreeCAD modulos
    Adaptacion de las medidas a las medidas de los componentes.
    [Alimentacion.FCStd, Comunicacion.FCStd, Conector.FCStd, Control.FCStd, Locomocion.FCStd]
2018-03-09 PruebaConexionCONTROL-EXTERIOR
    Programa de prueba para comunicar el modulo de control con el exterior (un pc desde el navegador web)
2018-03-30 Proyectos FreeCAD modulos
    Cambios en el hueco de uUSB
    [Alimentacion.FCStd, Control.FCStd]
2018-04-11 Programa Control en prueba
    Control como AP dando web para recibir ssid y pass de red externa a la que debe conectarse y guardado en EEPROM.
    Estructura en ControlAP y ControlEstacion
2018-04-25 Añadidos los STL
    [Alimentacion_Carcasa.stl, Alimentacion_Soporte.stl, Alimentacion_Tapa.stl, Comunicacion_Carcasa.stl, Comunicacion_SoporteB_Movil.stl, Comunicacion_TapaA.stl, Comunicacion_TapaB.stl, Control_Carcasa.stl]
2018-04-26 GCODE Piezas
    [Locomocion_Tapa.stl, Locomocion_TapaMotor.stl]
2018-05-29 Programa Prueba
    Cambios en el programa de prueba
2018-06-25 Conectores Corregidos
    Parte Superior corregida
    [ConectorMSup.stl, ConectorSUP.stl]
2018-06-27 First cut of simplified remote app
2018-09-06 Reworked to share source
    [controlApp.cpp, device.cpp, deviceApp.cpp]
2018-09-12 Fixed config of elements
    [controlApp.cpp, device.cpp, deviceApp.cpp]
2018-09-26 Cambios y mejoras en el programa
    cambios en device.cpp, device.hh, controlApp.cpp y deviceApp.cpp
2018-10-02 Partes Memoria
    Actualizacion de las partes de memoria
2018-10-16 Cambios en programa
    Cambios en el servidor (añadido funcion write) y en controlApp
2018-10-23 Some rework on CMD dispatching
    [controlApp.cpp, device.cpp, deviceApp.cpp]
2018-11-20 cambios en programa
    Cambios en device.cpp y cambios en comentarios
2018-11-27 Cambios en Memoria
    Estructura de las diferentes partes de la memoria por separado en word. Y partes de Objetivos, Procedimiento, Resumen y Contenido-->dis_mecanico en espera de correccion
2018-11-29 cambios en programa
    Correcciones de errores y mejoras en las partes del programa de client.hh, controlApp.cpp, device.cpp y device.hh
    [controlApp.cpp, device.cpp, deviceApp.cpp]
2018-12-05 Fixed bug in automated distance read back
    [device.cpp]
2018-12-18 Memoria
    Se ha separado dis_mecanico en dos: dis_mecanico y dis_electronico.
    También se ha mejorado la estetica respecto al documento original, se han corregido fallos en los datos y se han añadido y distribuido mejor las imagenes y tablas.
2019-01-14 Fixed router and also TCP race
    [controlApp.cpp, deviceApp.cpp]
2019-01-14 New led features
2019-01-14 New led features on server
2019-01-16 Memoria
    Subidas partes de Introducción y conclusiones.
    Se ha mejorado Antecedentes y se ha añadido el nuevo documento a bibliografia.
2019-01-21 Memoria
    Planos de piezas de los modulos
    [Alimentacion_SeccionXZ.FCStd, Alimentacion_SeccionYZ.FCStd]
2019-03-27 Memoria
    Cambios y mejoras en todos los documentos, aumento de los antecedentes y la bibliografia.
2019-03-27 Documento Maestro
    Prueba de documento maestro, se ha hecho mediante una copia de los documentos para evitar posibles errores.
2019-03-29 Capítulo de diseño lógico
2019-04-11 Memoria
    Prueba de documento maestro
2019-05-06 Memoria
    Maestro completado con formato de textos, y pdf de la memoria completa con planos incluidos.
2019-05-28 Programa Final
    Programa final entregado en el TFG
2019-05-28 Actualizacion de archivos
    Se han dejado sólo los archivos utilizados y útiles del proyecto
